M4dm0nky/cyd-buddy/case/README.md

# MadBuddy Gehäuse "Kopf mit Stirn"

Parametrisches OpenSCAD-Gehäuse (OpenSCAD 2021.01) für das ESP32-2432S028 (CYD 2,8", Micro-USB + USB-C) und ein Seeed XIAO ESP32S3 Sense mit Kameraplatine (Linse in der Stirn, schaut nach vorn).

Dateien: `madbuddy_case.scad` und `xiao_cam_common.scad` (Kamera: Tasche, Riegel, XIAO-Wiege, Prüfkörper; gemeinsam mit dem Roboter nutzbar). Teil wählen mit `-D 'part="front"'` (`front`, `back`, `cam_clip`, `frame_test`, `assembly`, `section`, `cam_section`, `collision`, `info`).
Alle Maße stehen oben in der Datei mit Kommentar: `QUELLE: Originalzeichnung`, `GEMESSEN` oder `VORLÄUFIG`.

## Teile

| Teil | Datei | Inhalt |
|---|---|---|
| front | `stl/madbuddy_front.stl` | Kopfschale mit Display-Fenster (nach vorn angefast), Stirn, Kameratasche (Linsenloch Ø 6,7 mit 45°-Fase, Rahmen mit Riegelnuten, FPC-Schlitz), XIAO-Wiege (4 Pfosten), 4 Schraubdome (M3, von hinten) |
| cam_clip | `stl/madbuddy_cam_clip.stl` | Kamera-Riegel: flache U-Platte, 1,2 mm dick, hält den Kamerakörper in der Tasche (1× drucken) |
| back | `stl/madbuddy_back.stl` | Rückwand mit Falz, USB-C-Öffnung, SD-Aussparung, BOOT/RESET-Fenster, Lüftungsschlitze, Platinen-Andrückfüße mit Zentrierstift, Kabelkanal, Fuß mit 15° Neigung |
| frame_test | `stl/madbuddy_frame_test.stl` | flacher Streifen (2 mm Front + Display-Auflage) zum Prüfen von Fenstermaß, Glas-Sitz und Lochbild in ca. 20 min |
| assembly / section | nur Ansicht (`render/*.png`) | alles mit farbigen Prüfkörpern |

## Druck (PETG)

- 0,2 mm Schichthöhe, 3 Wände, ohne Stützen. Die STL-Dateien liegen schon in Druckausrichtung.
- front: Gesicht nach unten auf dem Bett (Fenster und Linsenloch sind Durchbrüche, Fenster-Fase ist ein Überhang von 35°).
- back: Rückseite (Außenfläche) liegt flach unten, der Fuß hat nur 15° Überhang.
- frame_test: Gesicht nach unten.
- cam_clip: flach auf dem Bett (1,2 mm dick, 1 Lage Wandlinie genügt nicht, 3 Wände einstellen).
- Schrauben: 4× M3×8 (Senkung hinten, Kernloch 2,6 mm in den Domen; bei PETG selbstschneidend).
- Mindestwand 2,4 mm, Passungsspiel `fit = 0,3 mm` (Variable).
- **Wer `front` schon gedruckt hat, muss es neu drucken** (Linsenloch, Tasche und Wiege sind neu).

## Kamera und XIAO einbauen (Stufe 2)

1. `front` liegt mit dem Gesicht nach unten. Kamera von hinten in die Tasche legen: Linse (Tubus) durch das Loch Ø 6,7, Körper 8 × 8 an den Anschlag, das FPC zeigt nach +X (rechts im Blick von vorn) und läuft durch den Schlitz.
2. Riegel `cam_clip` von der FPC-Seite in die beiden Nuten schieben, bis der Quersteg am Tascheneck anliegt. Er klemmt mit 0,1 mm Übermaß, kein Kleber nötig (optional ein dünnes Klebepad auf der Kamerarückseite). Das FPC liegt im Riegel-Ausschnitt.
3. XIAO-Stapel (Sense-Platine zur Kamera, Stecker am Ende zur Kamera) zwischen die Pfosten einschieben, bis die Lippen der Klemmstege (je 0,7 mm Schnappmaß) über der Rückseite einrasten. Das FPC in den Klappstecker der Sense-Platine stecken: lockere Schleife, nicht knicken (Biegeradius mindestens 2 mm; die Luftlinie Körperkante bis Stecker ist laut `check.ps1` unter 16 mm). Die Längsseiten des Stapels bleiben für die angelöteten Drähte frei.
4. Rückwand aufsetzen: Ihre Anschlagpfosten enden 0,1 mm unter der Stapelrückseite und halten den Stapel nach hinten. Die Lage des Stapels relativ zur Linse ist `xiao_offset`.

## Prüfung

`& case\check.ps1` (aus PowerShell im Repo-Ordner) führt alles aus (STL ohne Warnungen, Standsicherheit, Standebene, Kollision gegen alle Prüfkörper inkl. Linsen-Freiraum und aktiver Fläche mit Sichtkegel, Selbsttest der Kollisionsprüfung, PNG-Renders). Exitcode ungleich 0 bei jedem Fehler.
Gegenprobe: `check.ps1 -Define window_shrink=2 -NoPng` muss fehlschlagen (Fenster 2 mm schmaler).
Kamera-Prüfungen (ohne `-Define`): Selbsttest (Kamerakörper +0,6 mm muss die Tasche treffen), `clip_test` (Riegel in Einbaulage schneidet den Rahmen durch das Übermaß), Rahmen und Wiege durchdringen das Rückteil nicht und bleiben 0,8 mm innerhalb der Kopfhaut, FPC-Luftlinie (Körperkante bis Stecker) höchstens 16 mm. Bild `render/madbuddy_kamera_schnitt.png` zeigt den Schnitt bei X = 0.

## Maße

- Aus Originalzeichnung (`QUELLE`): Platine 86 × 50, Eckradius 4, Löcher Ø3,2 mit 4,0 mm Randabstand, Displaymodul 69,2 × 50 × 2,3, LCD-Glas 64,75, Fenster = AA + 0,3 mm je Seite. Die Zeichnungs-AA (57,6 × 43,2, mittig im Glas) passte nicht.
- Gemessen (2026-10-26, nach Testdruck): bespielte Fläche 58,8 mm breit (Fenster rechnet mit 59), beginnt 10 mm nach der linken Platinenkante (Blick von vorn). Höhe 44,3 mm ist daraus hochgerechnet (VORLÄUFIG).
- Gemessen: USB-Buchsen-Lage entlang der Schmalseite (Micro ab 9,67 mm, USB-C 17,88 bis 27,32 mm, von der Kante mit dem SD-Slot).
- VORLÄUFIG (Datenblatt/Schätzung): Platinendicke, Displayhöhe über Platine (4,5), Micro-USB-Breite, alle Höhen (z) der Buchsen/Stecker, SD-Slot (Länge, Lage, Höhe), BOOT/RESET-Lage, Rückseitenbauteile (8 mm, Randstreifen), XIAO-Stapel (Höhe 15, Platinendicke 1,2, Lage und Höhe des Kamerasteckers), Tubuslänge der Kamera (2,7), Sichtwinkel, Wandöffnungen, Schwerpunkt-Massen. Kameramaße (OV3660: Körper 8,0, Tiefe 5,3, Tubus Ø 6,2, FPC 21,2 × 6,5) stammen aus der Seeed-Zeichnung; den Aufdruck am eigenen Modul prüfen (`cam_type`).

## Offene Punkte

- Micro-USB hat standardmäßig keine Wandöffnung (`open_micro_usb = false`), Innenfreiraum bleibt.
- SD-Slot liegt in der Konstruktion an der unteren Längskante; dort steht der Kopf auf dem Fuß, die Karte lässt sich dann nur bei angehobenem Gerät stecken. Die Firmware nutzt die SD-Karte nicht (geprüft 2026-10-26), daher bleibt das so.
- Standsicherheit ist eine Schätzung (Massenliste in der SCAD). Ohne die Zusatztiefe `rear_extra = 10` liegt das Lot bei 15° praktisch auf der Kippkante.
- XIAO-USB-C ist im Gehäuse nicht zugänglich (nur Programmierung vor dem Einbau).
- Fenster, Lochbild und Glas-Sitz zuerst mit `frame_test` prüfen. **Stand 2026-10-26: 1. Testdruck: Lochbild passt, Fenster lag falsch, korrigiert, 2. Testdruck steht aus.**
- Strom über den USB-C des CYD nur mit Kabel USB-A auf USB-C (keine CC-Widerstände). Das Netzteil braucht ca. 1 A, weil die Kamera mitversorgt wird.

## Variante 2 Roboter

Sitzender Roboter mit Akku: Kopf mit dem CYD, Oberkörper mit der Kamera in der Brust, Po und Beine mit dem Akkuhalter DFRobot DFR0969 (2 × 18650), Laden per USB-C im Boden. Alle Teile werden gesteckt und teilweise verschraubt. Datei: `madbuddy_roboter.scad` (Teil wählen mit `-D 'part="seat"'`). Spec: `docs/superpowers/specs/2026-10-26-roboter-gehaeuse-design.md` (Form) und `2026-10-27-roboter-druckteile-design.md` (Druckteile).

Stand: druckbar, die Maße des Akkumoduls sind **vorläufig** (Datenblatt, noch nicht nachgemessen).

### Teile

STL liegen in `stl/roboter_<teil>.stl`, schon in Druckausrichtung (ohne Stützen). Die Farben sind der Vorschlag aus dem Entwurf.

| Teil | Farbe | Menge | Hinweis |
|---|---|---|---|
| `head_front` | blau | 1 | Gesicht nach unten; mit eingesetzter Blende und Zierschrauben auch als `head_front_ams` |
| `bezel` | schwarz | 1 | Blende, Steg nach oben |
| `head_back` | blau | 1 | Rückseite auf dem Bett |
| `ear` | gelb | 2 | Außenseite auf dem Bett, Zapfen nach oben |
| `deco` | silber | 1 Platte | 10 flache Zierschrauben-Einlagen (4 Kopf, 4 Brust, 2 Ohr) |
| `torso_front` | orange | 1 | Brust auf dem Bett |
| `torso_back` | orange | 1 | Rückseite auf dem Bett |
| `neck` | schwarz | 1 | stehend auf dem unteren Flansch |
| `arm` | orange | 2 | links = gespiegelte Datei `roboter_arm_l.stl` |
| `hand` | schwarz | 2 | flache Unterseite auf dem Bett |
| `seat` | blau | 1 | auf dem Kopf gedruckt, Fach nach oben offen |
| `bottom` | blau | 1 | Standfläche auf dem Bett |
| `foot` | schwarz | 2 | Rückseite (Zapfenloch) auf dem Bett |

3MF zum Öffnen in Bambu Studio:
- `3mf/roboter_teile.3mf`: alle 18 Druckkörper nebeneinander, jeder bekommt im Slicer seine Farbe.
- `3mf/roboter_ams.3mf`: Gruppe „kopf“ (Kopfschale, Blende, 4 Zierschrauben als drei Bauteile eines Objekts, in Einbaulage) plus die übrigen Teile einzeln. Im Slicer weist man den drei Bauteilen je eine Farbe zu.
- Neu erzeugen: `check_roboter.ps1` (Schritt 1c) oder `tools/make_3mf.ps1`; Werkzeug `tools/stl2_3mf.py` (`--group NAME`, `--end`, `--arrange`).

### Druck (PETG)

- 0,2 mm Schichthöhe, 3 Wände, ohne Stützen, Überhänge höchstens 45°.
- `torso_front`: Stützen nur am Linsenloch (Fase 45° bei geneigter Achse, bis ca. 60° Überhang), z. B. mit Support-Painting/Support-Blocker in Bambu Studio. Überall sonst ohne Stützen.
- Steckzapfen sind als Presspassung gedacht (`fit_peg = 0,15 mm`). Zuerst ein Zapfen-Probestück oder den Fuß drucken und die Passung prüfen; bei Bedarf `fit_peg` ändern.
- Kernlöcher für M3 sind Ø 2,6 mm (selbstschneidend in PETG, mindestens 7,5 mm tief).
- Die Zierschrauben-Einlagen nur als Einlage einkleben oder pressen (Taschen sind 0,15 mm größer).

### Schrauben (M3)

Insgesamt 20 Stück. Jede Zahl ist aus `madbuddy_roboter.scad` belegt; der Beleg nennt Variablen- und Modulnamen (in der Datei suchen), keine Zeilen, weil die Datei wächst.

| Anzahl | Länge | Wo | Beleg |
|---|---|---|---|
| 4 | M3×8 | Kopf: `head_back` an `head_front` | 4 Dome `dome_pts` (`dome_x`, `dome_y`); Länge: `back_t` 2,6 abzüglich `cbore_t` 1,8 plus `pilot_len` 7,5 = 8,3 |
| 2 | M3×10 | Hals oben an `head_back` | Modul `neck_pilots`, `neck_fl_t` 2,8 plus `neck_pilot_len` 7,6; Kommentarblock „MONTAGEFOLGE“, Schritt 2 |
| 2 | M3×10 | Hals unten an `torso_front` | Modul `neck_pilots_t`, Kernloch `neck_pilot_t` 7,6; Kommentarblock „MONTAGEFOLGE“, Schritt 1 |
| 4 | M3×28 | Oberkörper: `torso_back` an `torso_front` | 4 Dome `t_dome_pts`; Länge: `t_d` / 2 = 22 abzüglich `cbore_t` 1,8 plus `t_dome_pilot` 9 = 29,2; Kommentarblock „MONTAGEFOLGE“, Schritt 3 |
| 4 | M3×10 Flachkopf | Oberkörper von unten auf `seat` | `t_seat_pts`, `seat_screw_l = 10`; Einschraubtiefe geprüft mit dem Prüfteil `screw_seat` (`check_roboter.ps1`, Abschnitt 3h) |
| 4 | M3×10 Flachkopf | `bottom` an `seat` | `dome_pts_s`; Länge: `bot_t` 2,4 − `cbore_t` 1,8 + `boss_h` 2,0 + `pilot_s_len` 7,6 = 10,2; Kommentarblock „MONTAGEFOLGE“, Schritt 5 |

Summe: 4 × M3×8, 12 × M3×10, 4 × M3×28. Das passt zur Massenliste „20 × M3“ (Eintrag „Schrauben (20 x M3)“ in der Massenliste). Die Zierschrauben sind gedruckte Einlagen, keine echten Schrauben.

### Montagereihenfolge

1. Hals von oben mit 2 × M3×10 auf `torso_front` schrauben (`torso_back` ist dabei verschraubt, der Kopf fehlt).
2. Rückwand des Oberkörpers abnehmen, Kopf auf den Hals setzen, 2 × M3×10 von unten durch die Halsschlitze eindrehen.
3. Kamera und XIAO einbauen, solange `torso_back` noch abgenommen ist (bei geschlossenem Oberkörper kommt man nicht an die Tasche):
   1. Kameramodul von hinten in die Tasche schieben (Linse durch das Loch), FPC durch den Schlitz nach +X führen.
   2. `cam_clip` (Riegel) von der +X-Seite in die Nuten schieben (Übermaß 0,1 mm, Presssitz).
   3. XIAO-Stapel von hinten zwischen die Pfosten schieben, die Lippen der Pfosten rasten über die Rückseite ein (FPC in den Stecker).
   4. `torso_back` aufschieben und mit 4 × M3×28 schließen: Klemmsteg und Stützwand in `torso_back` legen sich hinter den Stapel. Der Weg ist per Zwischenstellungen geprüft (`asm_cam`, `asm_clip`, `asm_stack`, `asm_close`).
4. Arme in den Oberkörper stecken, Hände auf die Arme stecken, Ohren in den Kopf stecken, Blende in die Nut drücken, Zierschrauben einsetzen.
5. Oberkörper mit Hals und Kopf auf `seat` stecken und von unten mit 4 × M3×10 verschrauben (Schraubendreher durch den offenen Boden).
6. Akku einlegen, 5 V und GND verdrahten (Schalter, Kabel nach oben), `bottom` mit 4 × M3×10 schließen. Füße vorn auf die Beine stecken.

Kamera im Roboter: Der Sichtkegel (102° diagonal, 85° horizontal) wird nur 26 mm lang geprüft, weil die Füße ab ca. 27 mm unten im Bild liegen (Entscheidung 2026-10-28).

Jede Schraube ist im Modell mit einem Schraubendreher-Prüfkörper Ø 6 × 60 auf Erreichbarkeit geprüft (`check_roboter.ps1`, Schritte 3g/3h).

### Prüfung

`& case\check_roboter.ps1` (aus PowerShell im Repo-Ordner): STL aller Teile ohne Warnung, Standsicherheit, Kollisionen, Montage-Erreichbarkeit mit Selbsttests, 3MF (lesbar, größer als 10 kB, richtige Anzahl Objekte und Bauteile), PNG-Renders. Exitcode ungleich 0 bei jedem Fehler.

### Offene Punkte

- Maße des Akkumoduls DFR0969 (Platine, Lage der Buchse, des Schalters, der LED) sind **VORLÄUFIG** nach Datenblatt. Vor dem ersten Druck von `seat` und `bottom` das echte Modul nachmessen.
- Presspassung der Zapfen (`fit_peg`) und die Länge der Schrauben sind noch nicht am gedruckten Teil getestet.
- Die Lage von Schalter und LED im Boden hängt am Modul (siehe oben).
- Kamera-Halter im Oberkörper: eigener Plan `docs/superpowers/plans/2026-10-27-kamera-halter.md`.
