M4dm0nky/cyd-buddy/reference/ha_buddy_ota/README.md

Vorlage aus dem HA-Buddy (ESP32-S3, HA-Medienordner). Nicht kompilieren; Portierung siehe docs/superpowers/specs/2026-10-25-cyd-buddy-design.md Abschnitt 8.
Einzige Änderung gegenüber dem Original: LAN-Adressen in ota-7in.md durch Platzhalter ersetzt (öffentliches Repo).
