M4dm0nky/cyd-buddy/docs/FORTSCHRITT.md

# Fortschritt MadBuddy

Neueste Einträge oben. Format und Regeln: `docs/superpowers/plans/2026-10-25-cyd-buddy.md`, Abschnitt „Fortschritts-Protokoll“.

## Kamera-Firmware Phase A – Task 1: Spike `cam/` (XIAO) – ERLEDIGT, am Gerät gemessen
- Zeit: 2026-10-29 (Sonnet), Branch `feature/kamera-firmware`
- Weg: **Weg 1** (pioarduino 55.03.312-1, Arduino als IDF-Komponente, ESP-DL v3 `human_face_detect`). Grund: baut sauber, neuere ESP-DL; Weg 2 (Arduino-Kern 2.0.17) bleibt Rückfall.
- Anpassungen gegenüber dem Plan: Pixeltyp heißt `DL_IMAGE_PIX_TYPE_RGB565BE` (nicht `..._RGB565`); zusätzlich `CONFIG_AUTOSTART_ARDUINO=y` in `cam/sdkconfig.defaults`, sonst fehlt `app_main` beim Linken. Erzeugtes (`managed_components/`, `dependencies.lock`, `sdkconfig.cam`, `CMakeLists.txt`) steht in `cam/.gitignore`.
- Build: SUCCESS, Flash 908 009 B von 3 342 336 B (27,2 %), RAM 36 516 B (11,1 %).
- Neu: `cam/` (Kamera, Erkennung, Mess-`main.cpp`), `src/logic/cam_xiao.h` (`CamFace`, `cam_box_to_face`), `tools/cam-serial.py` (pyserial 3.5 vorhanden).
- Am Gerät (COM7, Kabel-Flash, Opus mit Nutzer): PSRAM 8 MB, Kamera und Erkennung starten. **10–12 Bilder/s, 77–83 ms pro Bild** → Weg 1 bleibt. Gesicht aufrecht im Bild: 17 Treffer mit RGB565**BE**, 0 mit LE (Diagnose lief beide abwechselnd) → BE ist richtig.
- Gefunden und behoben:
  - Konsole und `Serial` lagen auf UART0 = GPIO 43/44 (genau die CYD-Leitung) → `CONFIG_ESP_CONSOLE_USB_SERIAL_JTAG=y`, `-DARDUINO_USB_MODE=1 -DARDUINO_USB_CDC_ON_BOOT=1`.
  - „Do not support Concat“ + Absturz beim Modell-Laden: esp-dl baut nur die Operatoren angemeldeter Modelle; angemeldet hatte nur `esp-sr` (kommt mit dem Arduino-Kern). → `custom_component_remove = espressif/esp-sr`, damit `DL_COMPILE_ALL 1`.
  - Build im Dropbox-Ordner scheitert (Cloud-Platzhalter, WinError 32; `com.dropbox.ignored` greift hier nicht). → `tools/cam-build.ps1` spiegelt `cam/` und `src/logic/` nach `%LOCALAPPDATA%\3zoll-cam` und baut dort (`-Upload -Port COM7` zum Flashen). Bin: `%LOCALAPPDATA%\3zoll-cam\cam\.pio\build\cam\firmware.bin`.
- Lage der Kamera: Beim Halten in der Hand stand das Bild auf dem Kopf; aufrecht wird erkannt. Die Drehung (`CAM_FLIP_180`, per `set_vflip`/`set_hmirror`) wird erst beim Einbau festgelegt.

## Kamera + Gehäuse – Teil 1: Gehäuse-Entwurf – ERLEDIGT, wartet auf Testdruck
- Zeit: 2026-10-26 (Opus plant und prüft, Sonnet baut das SCAD-Modell), Branch `feature/kamera-gehaeuse`
- Entscheidung: Kamera = **Seeed XIAO ESP32S3 Sense** (eigener Rechner mit PSRAM, erkennt Gesichter selbst, schickt dem CYD nur Koordinaten). Direkt am CYD geht keine Kamera: Es sind nur GPIO 22/27/35 frei, und PSRAM fehlt. Bestellt **ohne Header**. Spec: `docs/superpowers/specs/2026-10-26-kamera-gehaeuse-design.md`.
- Gemacht: `case/madbuddy_case.scad` (parametrisch, OpenSCAD 2021.01 per winget), Form „Kopf mit Stirn“ 114 × 82 × 30 mm, Linse mittig über dem Display, Fuß mit 15°, nur USB-C nach außen (`open_micro_usb = false`), STL-Dateien `front`/`back`/`frame_test`, Prüfskript `case/check.ps1`.
- Maße: Platine, Löcher und Display aus der Originaldoku (witnessmenow/ESP32-Cheap-Yellow-Display: `Dimensions.png`, Datenblatt JC2432A028N). USB-Lage vom Nutzer gemessen (ab SD-Kante: Micro ab 9,67 mm, USB-C 17,88–27,32 mm). Die übrigen Werte sind im SCAD als VORLÄUFIG markiert.
- Prüfung: `& case\check.ps1 -NoPng` → alles grün (3 STL ohne Warnung, Stand: Lot 6,9 mm vor der hinteren Kippkante, nichts unter dem Fuß, Kollision leer, Selbsttest erkennt Treffer). Gegenprobe `-Define window_shrink=2` → `[FAIL] Kollision` (288 Facetten), exit 1. Danach läuft kein OpenSCAD-Prozess mehr.
- Hinweis: `powershell -ExecutionPolicy Bypass` wird von der Rechteprüfung abgelehnt, deshalb das Skript direkt mit `& case\check.ps1` starten.
- Nächster Schritt: Nutzer druckt `case/stl/madbuddy_frame_test.stl` und meldet die Passung (Fenster über der Leuchtfläche, Lochbild). Danach Maße anpassen und das ganze Gehäuse drucken.
- Offen: Teil 2 Verkabelung (Pinreihenfolge P1/CN1 am Foto prüfen, bevor gelötet wird). Teil 3 Firmware (`cam/` für den XIAO, `src/logic/cam_link.*` + `Serial2` am CYD), wird geplant, sobald die Hardware da ist. Der USB-C des XIAO ist im eingebauten Zustand nicht erreichbar, deshalb vor dem Einbau flashen und danach per WLAN aktualisieren.

## Umbenennung CYD-Buddy -> MadBuddy – ERLEDIGT (2026-10-25)

Umbenennung CYD-Buddy -> MadBuddy (Portal, mDNS madbuddy.local, Repo M4dm0nky/madbuddy).

## Lokal 4 – Code-Review und Fixes – ERLEDIGT
- Zeit: 2026-10-25 (Review: 3 Sonnet-Prüfer, Funde von Opus am Code/Core-Quellen bestätigt; Fixes: Sonnet in Paketen A/B/C + Nachtrag)
- Behoben: 24,8-Tage-Fehler aller langlebigen Zeitpunkte (`logic/deadline.h`, `due_since`), Nickerchen weckbar, OTA-Umleitung lehnt `@`/fremde Ports ab, Claude-Reihenfolge (späte Ereignisse), Empfänger prüft Schlüssel/Länge vor dem Körper + Handler einmal + Multipart-Grenzen, **Rollback wirksam** (`verifyRollbackLater`, `health_tick` unabhängig vom WLAN), Stall-Lücke im Download, Start-Absicherung (Touch-Warten 10 s, Kalibrier-Plausibilität), 5. Tipp außerhalb der Augen, Simon-Zeitlimit 30 s, Rückblick ignoriert erste Sekunde, Sprite-Neuversuch, OTA-Karte nicht während Arbeit, Speichern vor OTA-Neustart (Haupt-Task), Einstellungen ohne Flackern, Animationen ohne Float-Drift, Aufräumen (testscreen, tote Felder, Kommentare, Doku).
- Prüfung: 180/180 nativ, 18/18 Node, Build Flash 1 475 391 B. Am Gerät (v20261025-2011): `Zustand 1` nach OTA, nach 20 s „neue Firmware als gut bestaetigt“; curl: 100 KB ohne Schlüssel 401, falscher Schlüssel 401, 5 KB 413, Content-Length 1 MB gelogen 413 (alle < 0,35 s, danach Verbindungsabbruch wie vorgesehen), Multipart ohne Schlüssel 401, gültig 204, Ping 200; Heap danach 120 KB, Minimum 60 212 B (vorher 49 776 B); fps 24–26.
- Offen (nicht im Paket): Bildrate (SPI 80 MHz testen, Ring-Spur, Brillen-Raster), Aufteilung von `app.cpp`, Projektkennung im Image generisch, keine Signatur.

## Lokal 3 – Gesicht, F1–F4, Umlaute, Claude-Modus am Gerät – ERLEDIGT
- Zeit: 2026-10-25 (lokal, Opus orchestriert; Sonnet/Haiku umgesetzt; Qwen Sätze-Entwurf)
- Gemacht: Gesicht mit Brauen/Pupillen/Nase/Mund und 22 Ausdrücken; F1–F4 aus der Cloud übernommen und einzeln ausgeliefert (v20261025-1529/-1539/-1549/-1611); echte Umlaute mit U8g2 Latin-1 (v-1637); Claude-Modus (Zustandslogik, HTTP-Empfänger mit Schlüssel, Darstellung, Hook-Skript; v-1648/-1703), globale Hooks in `~/.claude/settings.json` (Sicherung `settings.json.bak-20261025-1703`).
- Prüfung: `pio test -e native` → 153/153; `node --test` (ota-publish, gen-phrases, claude-hooks) → 18/18; `pio run -e cyd2usb` → Flash 1 473 891 B. Am Gerät: Endpunkte 200/401/413/400 gemessen; Hook-Ereignisse kommen an (`running` während Bash); Nutzer bestätigt drehenden Ring, „Mist!“ bei Fehler, Blick + gelbe LED bei Rückfrage; fps 24–26 (Ring kurz 24), Heap-Minimum 49 776 B (vorher 63 KB, Webserver).
- Gefunden & behoben: Open-Meteo chunked → `useHTTP10`; Sonnenbrille zu hoch/blind → mittig + Schachbrett-Raster; erstes Hook-Ereignis ging verloren, weil Node `cyd-buddy.local` beim ersten Mal langsamer als 800 ms auflöst → Konfiguration zuerst per IP (192.168.2.137), Name als Ersatz; Sätze-Check CRLF unter Windows.
- Offen: fps mit Ring knapp unter 25; Heap-Minimum 49,8 KB knapp für TLS (OTA-Abruf im Blick behalten, ggf. Sprite während Manifest-Abruf freigeben); feste IP im Router (Nutzer); Mitte-unten-Touch reagiert kaum (Panel).

## Interaktion Task 10 – Abschluss – ERLEDIGT
- Zeit: 2026-10-25 14:22 UTC
- Gemacht: README-Bedienung ergänzt (High-Five, Blick folgt, Menü 2×3, Füttern, Timer, Sprechblasen, Rituale, Rückblick, Hunger/Krankheit/Charakter); dabei die veralteten Abschnitte „Schlaf“ (jetzt Uhrzeit + Ruhe) und „Testbild“ (jetzt Touch-Einrichtung) an den lokalen Stand angepasst; Sätze-Generator unter Entwicklung. Abschlussprüfung.
- Dateien: README.md
- Prüfung: `pio test -e native` → 124 Tests, 0 Fehler (14 Gruppen; 78 alte + 46 neue: look 4, phrases 3, speech 14, care 17, pomodoro 5, je 1 neu in mood, face_model, weather_mood). `node --test tools/*.test.mjs` → 7 Tests, 0 Fehler. `node tools/gen-phrases.mjs --check` → aktuell. `pio run -e cyd2usb` → SUCCESS, RAM 17,5 % (57 340 B, +376 B gegenüber 56 964 B vor F1), Flash 74,5 % (1 464 019 B); `firmware.bin` 1 493 696 B < 1 966 080 B
- Gegenprobe: je Logik-Gruppe in Task 1, 2, 3, 4, 6, 7, 8 (siehe dort)
- Nächster Schritt: **Lokaler Claude** übernimmt `claude/dreamy-galileo-bvdw39` nach `buddy-umsetzung` (Fast-Forward), prüft am Gerät und veröffentlicht je Funktion ein Release (Spec: F1–F4 einzeln). Hinweis: Alle vier Funktionen liegen in einem Branch; für getrennte Releases die Commits von Task 1–2 (F1), 3–5 (F2), 6–7 (F3), 8–9 (F4) nacheinander bauen.
- Offen/Fragen (Sammlung): (1) Branch `claude/dreamy-galileo-bvdw39` statt `buddy-umsetzung` (Sitzungsvorgabe). (2) frech/verschmust über die Achse `cuddly` (Task 4). (3) SICK als erstes *Grundgefühl* (Task 6). (4) Rückblick-Schwellen, Nacht-Ritual 22:00–22:59 (Task 4). (5) Ring als Ellipse (Task 9). (6) FEED-Bildschirm mit Schließen-Kreuz (Task 7). (7) `store_load` übernimmt alle Versionen 1…3. Keine Sätze ergänzt, `saetze.json` unverändert; `src/ota/*`, `ota_policy.h`, `ota-publish.mjs`, `display.h`, `config.h`, `main.cpp` unverändert. Kein Release, kein Flash, kein PR.
- Am Gerät zu prüfen: **F1** Pupillen folgen dem Finger, High-Five in beiden oberen Ecken (Hand, LED weiß), Mitte oben = normales Tippen. **F2** Blasen lesbar (Breite, Umlaute als ae/oe/ue), höchstens alle 90 s, Morgengruß + „Heute …° und …“, 22-Uhr-Gähnen, Rückblick um 20 Uhr und Nachholen per Berührung bis 23 Uhr, Zähler nach Neustart erhalten (NVS v3). **F3** Menü 2×3 trifft, Fütter-Bildschirm, Flug + Kauen, lecker/Lieblingsessen/satt, Hunger-Gesicht, Krankheit + Hatschi (zum Testen Werte im NVS senken), Heilung, Charakter-Balken. **F4** Timer starten/stoppen, FOCUSED-Gesicht, Ring, Restzeit, LED 5× grün / 2× blau, Pomodoro-Zähler im Rückblick. Überall: fps ≥ 25, Heap-Minimum.

## Interaktion Task 9 – Pomodoro (UI) – ERLEDIGT
- Zeit: 2026-10-25 14:21 UTC
- Gemacht: Step 3: `app.cpp` – Menü → TIMER (15/25/45 starten mit Blase „pomodoro_start“, Stopp, Zurück). Während WORK: Gefühl FOCUSED (außer Schlaf), keine Eigenarten, keine Blasen außer Start, keine Rituale, Tippen ohne Überraschung (nur Blick folgt), kein Nacht-/Nickerchen-/Dunkel-Schlaf. Ring im Sprite (Arbeit pink, Pause grün), Restzeit im Statusstreifen. BREAK_START: EXCITED 3 s, „pomodoro_pause“, LED 5× grün, `pomodoros` +1. BREAK_END: „pomodoro_fertig“, LED 2× blau, danach IDLE. Pomodoro läuft auf allen Bildschirmen weiter.
- Dateien: src/app.cpp
- Prüfung: `pio run -e cyd2usb` → SUCCESS, RAM 17,5 % (57 340 B), Flash 74,5 % (1 464 019 B). `pio test -e native` → 124 Tests, 0 Fehler
- Gegenprobe: – (UI)
- Nächster Schritt: Interaktion Task 10
- Offen/Fragen: (1) Streicheln/Stupsen ändern während der Arbeit weiter Werte und Zähler, nur ohne Blase. (2) Läuft beim Pausenbeginn ein anderer Bildschirm, ist die Blase nach 4 s weg; die LED blinkt trotzdem.
- Am Gerät zu prüfen: Timer-Kacheln treffen, Ring flüssig (fps ≥ 25), Restzeit läuft, LED-Signale, FOCUSED-Gesicht.

## Interaktion Task 9 – Pomodoro (UI) – TEILWEISE
- Zeit: 2026-10-25 14:19 UTC
- Gemacht: Step 2: Fortschrittsring als dünne Ellipse am Sprite-Rand (rx ~153, ry ~96, dunkle Spur + Bogen im Uhrzeigersinn ab oben, `eyes_set_ring(progress, Farbe)`), Restzeit mm:ss im Statusstreifen (`StatusInfo.timer_s/timer_break`, Arbeit pink, Pause grün).
- Dateien: src/ui/eyes.h, src/ui/eyes.cpp, src/ui/status_bar.h, src/ui/status_bar.cpp
- Prüfung: `pio run -e cyd2usb` → SUCCESS
- Gegenprobe: –
- Nächster Schritt: Interaktion Task 9 Step 3 (Verdrahtung in app.cpp: TIMER-Bildschirm, FOCUSED, keine Eigenarten/Blasen außer Start, kein Schlaf während WORK, BREAK_START/END mit Blase und LED, Zähler)
- Offen/Fragen: Ring als Ellipse statt Kreis: ein Kreis um die Mitte schnitte die äußeren Augenränder (x 58 bei Radius 98).

## Interaktion Task 9 – Pomodoro (UI) – TEILWEISE
- Zeit: 2026-10-25 14:18 UTC
- Gemacht: Step 1: Bildschirm TIMER `src/ui/timer_view.*` (Kacheln 15/25/45 mit Sanduhr, Zurück; läuft ein Timer: Stopp-Kachel mit Quadrat + Zurück; 10 s Timeout).
- Dateien: src/ui/timer_view.h, src/ui/timer_view.cpp
- Prüfung: `pio run -e cyd2usb` → SUCCESS
- Gegenprobe: –
- Nächster Schritt: Interaktion Task 9 Step 2 (Fortschrittsring im Sprite, Restzeit im Statusstreifen), Step 3 (Verdrahtung: FOCUSED, LED-Signale, Zähler)
- Offen/Fragen: –

## Interaktion Task 8 – Pomodoro (Logik) – ERLEDIGT
- Zeit: 2026-10-25 14:16 UTC
- Gemacht: `src/logic/pomodoro.h`: Zustände IDLE/WORK/BREAK, `pomo_start` (nur 15/25/45 min), Pause fest 5 min, `pomo_tick` → NONE/BREAK_START/BREAK_END (nächste Phase beginnt am Ende der vorigen), nach BREAK_END IDLE, `pomo_stop`, `pomo_progress` 0..1, `pomo_remaining_s` aufgerundet.
- Dateien: src/logic/pomodoro.h, test/test_pomodoro/test_main.cpp
- Prüfung: `pio test -e native -f test_pomodoro` vorher → ERRORED (Header fehlt); danach 5 Tests, 0 Fehler
- Gegenprobe: Pause ab spätem Abfragen statt Phasenende → `test_late_tick…: Expected 240 Was 300`; Restzeit abgerundet → `Expected 1500 Was 1499`; jede Minutenzahl erlaubt → `test_start_only_15_25_45` FAIL; alles zurück → 5 PASS
- Nächster Schritt: Interaktion Task 9 Step 1
- Offen/Fragen: –

## Interaktion Task 7 – Füttern und Charakter (UI) – ERLEDIGT
- Zeit: 2026-10-25 14:15 UTC
- Gemacht: Step 5: Info-Zeile der Einstellungen mit zwei Charakter-Balken (Herz ↔ Blitz für `cuddly`, Ball ↔ Kissen für `playful`; Mitte = 0, Ausschlag zur jeweiligen Seite). Info-Text gekürzt auf Build-Datum + „Heap …k Licht …“.
- Dateien: src/ui/settings.cpp, src/app.cpp
- Prüfung: `pio run -e cyd2usb` → SUCCESS, RAM 17,5 % (57 292 B), Flash 73,9 % (1 452 891 B). `pio test -e native` → 119 Tests, 0 Fehler
- Gegenprobe: – (UI)
- Nächster Schritt: Interaktion Task 8
- Offen/Fragen: –
- Am Gerät zu prüfen: Menü 2×3 trifft (Touch-Kalibrierung), Fütter-Bildschirm, Flug + Kauen flüssig, Reaktionen (lecker / Lieblingsessen / satt), Hatschi bei Krankheit, Charakter-Balken.

## Interaktion Task 7 – Füttern und Charakter (UI) – TEILWEISE
- Zeit: 2026-10-25 14:14 UTC
- Gemacht: Step 4: `OV_SNEEZE = 2048` + Test; Tropfen an der Nase und Augen 600 ms zu, Blase „krank“. Füttern: Menü → FEED → Speise fliegt 600 ms von unten zum Mund (ins Sprite), Mund kaut 3× (mouth_open 0↔0,6 alle 200 ms), dann `food_feed` → Reaktion + Blase, `meals`-Zähler. Charakter: Streicheln/Stupsen/Spiel/High-Five/Langeweile ändern `cuddly`/`playful`, `mood_set_character` jedes Bild, Gedanken-Blasen nach `cuddly`. Krankheit, Charakter, Lieblingsessen (beim ersten Start ausgelost) werden gespeichert.
- Dateien: src/logic/weather_mood.h, test/test_weather_mood/test_main.cpp, src/ui/eyes.h, src/ui/eyes.cpp, src/app.cpp
- Prüfung: `pio test -e native -f test_weather_mood` vorher → ERRORED (`OV_SNEEZE` fehlt), danach 7 Tests, 0 Fehler. `pio run -e cyd2usb` → SUCCESS, RAM 17,5 % (57 292 B), Flash 73,9 % (1 452 207 B)
- Gegenprobe: `OV_SNEEZE = 4096` → `test_hand_bit: Expected 2048 Was 4096`; zurück → PASS
- Nächster Schritt: Interaktion Task 7 Step 5 (Charakter-Balken im Info-Bereich der Einstellungen)
- Offen/Fragen: –

## Interaktion Task 7 – Füttern und Charakter (UI) – TEILWEISE
- Zeit: 2026-10-25 14:12 UTC
- Gemacht: Step 3: Bildschirm FEED `src/ui/feed.*` (Sättigungsbalken grün ≥ 60 / gelb ≥ 25 / rot, Thermometer bei Krankheit, Schließen oben rechts, 4 Kacheln Apfel/Pizza/Kuchen/Kaffee, 10 s Timeout). Neue Symbole `icon_food`, `icon_thermometer`, `icon_ball`, `icon_pillow`, `icon_stop`.
- Dateien: src/ui/feed.h, src/ui/feed.cpp, src/ui/icons.h, src/ui/icons.cpp
- Prüfung: `pio run -e cyd2usb` → SUCCESS
- Gegenprobe: –
- Nächster Schritt: Interaktion Task 7 Step 4 (Flug-/Kau-Animation, OV_SNEEZE, Verdrahtung Charakter/Krankheit/Füttern in app.cpp), Step 5 (Charakter-Balken in den Einstellungen)
- Offen/Fragen: Schließen-Kreuz im FEED-Bildschirm ist eine Ergänzung (Spec nennt nur „Tipp → zurück zum Gesicht“ nach der Wahl).

## Interaktion Task 7 – Füttern und Charakter (UI) – TEILWEISE
- Zeit: 2026-10-25 14:10 UTC
- Gemacht: Step 2: Menü 2×3 (Kacheln 96×90, Abstand 8): Spielen grün, Füttern orange (Apfel), Timer rot-violett (Sanduhr), Uhr gelb, Einstellungen violett, Schließen rot; Spielen-Ebene: Fang mich, Simon, Zurück. `MenuChoice::FEED/TIMER` neu (in app.cpp noch ohne Wirkung).
- Dateien: src/ui/menu.h, src/ui/menu.cpp
- Prüfung: `pio run -e cyd2usb` → SUCCESS
- Gegenprobe: –
- Nächster Schritt: Interaktion Task 7 Step 3 (FEED-Bildschirm `src/ui/feed.*`)
- Offen/Fragen: –

## Interaktion Task 7 – Füttern und Charakter (UI) – TEILWEISE
- Zeit: 2026-10-25 14:09 UTC
- Gemacht: Step 1: `Persist` um `sick`, `cuddly`, `playful`, `favorite_food` erweitert (Sättigung in `needs.satiety`), NVS-Schlüssel `sat sick cud pla fav`, `kVersion` 3 mit Übernahme von 1/2.
- Dateien: src/hw/store.h, src/hw/store.cpp
- Prüfung: `pio run -e cyd2usb` → SUCCESS
- Gegenprobe: –
- Nächster Schritt: Interaktion Task 7 Step 2 (Menü 2×3 mit Füttern/Timer), Step 3 (FEED-Bildschirm), Step 4 (Flug-/Kau-Animation, OV_SNEEZE, Verdrahtung), Step 5 (Charakter-Balken in den Einstellungen)
- Offen/Fragen: –

## Interaktion Task 6 – Füttern, Krankheit, Charakter (Logik) – ERLEDIGT
- Zeit: 2026-10-25 14:08 UTC
- Gemacht: `mood.h`: `Needs.satiety` (Start 70, wach −0,12/min, schlafend −0,04/min, auch für die Aus-Zeit), Grundgefühl HUNGRY bei < 25 (nach SLEEPY, vor SAD), Krankheit nach 2 h ununterbrochen Sättigung < 15 und Zuneigung < 20 (SICK als erstes Grundgefühl, doppelter Energie-Abbau, `mood_sneeze_due` alle 1–3 min), Heilung bei Sättigung > 60 und danach 3× Streicheln → HAPPY 3 s. Neue Emotionen HUNGRY, FULL, SICK, FOCUSED mit Werten aus der Spec in `face_expression`. `food.h` (`food_effect`, `food_feed` → Say LECKER/LIEBLINGSESSEN/SATT, FULL bei > 95). `character.h` (`cuddly`/`playful` mit den Spec-Schritten, ±100, Wirkung über `mood_set_character`: Eigenarten-Abstand, CHEEKY-Wahrscheinlichkeit, LOVE-Dauer). `speech_for_base` kennt jetzt HUNGRY/SICK.
- Dateien: src/logic/mood.h, src/logic/food.h, src/logic/character.h, src/logic/face_model.h, src/logic/speech.h, test/test_care/test_main.cpp, test/test_face_model/test_main.cpp
- Prüfung: `pio test -e native -f test_care` vorher → ERRORED (`logic/food.h` fehlt); `test_face_model` vorher → `test_new_emotions_f3_f4: Expected 8 Was 0`. Danach `pio test -e native` → 119 Tests, 0 Fehler (alle bestehenden unverändert grün). `pio run -e cyd2usb` → SUCCESS
- Gegenprobe: Hunger-Grenze 25 → 20 → `test_hungry_rank` FAIL; Krankheit nach 1 h → 2 Tests FAIL; Heilung nach 2× Streicheln → `test_heal…` FAIL; satt ab > 94 → `test_feed_full_strictly_above_95` FAIL; Eigenarten-Abstand ohne Charakter → 2 Tests FAIL; FOCUSED open .75 → `test_new_emotions_f3_f4` FAIL; alles zurück → 119 PASS
- Nächster Schritt: Interaktion Task 7 Step 1
- Offen/Fragen: (1) „SICK Rang direkt nach SLEEPING“ als *Grundgefühl* umgesetzt (vor SLEEPY), kurzzeitige Gefühle (z. B. Reaktion aufs Essen) gehen weiter vor. (2) Eigenarten wählen CHEEKY jetzt mit `cheeky_prob` (Start 0,5) statt Münzwurf über ein Bit – bestehender Test „beide kommen vor“ grün. (3) Heil-Streicheln zählen jede STROKE-Geste (auch im 2-s-Cooldown), sobald die Sättigung > 60 ist. (4) Kaffee gibt laut Spec nur Sättigung/Energie; Lieblingsessen kann auch Kaffee sein.

## Interaktion Task 5 – Sprechblasen und Rückblick (UI) – ERLEDIGT
- Zeit: 2026-10-25 14:03 UTC
- Gemacht: Step 3: `app.cpp` – Blase 4 s (ins Sprite), Gedanken/Gefühlswechsel über `speech_due`, Ereignis-Sätze (STROKE → verliebt 25 % mit 90-s-Abstand, POKE → genervt, High-Five → highfive, Gewitter-Schreck → gewitter, neues Wetter mit geändertem Himmel → hitze/kalt/regen/sonne), Rituale (Morgen: GREETING + „morgen“, 4 s später Tageswetter „Heute 14° und Regen“; Nacht 22 Uhr: YAWN + „nacht“; Rückblick 20 Uhr bzw. Nachholen bei Berührung bis 23 Uhr → Bildschirm `REVIEW`, Tippen schließt). Tageszähler (Streicheln, Stupsen, Spiele, Siege) in `Persist.day`, NVS-Schlüssel `d_*`, `kVersion` 2 (Stand 1 wird übernommen, fehlende Schlüssel → 0).
- Dateien: src/app.cpp, src/hw/store.h, src/hw/store.cpp
- Prüfung: `pio run -e cyd2usb` → SUCCESS, RAM 17,5 % (57 220 B, +224 B gegenüber Task 0), Flash 73,6 % (1 447 827 B). `pio test -e native` → 101 Tests, 0 Fehler
- Gegenprobe: – (UI)
- Nächster Schritt: Interaktion Task 6
- Offen/Fragen: (1) `store_load` nimmt jetzt jede Version 1…kVersion an (vorher nur genau kVersion), damit Bedürfnisse/Helligkeit/Ort nach dem Update bleiben. (2) Ereignis-Blasen (POKE, High-Five, Gewitter, Wetter) ersetzen eine gerade sichtbare Blase. (3) „gestreichelt“ zählt STROKE-Gesten (alle 1,5 s beim Dauerstreicheln eine).
- Am Gerät zu prüfen: Blase lesbar und Brauen nur kurz überdeckt, Morgengruß + Wettersatz, 22-Uhr-Gähnen, Rückblick um 20 Uhr, Zähler nach Neustart erhalten.

## Interaktion Task 5 – Sprechblasen und Rückblick (UI) – TEILWEISE
- Zeit: 2026-10-25 14:01 UTC
- Gemacht: Step 2: Bildschirm REVIEW `src/ui/review.*` („Dein Tag mit mir“, 5 Zeilen Symbol + Zahl: gestreichelt, gestupst, Spiele gewonnen/gesamt, gegessen, Pomodoros; unten kleines Augenpaar mit `daystats_mood`; 12 s). Neue Symbole `icon_heart`, `icon_bolt`, `icon_apple`, `icon_hourglass`.
- Dateien: src/ui/review.h, src/ui/review.cpp, src/ui/icons.h, src/ui/icons.cpp
- Prüfung: `pio run -e cyd2usb` → SUCCESS (vor der Verschiebung des Augenpaars nach unten; die Verschiebung ist eine Zahl)
- Gegenprobe: – (UI)
- Nächster Schritt: Interaktion Task 5 Step 3 (Verdrahtung in app.cpp: Blasen, Ereignis-Sätze, Rituale, Rückblick-Bildschirm, Tageszähler in Persist/NVS mit kVersion 2)
- Offen/Fragen: –

## Interaktion Task 5 – Sprechblasen und Rückblick (UI) – TEILWEISE
- Zeit: 2026-10-25 13:58 UTC
- Gemacht: Step 1: `src/ui/bubble.*` (abgerundete Blase oben mittig y 2..32, hellgrau, Zipfel nach unten, Text schwarz FreeSansBold9pt7b über ascii.h, Breite nach Text). `eyes_draw(..., const char *bubble = nullptr)` zeichnet sie ins Sprite.
- Dateien: src/ui/bubble.h, src/ui/bubble.cpp, src/ui/eyes.h, src/ui/eyes.cpp
- Prüfung: `pio run -e cyd2usb` → SUCCESS
- Gegenprobe: – (UI)
- Nächster Schritt: Interaktion Task 5 Step 2 (Bildschirm REVIEW `src/ui/review.*`), dann Step 3 (Verdrahtung: Sätze, Rituale, Tageszähler in NVS)
- Offen/Fragen: –

## Interaktion Task 4 – Sprechregeln, Rituale, Tageszähler – ERLEDIGT
- Zeit: 2026-10-25 13:56 UTC
- Gemacht: `speech.h` (`speech_init/pick/may/shown/due`: 90 s Abstand, 40 % beim Wechsel des Grundgefühls zu BORED/SAD/HAPPY, Gedanken alle 5–10 min, bei |cuddly| > 40 verschmust/frech, kein Satz zweimal hintereinander je Kategorie), `rituals.h` (Morgen 5–12 Uhr einmal pro Tag beim ersten Aufwachen, Nacht 22 Uhr einmal, Rückblick 20:00 bzw. Nachholen bei Berührung bis 23 Uhr, `weather_sentence` „Heute 14° und Regen“, `day_key`), `daystats.h` (Zähler, `daystats_roll` setzt bei neuem Tag zurück, `daystats_mood` für den Rückblick).
- Dateien: src/logic/speech.h, src/logic/rituals.h, src/logic/daystats.h, test/test_speech/test_main.cpp
- Prüfung: `pio test -e native -f test_speech` vorher → ERRORED (`logic/speech.h` fehlt); danach 14 Tests, 0 Fehler. `pio test -e native` → 101 Tests, 0 Fehler
- Gegenprobe: Wiederholungs-Sperre aus → `test_pick_never_repeats` FAILED; 90 s → 60 s → `test_cooldown_90s` FAILED; Rückblick bis 23 → bis einschl. 23 → `test_review_20_or_catch_up_until_23` FAILED; `pokes > strokes` → `>=` zunächst **nicht** erkannt → Test ergänzt (gleich viel Streicheln wie Stupsen → CONTENT), dann FAILED; alles zurück → PASS
- Nächster Schritt: Interaktion Task 5 Step 1
- Offen/Fragen: (1) „frech bzw. verschmust“: Spec sagt nur „|Charakter| > 40“. Umgesetzt mit der Achse `cuddly`: > 40 → verschmust, < −40 → frech (passt zu „CHEEKY-Wahrscheinlichkeit 0,5 − cuddly/200“). (2) HUNGRY/SICK als Grundgefühl gibt es erst mit Task 6; `speech_for_base` bekommt sie dort. (3) Nacht-Ritual: „um 22:00“ als erstes wache Bild zwischen 22:00 und 22:59 (sonst ginge es verloren, wenn er genau um 22:00 in einem Menü ist). (4) Schwellen im Rückblick-Gefühl (≥ 10 Streicheln → HAPPY, ≥ 5 Stupsen und mehr als Streicheln → ANNOYED) sind meine Wahl, die Spec nennt keine Zahlen. (5) `speech_init` bekommt zusätzlich die Startzeit.

## Interaktion Task 3 – Sätze als Header – ERLEDIGT
- Zeit: 2026-10-25 13:53 UTC
- Gemacht: `tools/gen-phrases.mjs` erzeugt aus `saetze.json` den Header `src/logic/phrases.h` (`enum class Say` in JSON-Reihenfolge ohne `_quelle`, Tabellen `const char *const` UTF-8, `say_list(Say)` → {items, n}); `--check` meldet einen veralteten Header. Erzeugte Datei mit committet. Sätze unverändert.
- Dateien: tools/gen-phrases.mjs, tools/gen-phrases.test.mjs, src/logic/phrases.h, test/test_phrases/test_main.cpp
- Prüfung: `node --test tools/gen-phrases.test.mjs` vor dem Skript → ERR_MODULE_NOT_FOUND; vor dem Erzeugen 3/4 (Test „eingecheckte phrases.h ist aktuell“ FAIL); danach `node --test tools/*.test.mjs` → 7 Tests, 0 Fehler. `pio test -e native -f test_phrases` → 3 Tests, 0 Fehler (24 Kategorien, je ≥ 6, nach ASCII ≤ 28 Zeichen, kein unbekanntes Zeichen). `pio run -e cyd2usb` → SUCCESS
- Gegenprobe: Grenze 28 → 20 → `test_ascii_max_28: Hallo du! Endlich wach. [FAILED]`; zurück → PASS
- Nächster Schritt: Interaktion Task 4
- Offen/Fragen: –

## Interaktion Task 2 – Blick folgt und High-Five (UI) – ERLEDIGT
- Zeit: 2026-10-25 13:51 UTC
- Gemacht: Step 2: Hand (Handfläche, 4 Finger, Daumen zur Mitte) in Augenfarbe in der getippten oberen Ecke, ploppt in 150 ms auf (`eyes_set_hand(right, since)`). Step 3: `app.cpp` – solange der Finger auf dem Augen-Bildschirm liegt (Touch-Beginn und Streicheln) `look_at`, aktives Blickziel ersetzt den Gazer; TAP in Ecke → `MoodEvent::HIGHFIVE` statt TAP, `OV_HAND` 1,5 s, LED 250 ms weiß.
- Dateien: src/ui/eyes.h, src/ui/eyes.cpp, src/app.cpp
- Prüfung: `pio run -e cyd2usb` → SUCCESS, RAM 17,4 % (56 996 B, +32 B), Flash 73,1 % (1 437 795 B). `pio test -e native` → 84 Tests, 0 Fehler
- Gegenprobe: – (UI)
- Nächster Schritt: Interaktion Task 3
- Offen/Fragen: Blickziel wird in jedem Bild mit Finger neu gesetzt (nicht nur bei Beginn) – deckt „während des Streichelns“ ab, Pupillen folgen also auch beim Halten.
- Am Gerät zu prüfen: Pupillen folgen dem Finger, High-Five in beiden oberen Ecken (Hand, LED weiß, EXCITED), Mitte oben bleibt normales Tippen.

## Interaktion Task 2 – Blick folgt und High-Five (UI) – TEILWEISE
- Zeit: 2026-10-25 13:49 UTC
- Gemacht: Step 1: `OV_HAND = 1024` in weather_mood.h + Test `test_hand_bit` (Bit-Wert, `overlays_for` setzt es nie).
- Dateien: src/logic/weather_mood.h, test/test_weather_mood/test_main.cpp
- Prüfung: `pio test -e native -f test_weather_mood` vorher → ERRORED (`OV_HAND` nicht deklariert); danach 7 Tests, 0 Fehler
- Gegenprobe: `OV_HAND = 2048` → `test_hand_bit` FAILED; zurück → 7 PASS
- Nächster Schritt: Interaktion Task 2 Step 2 (Hand in eyes.cpp zeichnen), dann Step 3 (app.cpp: Blick folgt, High-Five, LED weiß), Build
- Offen/Fragen: –

## Interaktion Task 1 – Blick folgt und High-Five (Logik) – ERLEDIGT
- Zeit: 2026-10-25 13:48 UTC
- Gemacht: `src/logic/look.h` (`LookState`, `look_at` mit Abbildung (x−160)/160·30 und (y−100)/100·15, geklemmt, 3000 ms; `look_active`, `look_target`, `highfive_hit` für x<64 oder x>256 bei y<56). `MoodEvent::HIGHFIVE` in mood.h: Unterhaltung +5, Zuneigung +2, EXCITED 2 s.
- Dateien: src/logic/look.h, test/test_look/test_main.cpp, src/logic/mood.h, test/test_mood/test_main.cpp (neuer Test `test_highfive`, bestehende unverändert)
- Prüfung: `pio test -e native -f test_look` vor Implementierung → ERRORED (`logic/look.h` fehlt); danach 4 Tests, 0 Fehler. `pio test -e native -f test_mood` → 36 Tests, 0 Fehler
- Gegenprobe: Ecken-Grenze y<56 → y<80 → `test_highfive_corners: Expected FALSE Was TRUE`; HIGHFIVE fun +5 → +4 → `test_highfive: Expected 55 Was 54`; beides zurück → PASS
- Nächster Schritt: Interaktion Task 2 Step 1
- Offen/Fragen: –

## Interaktion Task 0 – Werkzeuge und Branch (Cloud) – ERLEDIGT
- Zeit: 2026-10-25 13:47 UTC
- Gemacht: Basis `origin/buddy-umsetzung` (00ad726). Diese Cloud-Sitzung darf nur auf **`claude/dreamy-galileo-bvdw39`** pushen; der Branch wurde per Fast-Forward auf `buddy-umsetzung` gebracht und trägt ab hier die Interaktions-Commits. Werkzeuge wie unter „Task 0 – Werkzeuge (Cloud)“ (gleicher Container, noch eingerichtet).
- Dateien: –
- Prüfung: `pio test -e native` → 78 Tests, 0 Fehler; `pio run -e cyd2usb` → SUCCESS, RAM 17,4 % (56 964 B), Flash 73,1 % (1 436 759 B); `node --test tools/*.test.mjs` → 3/3
- Gegenprobe: –
- Nächster Schritt: Interaktion Task 1
- Offen/Fragen: Lokal `claude/dreamy-galileo-bvdw39` nach `buddy-umsetzung` übernehmen (Fast-Forward möglich, solange `buddy-umsetzung` nicht weiterläuft).

## Lokal 2 – WLAN, Wetter, Touch, OTA am Gerät – ERLEDIGT
- Zeit: 2026-10-25 (lokal, Opus)
- Gemacht: WLAN-Portal eingerichtet (am Handy ging die Seite nicht auf, vom PC über dessen WLAN-Adapter ging sie: Gerät ok, Handy bleibt vermutlich auf mobilen Daten). Wetter repariert (`useHTTP10`, Open-Meteo antwortete chunked). Manuelles Update: Einstellungen → Firmware zeigt die Karte sofort. Tipps nutzen die letzte gültige Position statt (0,0). **Touch-Kalibrierung** mit 4 Eckpunkten beim ersten Start, im NVS (`touchcal`); Finger beim Einschalten = neu kalibrieren. Gemessen: Bildschirm-x aus Roh-x (umgekehrt), y aus Roh-y; Werte `3679,310 3672,3689 516,371 474,3703`. Die frühere Eck-Messung ohne gezeichnete Ziele war falsch, die Konstanten in config.h sind nur noch Startwerte.
- Prüfung am Gerät: Menü → Uhr trifft (Seriell `geste 1 bei x=249 y=56 screen=1` → screen 2), Uhr zeigt Zeit, Datum, Wetter mit Temperatur (Nutzer). **OTA Ende zu Ende gemessen:** Release v20261025-1259 → „Update bereit“ → Ja → `ota: ok, Neustart` → `Partition app1, Zustand 2` (gültig, **kein Rollback**, wie beim HA-Buddy). Heap-Minimum beim HTTPS-Abruf 63 312 B.
- Releases: v20261025-1240, -1259 (veraltet), **-1350 = aktueller Stand** (ELF 971f8741…, auch per Kabel aufgespielt).
- Lehre: Nach jedem Kabel-Flash sofort ein Release mit genau diesem Stand, sonst „aktualisiert“ das Gerät auf ein älteres Release. Kabel-Flash, wenn das Gerät auf app1 läuft: `boot_app0.bin` an 0xe000 mitschreiben, nur die App an 0x10000 (nicht das Factory-Image, das löscht NVS/WLAN).
- Nicht geprüft am Gerät: Streicheln/Stupsen, Nachtschlaf (22–7 Uhr), Spiele, Overlays (Sonnenbrille usw.), unterer Bildrand reagiert kaum auf Touch.
- Nächster Schritt: Diagnose-Ausgaben (`touch`, `geste`, `touch verworfen`) wieder entfernen oder hinter ein Build-Flag, Rest am Gerät prüfen.

## Lokal 1 – Übernahme, erster Flash, Lichtsensor – ERLEDIGT
- Zeit: 2026-10-25 (lokal, Opus)
- Gemacht: Cloud-Branch `claude/dreamy-galileo-bvdw39` als `buddy-umsetzung` übernommen und lokal komplett nachgeprüft. Open-Meteo-URLs per curl geprüft (Geocoding HTTPS ok, Wetter über **http** ok, 200). Per Kabel geflasht. Lichtsensor gemessen und als unbrauchbar erkannt → Schlafen nach Uhrzeit + Ruhe (`mood_touch`, `mood_night_check`, 4 neue Tests). `ota-publish --release` setzt den Tag jetzt mit `--target <Commit>` und verweigert nicht gepushte Commits.
- Dateien: src/logic/mood.h, test/test_mood/test_main.cpp, src/app.cpp, src/config.h, tools/ota-publish.mjs, docs/superpowers/specs/…design.md
- Prüfung: `pio test -e native` → 51 Tests, 0 Fehler; `node --test tools/ota-publish.test.mjs` → 3/3; `pio run -e cyd2usb` → SUCCESS, Flash 1 431 499 B. Am Gerät (Seriell): Panel ST7789, `invert=0` richtig (Nutzer: Farben stimmen, türkise Augen), 29 fps, heap 123 732 / min 122 104 bei offenem Portal, OTA `app0 Zustand -1`. Touch: Rohwert in der Mitte (1880, 2450), Lang drücken öffnet das Menü (Nutzer).
- Gegenprobe: Ruhezeit 10 → 20 min → 3 Tests FAIL; zurück → PASS.
- Messung LDR (GPIO 34, Rohwert, Mittel über 16): Raumlicht/dämmrig 0, einmal 13 s lang ~200, Display nach unten 0. Bekannt: Spannungsteiler für ESP8266 (1 V) ausgelegt, Display leuchtet den Sensor an (Arduino-Forum „Cheap Yellow Display LDR Sensor“). Schwelle jetzt 325 ± 75, `LDR_DARK_IS_HIGH 1`.
- Hardware: **Auto-Reset geht an diesem Board nicht** (DTR erreicht GPIO0 nicht, gemessen: `boot:0x13` auch bei DTR aktiv während EN). Kabel-Flash nur so: esptool mit `--connect-attempts 0` starten, dann BOOT ~15 s halten.
- Nebenbei: `.pio` ist per `com.dropbox.ignored` von Dropbox ausgenommen (Dropbox sperrte Build-Dateien → ERRORED-Tests).
- Nächster Schritt: WLAN-Portal am Handy einrichten, dann OTA Ende zu Ende mit erstem Release (spielt diesen Stand ohne Kabel auf).
- Offen/Fragen: Touch-Kalibrierung der Ecken nur indirekt (Menü-Kacheln treffen) zu prüfen.

## Task 14 – Doku und Abschluss – ERLEDIGT
- Zeit: 2026-10-25 10:48 UTC
- Gemacht: `docs/ota.md` (GitHub-Release, keine Geheimnisse in der .bin, Ablauf, Prüfungen, Alltag, Grenzen: Rollback ungeprüft, erster Flash per Kabel) und `README.md` (Gesten, Menü, Portal „CYD-Buddy“, Ort, Entwicklung, Verweis auf docs/ota.md). Abschlussprüfung.
- Dateien: docs/ota.md, README.md
- Prüfung: `pio test -e native` → 47 Tests, 0 Fehler (8 Gruppen: mood 13, gesture 7, eye_model 6, weather_mood 4, games 7, ota_policy 5, ascii 2, smoke 3). `node --test tools/*.test.mjs` → 3 Tests, 0 Fehler. `pio run -e cyd2usb` → SUCCESS, RAM 17,4 % (56 860 B von 327 680 B, statisch), Flash 72,8 % (1 431 027 B); `firmware.bin` 1 459 792 B < 1 966 080 B
- Gegenprobe: je Testgruppe in Task 1–6, 10, 13 gemacht (siehe dort)
- Nächster Schritt: **Lokaler Claude übernimmt** den Branch `claude/dreamy-galileo-bvdw39` (siehe Task 0: die Cloud-Sitzung durfte nicht auf `buddy-umsetzung` pushen). Am Gerät messen und prüfen (Liste unten), Messwerte in `src/config.h`, dann erstes Release.
- Offen/Fragen (Sammlung): (1) Branch-Name, s. o. (2) `OTA_IMG_CHECK_BYTES`/`CHECK_BYTES` 176 → 208 (Fehler der Vorlage, Task 6). (3) `SimonState::INPUT` → `AWAIT_INPUT` (Arduino-Makro, Task 11). (4) Open-Meteo-URLs in der Cloud nicht prüfbar (Task 9). (5) `node --test tools/` geht mit Node 22 nicht → `node --test tools/*.test.mjs` (Task 13). (6) Lichtsensor meldet nie „dunkel“, solange `LDR_DARK_THRESHOLD` ≤ 0; `LDR_DARK_IS_HIGH` fehlt in config.h (Task 7). (7) WiFiManager-Upload-Seite per Neustart gesperrt (Task 9). (8) Kein Release, kein Flash, kein PR (wie verlangt).
- Am Gerät zu prüfen (aus Spec „Prüfung“): Testbild/Farben (Panel ST7789 vs. ILI9341, `CYD_INVERT`), Touch-Kalibrierung; Augen flüssig (fps ≥ 25 im Seriell-Log); Gesten (Tippen, Streicheln, Stupsen, Lang drücken); Lichtsensor (Richtung, Schwelle, Hysterese → config.h); Portal „CYD-Buddy“ mit Ort; Wetter im Statusstreifen und als Overlays; Uhr (Zeit, Datum, Wetter, Augen von unten); Spiele Fang mich und Simon; Einstellungen (Helligkeit, Portal, Firmware, Info); OTA Ende zu Ende mit zweitem Release (Karte, Später, Ja, Fortschritt, Neustart, Zustand im Seriell-Log `ota: Partition … Zustand …`); Heap-Minimum nach Manifest-Abruf.

## Task 13 – Veröffentlichungs-Skript (tools/ota-publish.mjs) – ERLEDIGT
- Zeit: 2026-10-25 10:46 UTC
- Gemacht: Skript aus der Vorlage portiert: `.pio/build/cyd2usb/firmware.bin`, Chip 0 („falscher Chip (erwartet ESP32)“), Slot-Grenze 1 966 080, `manifest.json`/`firmware.bin`, Git-Prüfpfade `src tools platformio.ini`, `--serve`/`--ha`/`uploadHa`/`secretToken` entfernt, `--release` ruft `gh release create v<YYYYMMDD-HHMM> … --latest --repo M4dm0nky/cyd-buddy` auf. CLI nur bei direktem Aufruf (`import.meta.url === pathToFileURL(...)`). `PROJECT = 'arduino-lib-builder'` (aus `--check`).
- Dateien: tools/ota-publish.mjs, tools/ota-publish.test.mjs
- Prüfung: vor dem Skript `node --test tools/*.test.mjs` → FAIL (ERR_MODULE_NOT_FOUND); danach → 3 Tests, 0 Fehler. `node tools/ota-publish.mjs --check` → `Projektname im Image: "arduino-lib-builder"`, ELF f31cbf477819e8eb…, Größe 1 459 792 B (74,2 % des Slots). Schreibmodus mit `--allow-dirty` → `ota-out/firmware.bin` + `manifest.json` korrekt (danach gelöscht). **`--release` nicht ausgeführt.**
- Gegenprobe: `CHIP_ESP32` 0 → 9 → alle 3 Tests FAIL; zurück → 3 PASS
- Nächster Schritt: Task 14 Step 1
- Offen/Fragen: (1) `node --test tools/` (wie im Plan) geht mit Node 22 nicht: Node sucht ein Modul namens `tools` (MODULE_NOT_FOUND). Richtig ist `node --test tools/*.test.mjs` (auch in der Doku so). (2) `CHECK_BYTES` = 208 statt 176 (siehe Task 6). (3) Datum/Zeit in `esp_app_desc_t` kommen aus den vorgebauten Core-Bibliotheken („Sep 16 2026 21:15:45“), nicht vom eigenen Build; `built` im Manifest ist deshalb die Änderungszeit der .bin. (4) Zusätzlich exportiert: `imageProject(buf)`.

## Task 12 – OTA-Abruf portieren (ota_pull, ota_card) – ERLEDIGT
- Zeit: 2026-10-25 10:44 UTC
- Gemacht: `ota_pull.*` aus der Vorlage mit allen 9 Änderungen des Plans: Includes/diag entfernt (→ Serial), `kBase` GitHub-Release + `manifest.json`, neue `open_follow()` (Umleitungen selbst, ≤ 3 Sprünge, jede URL durch `ota_redirect_ok`, sonst „Umleitung abgelehnt“; TLS mit `useBuiltinCACertBundle()`), JsonDocument Standard-Allocator mit Filter, `malloc` statt PSRAM, Gesundheitsnachweis ohne HA, `project_name()` bleibt, `size > 1966080` → „zu gross fuer den Slot“, `loop()` über `net_task_hook`. `ota_card.*`: Karte „Update bereit“ (Ja/Später, Tipps < 1 s ignoriert), Fortschritt mit schmalen „konzentrierten“ Augen, Fehlerkarte. `app.cpp`: OTA-Bildschirm nur aus EYES bei wachem Display, `eyes_free()` bei DOWNLOADING, `eyes_begin()` danach, `ui_alive()` je Augenbild, Firmware-Zeile + „jetzt suchen“ in den Einstellungen, Update-Symbol im Statusstreifen.
- Dateien: src/ota/ota_pull.h, src/ota/ota_pull.cpp, src/ui/ota_card.h, src/ui/ota_card.cpp, src/app.cpp, docs/FORTSCHRITT.md (Zeitangaben korrigiert)
- Prüfung: `pio run -e cyd2usb` → SUCCESS, RAM 17,4 % (56 860 B), Flash 72,8 % (1 431 027 B); `ls -l .pio/build/cyd2usb/firmware.bin` → 1 459 792 B < 1 966 080 B. `pio test -e native` → 47 Tests, 0 Fehler
- Gegenprobe: –
- Nächster Schritt: Task 13 Step 1
- Offen/Fragen: (1) Zeitangaben der früheren Einträge waren geschätzt und falsch; jetzt auf die Commit-Zeiten korrigiert. (2) Plan nennt die Datei `src/net/net.cpp` (Hook) und `src/ui/settings.cpp` (Firmware-Zeile) als zu ändern: Der Hook war schon in Task 9 da, die Firmware-Zeile kommt über `settings_firmware_source()` aus `app.cpp` – beide Dateien blieben unverändert. (3) Speicher während des Manifest-Abrufs: TLS (~40–50 KB) läuft bei angelegtem Sprite (64 KB); am Gerät `min` im Heap-Log prüfen.
- Am Gerät zu prüfen: OTA Ende zu Ende mit zweitem Release (Karte, Später = 1 h Ruhe, Ja → Laden → Neustart, Fehlerkarte).

## Task 11 – Spiel-Bildschirme (Fang mich, Simon) – ERLEDIGT
- Zeit: 2026-10-25 10:41 UTC
- Gemacht: „Fang mich“ (kleines cyan Auge, alte Stelle schwarz übermalt, Restzeit-Balken + Treffer-Punkte oben) und „Simon“ (4 Felder rot/grün/blau/gelb, 500 ms hell / 200 ms Pause, Tipp leuchtet 150 ms). Spielfeld 320×200 unter 40-px-Kopf (`GAME_TOP`). Ende: 2 s großes Augenpaar (EXCITED bzw. BORED), dann EYES und `mood_event(GAME_WON/GAME_LOST)`. Seed aus `esp_random()`.
- Dateien: src/ui/game_common.*, src/ui/game_catch.*, src/ui/game_simon.*, src/app.cpp, src/logic/simon.h
- Prüfung: `pio run -e cyd2usb` → SUCCESS, RAM 17,2 % (56 428 B), Flash 72,2 % (1 420 259 B). `pio test -e native` → 47 Tests, 0 Fehler (8 Gruppen)
- Gegenprobe: –
- Nächster Schritt: Task 12 Step 1
- Offen/Fragen: **Abweichung:** `SimonState::INPUT` heißt jetzt `SimonState::AWAIT_INPUT`, weil Arduino `INPUT` als Makro definiert (Build-Fehler „expected identifier before numeric constant“). Der Test aus dem Plan benutzt `INPUT` nicht und läuft unverändert.
- Am Gerät zu prüfen: Spiele spielbar (Treffer-Toleranz, Tempo), Ergebnis-Augen.

## Task 10 – Menü, Uhr, Einstellungen – ERLEDIGT
- Zeit: 2026-10-25 10:38 UTC
- Gemacht: Menü 2×2 Kacheln (Spielen grün, Uhr gelb, Einstellungen violett, Schließen rot; 2. Ebene Fang-mich/Simon + Zurück), Uhr 15 s (Font7, Datum „So 25.10.“, Wetter, Augen schauen von unten herein; ohne Zeit „--:--“ + rotes WLAN), Einstellungen (Helligkeit 0→1→2→0, WLAN/Ort → Portal, Firmware-Zeile über Quelle ab Task 12, Info: Build-Datum, Heap, LDR). `app.cpp` mit `enum class Screen`; Stimmung/Licht laufen auf allen Bildschirmen weiter. Neu `logic/ascii.h` (UTF-8 → ASCII, die eingebauten Schriften haben keine Umlaute) mit Test.
- Dateien: src/ui/menu.*, src/ui/clock_view.*, src/ui/settings.*, src/ui/ui_common.*, src/logic/ascii.h, test/test_ascii/test_main.cpp, src/app.cpp
- Prüfung: `pio run -e cyd2usb` → SUCCESS, RAM 17,2 % (56 340 B), Flash 72,1 % (1 417 923 B). `pio test -e native -f test_ascii` → 2 Tests, 0 Fehler
- Gegenprobe: `ü → "u"` statt `"ue"` → `test_umlauts` und `test_truncates` FAILED; zurück → 2 PASS
- Nächster Schritt: Task 11 Step 1
- Offen/Fragen: Abweichungen: `menu_touch(x, y, now_ms)` und `settings_touch(x, y, now_ms)` bekommen die Zeit (für den 10-s-Timeout). Zusätzlich `settings_tick`, `settings_timed_out` (30 s, nicht im Plan) und `settings_firmware_source`. Langes Drücken öffnet das Menü nicht, solange der Buddy schläft (dunkles Display, sichere Variante).
- Am Gerät zu prüfen: Kachel-Treffer (Touch-Kalibrierung), Lesbarkeit der Uhr, Helligkeitsstufen.

## Task 9 – Netz (net.*) – ERLEDIGT
- Zeit: 2026-10-25 10:35 UTC
- Gemacht: WiFiManager nicht blockierend (AP „CYD-Buddy“, Feld „Ort“ id `place`, 47 Zeichen), Portal beim ersten Start bzw. nach 30 s ohne WLAN; NTP mit `configTzTime`; Geocoding per HTTPS (`NetworkClientSecure::useBuiltinCACertBundle()` – im Core-Header `NetworkClientSecure.h` nachgesehen; Bundle ist laut sdkconfig `CONFIG_MBEDTLS_CERTIFICATE_BUNDLE_DEFAULT_FULL`); Wetter alle 30 min per HTTP, Fehler → 5 min; JSON mit Filter. Abrufe im `net_task` (Kern 0, Prio 1, Stack 8192); nur der Haupt-Task schreibt `Persist`/NVS. `app.cpp`: Stunde an mood, Statusstreifen aus net, Wetter-Overlays (nur frisch < 3 h), Aus-Zeit einmalig nachgerechnet, Epoche beim Speichern.
- Dateien: src/net/net.h, src/net/net.cpp, src/app.cpp
- Prüfung: Step 1 `curl` → **nicht geprüft, weil** das Cloud-Netz `geocoding-api.open-meteo.com` sperrt (403 vom Proxy) und `api.open-meteo.com` nicht auflöst. `pio run -e cyd2usb` → SUCCESS, RAM 17,2 % (56 292 B), Flash 71,6 % (1 407 107 B von 1 966 080 B)
- Gegenprobe: –
- Nächster Schritt: Task 10 Step 1
- Offen/Fragen: (1) URLs ungeprüft – lokal mit den beiden `curl`-Befehlen aus Plan Task 9 Step 1 gegenprüfen (Wetter bleibt wie in der Spec auf `http://`). (2) Sicherheit: WiFiManager registriert die Upload-Seite `/update` immer, auch wenn sie im Menü fehlt; das Portal-AP ist offen. Deshalb Menü nur „wifi, exit“, Info-Update aus und `setPreOtaUpdateCallback` → `ESP.restart()`, damit niemand über das Portal Firmware aufspielen kann. (3) Von Hand geöffnetes Portal schließt nach 5 min wieder, wenn WLAN verbunden ist (nicht im Plan, damit das AP nicht ewig offen bleibt). (4) Der Ort wird nach dem Geocoding durch den Namen aus der Antwort ersetzt (z. B. „Berlin“).
- Am Gerät zu prüfen: Portal „CYD-Buddy“ erscheint, Ort-Feld, Verbindung, Uhrzeit, Wetter im Statusstreifen.

## Task 8 – Augen zeichnen und Hauptschleife – ERLEDIGT
- Zeit: 2026-10-25 10:31 UTC
- Gemacht: Augen-Renderer mit 8-Bit-Sprite 320×200 (Fallback direkt), Overlays (Herz, Sonnenbrille, Schweiß, Träne, zZz, Zittern, Regen-Tönung), Symbole aus Primitiven, Statusstreifen (zeichnet nur bei Änderung), `app.cpp` mit Bildtakt 33 ms, Gesten → Stimmung, Licht → Schlaf, Blinzeln/Blick/Tween, LED 15 %, Hintergrundlicht, Speichern alle 10 min, Seriell-Log alle 60 s. Testbild nach `ui/testscreen.cpp` ausgelagert (beim Start gedrückt halten).
- Dateien: src/ui/eyes.h, src/ui/eyes.cpp, src/ui/icons.h, src/ui/icons.cpp, src/ui/status_bar.h, src/ui/status_bar.cpp, src/ui/testscreen.h, src/ui/testscreen.cpp, src/app.h, src/app.cpp, src/main.cpp
- Prüfung: `pio run -e cyd2usb` → SUCCESS, RAM 10,6 % (34 736 B statisch; Sprite 64 000 B kommt zur Laufzeit dazu), Flash 27,3 % (537 303 B). `pio test -e native` → 45 Tests, 0 Fehler (7 Gruppen)
- Gegenprobe: – (Renderer nicht unit-getestet)
- Nächster Schritt: Task 9 Step 1
- Offen/Fragen: (1) Symbol-Funktionen nehmen `LovyanGFX &` statt `LGFX &` (Basisklasse; `LGFX` passt weiter, dazu gehen Sprites). Zusätzliche Symbole: `icon_target`, `icon_simon`, `icon_brightness`, `icon_back`. Zusätzlich `status_invalidate()` und `eyes_draw_pair()` (für Spiele/OTA). (2) Lid-Schnitte beziehen sich auf die *geöffnete* Höhe `h*open`, nicht auf `h` – sonst wäre SLEEPY (open 0,35, top_cut 0,5) ganz zu. (3) Sonnenbrillen-Rahmen grau statt schwarz, weil Schwarz auf schwarzem Grund unsichtbar wäre. (4) Mond-Symbol setzt schwarzen Hintergrund voraus.
- Am Gerät zu prüfen: Augen flüssig (fps im Seriell-Log, Ziel ≥ 25), Gesten (Tippen/Streicheln/Stupsen/Lang drücken), LDR-Richtung/-Schwelle, Testbild beim Start gedrückt halten.

## Task 7 – Hardware-Schicht (LED, Licht, Speicher) – ERLEDIGT
- Zeit: 2026-10-25 10:27 UTC
- Gemacht: `led.*` (ledcAttach/ledcWrite, im Core-Header `esp32-hal-ledc.h` geprüft: `bool ledcAttach(uint8_t pin, uint32_t freq, uint8_t resolution)`, `bool ledcWrite(uint8_t pin, uint32_t duty)`), `light.*` (Ringpuffer 16, alle 60 ms, Hysterese), `store.*` (Preferences, Namensraum `buddy`, Versions-Schlüssel `ver`).
- Dateien: src/hw/led.h, src/hw/led.cpp, src/hw/light.h, src/hw/light.cpp, src/hw/store.h, src/hw/store.cpp
- Prüfung: `pio run -e cyd2usb` → SUCCESS, RAM 10,4 % (33 984 B), Flash 25,2 % (494 623 B) – Module noch nicht benutzt
- Gegenprobe: – (keine Unit-Tests für Hardware vorgesehen)
- Nächster Schritt: Task 8 Step 1
- Offen/Fragen: `LDR_DARK_IS_HIGH` fehlt in config.h → in light.cpp Standard 1 mit Kommentar „am Gerät messen“. Sichere Variante: Solange `LDR_DARK_THRESHOLD` ≤ 0 (Platzhalter), meldet `light_update` nie „dunkel“, sonst würde der Buddy mit Schwelle 0 dauernd schlafen.

## Task 6 – OTA-Regeln portieren (ota_policy.h) – ERLEDIGT
- Zeit: 2026-10-25 10:26 UTC
- Gemacht: Vorlage kopiert, `OTA_CHIP_ESP32 = 0`, Kommentar auf `test/test_ota_policy`, neu `ota_redirect_ok(url)` (nur `https://`, Host `github.com` oder Endung `.githubusercontent.com`, Groß/Klein egal, Host nur aus Buchstaben/Ziffern/`-`/`.`).
- Dateien: src/logic/ota_policy.h, test/test_ota_policy/test_main.cpp
- Prüfung: `pio test -e native -f test_ota_policy` vor Implementierung → ERRORED (Header fehlt); mit unveränderter Vorlage → SIGSEGV; nach Korrektur → 5 Tests, 0 Fehler
- Gegenprobe: Chip-Konstante 0 → 9 → `test_image_ok_esp32: Expected 0 Was 3` und `test_image_rejects` FAILED; zurück → 5 PASS
- Nächster Schritt: Task 7 Step 1
- Offen/Fragen: **Abweichung von der Vorlage:** `OTA_IMG_CHECK_BYTES` war 176, `ota_image_check` liest die ELF-SHA aber aus Byte 176…207 (`32 + 144 + i`). Mit genau 176 Byte Puffer (wie im Test) liest es über das Ende hinaus → Absturz. Jetzt `32 + 176 = 208`. Dasselbe steckt in der Vorlage `ota-publish.mjs` (`CHECK_BYTES = 176`, liest bis 208) und betrifft vermutlich auch den HA-Buddy (dort harmlos, weil der Puffer größer ist). In Task 13 im Skript ebenfalls auf 208 gesetzt.

## Task 5 – Spiel-Logik (simon.h, catch_game.h) – ERLEDIGT
- Zeit: 2026-10-25 10:24 UTC
- Gemacht: Test aus dem Plan wörtlich; `src/logic/simon.h` und `src/logic/catch_game.h` nach den Interfaces im Plan (Zufall über `rng_range` aus eye_model.h).
- Dateien: src/logic/simon.h, src/logic/catch_game.h, test/test_games/test_main.cpp
- Prüfung: `pio test -e native -f test_games` vor Implementierung → ERRORED (Header fehlt); danach → 7 Tests, 0 Fehler
- Gegenprobe: Gewinnprüfung in `simon_press` auf `len == 5` → `test_simon_win: Expected 0 Was 2 [FAILED]`; zurück → 7 PASS
- Nächster Schritt: Task 6 Step 1
- Offen/Fragen: –

## Task 4 – Wetter-Laune und Overlays (weather_mood.h) – ERLEDIGT
- Zeit: 2026-10-25 10:24 UTC
- Gemacht: Test aus dem Plan wörtlich; `src/logic/weather_mood.h` mit WMO-Zuordnung, Flags hot/cold, `weather_fresh` (< 3 h), `overlays_for`.
- Dateien: src/logic/weather_mood.h, test/test_weather_mood/test_main.cpp
- Prüfung: `pio test -e native -f test_weather_mood` vor Implementierung → ERRORED (Header fehlt); danach → 4 Tests, 0 Fehler
- Gegenprobe: `> 28` → `>= 28` → `test_flags: Expected FALSE Was TRUE [FAILED]`; zurück → 4 PASS
- Nächster Schritt: Task 5 Step 1
- Offen/Fragen: –

## Task 3 – Augenmodell (eye_model.h) – ERLEDIGT
- Zeit: 2026-10-25 10:23 UTC
- Gemacht: Test aus dem Plan wörtlich; `src/logic/eye_model.h` mit Tabelle (switch), xorshift32, `eye_tween`/`rgb_tween` (k = 1 − e^(−dt/150)), Blinker und Gazer nach Plan.
- Dateien: src/logic/eye_model.h, test/test_eye_model/test_main.cpp
- Prüfung: `pio test -e native -f test_eye_model` vor Implementierung → ERRORED (Header fehlt); danach → 6 Tests, 0 Fehler
- Gegenprobe: Blinzelabstand 2000–6000 → 7000–9000 → `test_blinker_closes_within_window` und `test_blinker_reopens` FAILED; zurück → 6 PASS
- Nächster Schritt: Task 4 Step 1
- Offen/Fragen: –

## Task 2 – Gesten (gesture.h) – ERLEDIGT
- Zeit: 2026-10-25 10:23 UTC
- Gemacht: Test aus dem Plan wörtlich, `src/logic/gesture.h` nach den Regeln im Plan (Tipp-Ringpuffer der letzten 5, Streichel-Fenster 1,5 s, Bewegungsschwelle 15 px).
- Dateien: src/logic/gesture.h, test/test_gesture/test_main.cpp
- Prüfung: `pio test -e native -f test_gesture` vor Implementierung → ERRORED (Header fehlt); danach → 7 Tests, 0 Fehler
- Gegenprobe: `GESTURE_STROKE_PX` 60 → 200 → `test_stroke: Expected 2 Was 0 [FAILED]`; zurück → 7 PASS
- Nächster Schritt: Task 3 Step 1
- Offen/Fragen: –

## Task 1 – Stimmung (mood.h) – ERLEDIGT
- Zeit: 2026-10-25 10:22 UTC
- Gemacht: Test aus dem Plan wörtlich übernommen, `src/logic/mood.h` exakt nach Plan.
- Dateien: src/logic/mood.h, test/test_mood/test_main.cpp
- Prüfung: `pio test -e native -f test_mood` vor Implementierung → ERRORED (`logic/mood.h: No such file`); danach → 13 Tests, 0 Fehler
- Gegenprobe: `+= 8` → `+= 7` in STROKE → `test_stroke_cooldown: Expected 58 Was 57 [FAILED]`; zurückgeändert → 13 PASS
- Nächster Schritt: Task 2 Step 1
- Offen/Fragen: –

## Task 0 – Werkzeuge (Cloud) – ERLEDIGT mit Umweg
- Zeit: 2026-10-25 10:22 UTC
- Gemacht: PlatformIO 6.2.0 per pip. Die PlatformIO-Registry (`api.registry.platformio.org`, `collector.platformio.org`) ist im Cloud-Netz gesperrt (403), GitHub geht. Umweg nur außerhalb des Repos: Proxy-CA an `~/.platformio/penv/.../certifi/cacert.pem` angehängt (pioarduino überschreibt `REQUESTS_CA_BUNDLE`), `tool-scons` 4.11.1 aus PyPI nach `~/.platformio/packages/tool-scons` gelegt, `platform-native` aus GitHub nach `~/.platformio/platforms/native`, Bibliotheken per `git clone` mit `.piopm` nach `.pio/libdeps/` (LovyanGFX 1.2.34, WiFiManager 2.0.17, ArduinoJson 7.4.3, Unity 2.6.1; bei Unity Kommentarzeilen aus `library.json` entfernt). `platformio.ini` unverändert.
- Dateien: keine im Repo
- Prüfung: `pio test -e native -f test_smoke` → 3 Tests, 0 Fehler. `pio run -e cyd2usb` → SUCCESS, RAM 10,4 % (33 984 B), Flash 25,2 % (494 623 B von 1 966 080 B)
- Gegenprobe: –
- Nächster Schritt: Task 1 Step 1
- Offen/Fragen: Lokal mit normalem Internet ist kein Umweg nötig. Branch: Die Cloud-Sitzung darf nur auf `claude/dreamy-galileo-bvdw39` pushen, nicht auf `buddy-umsetzung` (Vorgabe der Sitzung). Der lokale Claude übernimmt also `claude/dreamy-galileo-bvdw39` (ggf. lokal in `buddy-umsetzung` umbenennen).

## Task 0 – Gerüst und Testbild – ERLEDIGT (lokal)
- Zeit: 2026-10-25
- Gemacht: PlatformIO-Gerüst (cyd2usb + native), Pins/Display-Klasse, Testbild, Smoke-Test, OTA-Vorlagen aus dem HA-Buddy unter reference/.
- Dateien: platformio.ini, src/config.h, src/hw/display.h, src/main.cpp, src/logic/clamp.h, test/test_smoke/, reference/ha_buddy_ota/
- Prüfung: siehe Commit „chore: Gerüst“ (Build und Smoke-Test lokal)
- Gegenprobe: Smoke-Test mit falschem Erwartungswert schlägt fehl
- Nächster Schritt: Task 1 Step 1
- Offen/Fragen: Panel-Variante, Touch-Kalibrierung, LDR-Richtung/-Schwelle misst der lokale Claude am Gerät.
