M4dm0nky/cyd-buddy/docs/superpowers/plans/2026-10-25-gesicht.md

# Gesicht Implementation Plan

> **For agentic workers:** REQUIRED SUB-SKILL: superpowers:test-driven-development für Task 1–2. Ein Commit pro Task (Trailer `Co-Authored-By: Claude <Modell> <noreply@anthropic.com>`), **nicht pushen** (macht der Orchestrator).

**Goal:** Gesicht mit Brauen, Pupillen, Nase, Mund und 22 Ausdrücken laut Spec `docs/superpowers/specs/2026-10-25-gesicht-design.md`.
**Architecture:** Reine Logik in `src/logic/face_model.h` und `src/logic/mood.h` (Unity-Tests am PC), Zeichnen in `src/ui/eyes.cpp`, Verdrahtung in `src/app.cpp`.
**Tech Stack:** PlatformIO (pioarduino), LovyanGFX 1.2.34, Unity.

## Global Constraints
- **Werkzeuge nur über das PowerShell-Tool**, nie Git Bash (pioarduino bricht dort ab). pio: `& "C:\Users\madma\AppData\Roaming\Python\Python314\Scripts\pio.exe"`. Für `pio test -e native` vorher `$env:PATH = "C:\Users\madma\AppData\Local\Microsoft\WinGet\Packages\BrechtSanders.WinLibs.POSIX.UCRT_Microsoft.Winget.Source_8wekyb3d8bbwe\mingw64\bin;" + $env:PATH`.
- **Ausgaben von pio nie mit `Select-Object -First` kürzen** (bricht den Build ab). Stattdessen `$o = & $pio …; $o | Select-String …`.
- Dateien nicht per PowerShell `Set-Content -Encoding utf8` schreiben (BOM); Edit/Write-Werkzeuge nutzen.
- `src/logic/` header-only, nur Standardheader, Zeit als Parameter.
- Soll-Werte der Ausdrücke = Liste `E` in `docs/superpowers/mockups/2026-10-25-gesicht-ausdruecke.html`; Zeichenvorschrift = Funktion `face()` dort.
- Bestehende 51 Tests müssen grün bleiben; bestehende Tests nur ändern, wo die Spec ein Verhalten ändert (TAP-Doppeltipp, GAME_WON-Folge, POKE bei SAD) und das im Bericht nennen.

### Task 1: Gesichtsmodell + neue Emotionen
**Files:** Create `src/logic/face_model.h`, `test/test_face_model/test_main.cpp`; Modify `src/logic/mood.h` (Enum), `src/logic/eye_model.h` (`eye_expression` aus `face_expression` ableiten).
- [ ] Test schreiben: (a) für jede Emotion `< COUNT` liefert `face_expression` w>0, h>0, open∈[0,1], pupil_r≥0; (b) Stichproben aus dem Mockup: HAPPY `lid_bottom_cut 0.45, mouth_curve 1, mouth_open 0.5, mouth_w 70, brow_y -16`; ANNOYED Farbe (255,50,40), `brow_tilt -1.2`, `mouth ZIG`; SURPRISED `mouth O`; CHEEKY `mouth TONGUE, wink true`; KISS `mouth KISS`; (c) `face_tween` mit dt 0 unverändert, nach 75×20 ms innerhalb 0,15 vom Ziel; (d) `mouth`/`wink` wechseln nicht nach einem 20-ms-Schritt, aber nach 75 Schritten; (e) `eye_expression(e).shape.w == face_expression(e).s.eye.w` für alle e.
- [ ] FAIL sehen, implementieren, PASS, Gegenprobe (einen Tabellenwert ändern → FAIL, zurück), alle Tests grün, Commit `feat: Gesichtsmodell mit 22 Ausdrücken`.

### Task 2: Auslöser und Eigenarten
**Files:** Modify `src/logic/mood.h`, `test/test_mood/test_main.cpp`, `src/logic/weather_mood.h` (+ `test/test_weather_mood`).
- [ ] Tests je Zeile der Auslöser-Tabelle der Spec (GIGGLE, KISS, CONFUSED, SCARED, PROUD-Folge nach EXCITED, SKEPTICAL), Vorrang GIGGLE > KISS > LOVE, Eigenarten mit festem Seed: YAWN erscheint bei SLEEPY innerhalb 5 min und dauert 3 s, WHISTLE bei BORED innerhalb 3 min, MISCHIEVOUS oder CHEEKY bei HAPPY innerhalb 6 min, keine Eigenart beim Schlafen und während eines anderen kurzzeitigen Gefühls; Overlays OV_QUESTION (CONFUSED), OV_NOTE (WHISTLE), OV_HEART (KISS), Sonnenbrille bei PROUD.
- [ ] FAIL, implementieren (`mood_base_emotion`, `mood_seed`, `mood_quirks`, Folge-Gefühl), PASS, Gegenprobe, alle grün, Commit `feat: Auslöser und Eigenarten für neue Ausdrücke`.

### Task 3: Gesicht zeichnen und verdrahten
**Files:** Modify `src/ui/eyes.h`, `src/ui/eyes.cpp`, `src/app.cpp`.
- [ ] `eyes_draw(LGFX&, const FaceShape&, Rgb, uint32_t overlays, uint32_t now)` nach Mockup-`face()`; neue Overlays ? und ♪ zeichnen; `eyes_draw_pair` unverändert.
- [ ] `app.cpp`: `FaceShape s_face` statt `EyeShape s_shape`, `face_tween`, Blinzeln auf `eye.open`, Gazer → Pupillen (±14/±10) + Gesicht (±8/±4), STARTLED statt SURPRISED-Form bei Gewitter, `mood_quirks` jedes Bild, `mood_seed` beim Start (`esp_random()`).
- [ ] `pio run -e cyd2usb` SUCCESS, Größe notieren; `pio test -e native` alle grün. Commit `feat: Gesicht mit Brauen, Pupillen, Nase und Mund zeichnen`.
