M4dm0nky/cyd-buddy/docs/superpowers/plans/2026-10-25-cyd-buddy.md

# CYD-Buddy Implementation Plan

> **For agentic workers:** REQUIRED SUB-SKILL: Use superpowers:executing-plans (Online-Agent) or superpowers:subagent-driven-development (lokal) to implement this plan task-by-task. Steps use checkbox (`- [ ]`) syntax for tracking. **Nach jedem Task: Eintrag in `docs/FORTSCHRITT.md`, commit, push** (siehe „Fortschritts-Protokoll“).

**Goal:** Ein Schreibtisch-Wesen mit großen, ausdrucksstarken Augen auf dem ESP32-2432S028 (CYD2USB), mit Stimmungen, Touch-Gesten, Schlaf per Lichtsensor, Uhrzeit/Wetter-Laune, zwei Mini-Spielen und Online-Update über GitHub-Releases.

**Architecture:** Reine, am PC getestete Logik in `src/logic/*.h` (header-only, keine Arduino-Includes, Zeit als Parameter). Darum herum dünne Hardware-/UI-/Netz-Schichten (`src/hw`, `src/ui`, `src/net`, `src/ota`), die nur gebaut, nicht unit-getestet werden. `src/main.cpp` verbindet alles in einer Bildschleife; Netzabrufe laufen in einem eigenen FreeRTOS-Task.

**Tech Stack:** PlatformIO (pioarduino, Arduino-Core 3.x), LovyanGFX, WiFiManager (tzapu), ArduinoJson 7, Unity (native Tests), Node ≥ 20 für `tools/ota-publish.mjs`.

**Spec:** `docs/superpowers/specs/2026-10-25-cyd-buddy-design.md` – bei Widerspruch gilt die Spec.

## Global Constraints

- Display 320×240 quer (`setRotation(1)`); Augenbereich = 8-Bit-Sprite (RGB332) 320×200 = 64 000 B, darunter 40-px-Statusstreifen direkt gezeichnet.
- Kein PSRAM: keine Allokation > 64 KB, kein `heap_caps_malloc(..., MALLOC_CAP_SPIRAM)`.
- Partition `min_spiffs`, App-Slot 1 966 080 B; das Image muss kleiner sein.
- `src/logic/` = header-only, nur C/C++-Standardheader; jede Funktion bekommt `now_ms`/`dt_ms` als Parameter.
- Pins nur aus `src/config.h` verwenden (nicht neu definieren).
- UI-Texte Deutsch; Menü und Status mit **Symbolen** (gezeichnet aus Primitiven), keine Textkürzel; farbenfroh auf schwarzem Grund.
- OTA-Basis-URL: `https://github.com/M4dm0nky/cyd-buddy/releases/latest/download`, Dateien `manifest.json`, `firmware.bin`; erlaubte Hosts `github.com` und Endung `.githubusercontent.com`, nur `https://`.
- Kein `setInsecure()`, keine Zugangsdaten im Code.
- Tests: `pio test -e native -f <testordner>`; Gerät: `pio run -e cyd2usb`.
- Kein Release veröffentlichen, nicht flashen (macht der lokale Claude).

## Fortschritts-Protokoll (Pflicht)

Nach **jedem** Task (und bei Abbruch mitten im Task zusätzlich nach jedem Step, der Dateien geändert hat) in `docs/FORTSCHRITT.md` **oben** anhängen:

```markdown
## Task <N> – <Name> – <ERLEDIGT | TEILWEISE | BLOCKIERT>
- Zeit: <YYYY-MM-DD HH:MM UTC>
- Gemacht: <1–3 Sätze>
- Dateien: <Liste>
- Prüfung: <exakter Befehl> → <Ergebnis, z. B. "7 Tests, 0 Fehler" / "Build ok, Flash 1 234 567 B (62,8 %)" / "nicht gebaut, weil …">
- Gegenprobe: <welcher absichtliche Fehler, hat der Test ihn gefunden?>
- Nächster Schritt: <Task N+1 Step 1 bzw. wo genau weitermachen>
- Offen/Fragen: <oder "–">
```

Dann `git add <geänderte Dateien> docs/FORTSCHRITT.md && git commit -m "<typ>: Task <N> <kurz>" && git push`. Erst danach der nächste Task.

## File Structure

| Datei | Aufgabe |
|---|---|
| `src/config.h` | Pins, Kalibrierung, Schwellen (vorhanden, Task 0) |
| `src/hw/display.h` | LovyanGFX-Klasse `LGFX` (vorhanden, Task 0) |
| `src/logic/mood.h` | Bedürfnisse, Ereignisse, Gefühl |
| `src/logic/gesture.h` | Touch-Abtastungen → Gesten |
| `src/logic/eye_model.h` | Augenform je Gefühl, Übergänge, Blinzeln, Blick, Zufall |
| `src/logic/weather_mood.h` | WMO-Code/Temperatur → Himmel + Flags; Overlays je Lage |
| `src/logic/simon.h`, `src/logic/catch_game.h` | Spiel-Logik |
| `src/logic/ota_policy.h` | Image-Prüfung, Vergleich, Umleitung, Schlummern (Portierung) |
| `src/hw/led.*`, `src/hw/light.*`, `src/hw/store.*` | RGB-LED, Lichtsensor, NVS |
| `src/ui/eyes.*` | Augen + Overlays zeichnen |
| `src/ui/status_bar.*` | Statusstreifen |
| `src/ui/icons.*` | Symbole aus Primitiven |
| `src/ui/menu.*`, `src/ui/clock_view.*`, `src/ui/settings.*` | Menü, Uhr, Einstellungen |
| `src/ui/game_catch.*`, `src/ui/game_simon.*` | Spiel-Bildschirme |
| `src/ui/ota_card.*` | Update-Karte / Fortschritt |
| `src/net/net.*` | WLAN-Portal, NTP, Geocoding, Wetter, Netz-Task |
| `src/ota/ota_pull.*` | OTA-Abruf (Portierung) |
| `src/app.*` | Zustandsmaschine der Bildschirme, verbindet alles |
| `src/main.cpp` | `setup()`/`loop()` ruft nur `app_setup()`/`app_loop()` |
| `tools/ota-publish.mjs`, `tools/ota-publish.test.mjs` | Veröffentlichen + Test |
| `docs/ota.md` | OTA-Doku |
| `test/test_<name>/test_main.cpp` | Unity-Tests je Logik-Header |

---

### Task 0: Gerüst und Testbild (lokal erledigt)

Bereits im Repo: `platformio.ini`, `src/config.h`, `src/hw/display.h`, `src/main.cpp` (Testbild), `src/logic/clamp.h`, `test/test_smoke/`, `reference/ha_buddy_ota/`. Hardware-Messungen (Panel-Variante, Touch-Kalibrierung, LDR-Richtung/-Schwelle) macht der lokale Claude am Gerät und trägt sie in `src/config.h` ein. **Nicht ändern**, außer ein Task verlangt es.

`src/logic/clamp.h` liefert: `inline float clampf(float v, float lo, float hi)`.

---

### Task 1: Stimmung (`src/logic/mood.h`)

**Files:**
- Create: `src/logic/mood.h`
- Test: `test/test_mood/test_main.cpp`

**Interfaces:**
- Consumes: `clampf` aus `src/logic/clamp.h`
- Produces:
```cpp
enum class Emotion : uint8_t { CONTENT, HAPPY, BORED, SAD, SLEEPY, SLEEPING, SURPRISED, LOVE, ANNOYED, EXCITED, GREETING, COUNT };
enum class MoodEvent : uint8_t { TAP, STROKE, POKE, GAME_WON, GAME_LOST };
struct Needs { float affection, fun, energy; };
struct MoodState { Needs n; Emotion transient; uint32_t transient_until; uint32_t last_stroke_ms; bool stroked_once; bool napping; bool dark; uint32_t dark_since; };
void mood_init(MoodState &s, Needs start);
void mood_set_dark(MoodState &s, bool dark, int hour, uint32_t now_ms);   // hour -1 = unbekannt
bool mood_is_sleeping(const MoodState &s, uint32_t now_ms);
void mood_tick(MoodState &s, uint32_t dt_ms, uint32_t now_ms);
void mood_event(MoodState &s, MoodEvent e, uint32_t now_ms);
Emotion mood_emotion(const MoodState &s, int hour, uint32_t now_ms);
void mood_apply_elapsed(MoodState &s, uint32_t seconds);                  // Aus-Zeit zählt wie Schlaf
```

- [ ] **Step 1: Write the failing test** – `test/test_mood/test_main.cpp`:

```cpp
#include <unity.h>
#include "logic/mood.h"

static MoodState s;
static void fresh(float a, float f, float e) { mood_init(s, Needs{a, f, e}); }
void setUp() {}
void tearDown() {}

void test_decay_awake_one_hour() {
  fresh(50, 50, 50);
  mood_tick(s, 3600000UL, 3600000UL);
  TEST_ASSERT_FLOAT_WITHIN(0.05f, 38.0f, s.n.affection);
  TEST_ASSERT_FLOAT_WITHIN(0.05f, 30.2f, s.n.fun);
  TEST_ASSERT_FLOAT_WITHIN(0.05f, 39.8f, s.n.energy);
}
void test_sleep_regenerates_and_clamps() {
  fresh(50, 50, 50);
  mood_set_dark(s, true, 23, 0);
  TEST_ASSERT_FALSE(mood_is_sleeping(s, 5000));
  TEST_ASSERT_TRUE(mood_is_sleeping(s, 10001));
  mood_tick(s, 3600000UL, 3610000UL);
  TEST_ASSERT_FLOAT_WITHIN(0.01f, 100.0f, s.n.energy);
  TEST_ASSERT_FLOAT_WITHIN(0.01f, 50.0f, s.n.affection);   // im Schlaf kein Abbau
  TEST_ASSERT_FLOAT_WITHIN(0.01f, 50.0f, s.n.fun);
}
void test_stroke_cooldown() {
  fresh(50, 50, 50);
  mood_event(s, MoodEvent::STROKE, 10000);
  mood_event(s, MoodEvent::STROKE, 11000);   // < 2 s: zählt nicht
  TEST_ASSERT_FLOAT_WITHIN(0.01f, 58.0f, s.n.affection);
  mood_event(s, MoodEvent::STROKE, 12500);
  TEST_ASSERT_FLOAT_WITHIN(0.01f, 66.0f, s.n.affection);
  TEST_ASSERT_EQUAL((int)Emotion::LOVE, (int)mood_emotion(s, 12, 13000));
}
void test_affection_clamped_at_100() {
  fresh(99, 50, 50);
  mood_event(s, MoodEvent::STROKE, 5000);
  TEST_ASSERT_FLOAT_WITHIN(0.01f, 100.0f, s.n.affection);
}
void test_poke_annoyed_20s() {
  fresh(50, 50, 50);
  mood_event(s, MoodEvent::POKE, 1000);
  TEST_ASSERT_FLOAT_WITHIN(0.01f, 47.0f, s.n.affection);
  TEST_ASSERT_EQUAL((int)Emotion::ANNOYED, (int)mood_emotion(s, 12, 20999));
  TEST_ASSERT_EQUAL((int)Emotion::CONTENT, (int)mood_emotion(s, 12, 21001));
}
void test_transient_beats_sad() {
  fresh(10, 50, 50);
  mood_event(s, MoodEvent::TAP, 1000);
  TEST_ASSERT_EQUAL((int)Emotion::SURPRISED, (int)mood_emotion(s, 12, 2000));
  TEST_ASSERT_EQUAL((int)Emotion::SAD, (int)mood_emotion(s, 12, 2600));
}
void test_priorities() {
  fresh(50, 50, 50);
  TEST_ASSERT_EQUAL((int)Emotion::SLEEPY, (int)mood_emotion(s, 23, 0));
  TEST_ASSERT_EQUAL((int)Emotion::CONTENT, (int)mood_emotion(s, -1, 0));
  fresh(10, 10, 50);
  TEST_ASSERT_EQUAL((int)Emotion::SAD, (int)mood_emotion(s, 12, 0));
  fresh(50, 10, 50);
  TEST_ASSERT_EQUAL((int)Emotion::BORED, (int)mood_emotion(s, 12, 0));
  fresh(80, 70, 50);
  TEST_ASSERT_EQUAL((int)Emotion::HAPPY, (int)mood_emotion(s, 12, 0));
  fresh(50, 50, 20);
  TEST_ASSERT_EQUAL((int)Emotion::SLEEPY, (int)mood_emotion(s, 12, 0));
}
void test_nap_and_wake_by_touch() {
  fresh(50, 50, 5);
  mood_tick(s, 1000, 1000);
  TEST_ASSERT_TRUE(mood_is_sleeping(s, 1000));
  TEST_ASSERT_EQUAL((int)Emotion::SLEEPING, (int)mood_emotion(s, 12, 1000));
  mood_event(s, MoodEvent::TAP, 2000);
  TEST_ASSERT_FALSE(mood_is_sleeping(s, 2000));
}
void test_nap_ends_above_60() {
  fresh(50, 50, 5);
  mood_tick(s, 1000, 1000);
  mood_tick(s, 56UL * 60000UL, 57UL * 60000UL);   // +56 Energie -> ~61
  TEST_ASSERT_FALSE(mood_is_sleeping(s, 57UL * 60000UL));
}
void test_greeting_when_light_returns_daytime() {
  fresh(50, 50, 50);
  mood_set_dark(s, true, 9, 0);
  mood_set_dark(s, false, 9, 20000);
  TEST_ASSERT_EQUAL((int)Emotion::GREETING, (int)mood_emotion(s, 9, 21000));
  TEST_ASSERT_EQUAL((int)Emotion::CONTENT, (int)mood_emotion(s, 9, 23001));
}
void test_no_greeting_at_night() {
  fresh(50, 50, 50);
  mood_set_dark(s, true, 2, 0);
  mood_set_dark(s, false, 2, 20000);
  TEST_ASSERT_EQUAL((int)Emotion::SLEEPY, (int)mood_emotion(s, 2, 21000));
}
void test_game_won() {
  fresh(50, 50, 50);
  mood_event(s, MoodEvent::GAME_WON, 0);
  TEST_ASSERT_FLOAT_WITHIN(0.01f, 75.0f, s.n.fun);
  TEST_ASSERT_FLOAT_WITHIN(0.01f, 55.0f, s.n.affection);
  TEST_ASSERT_EQUAL((int)Emotion::EXCITED, (int)mood_emotion(s, 12, 5999));
}
void test_elapsed_counts_as_sleep() {
  fresh(50, 40, 20);
  mood_apply_elapsed(s, 30UL * 60UL);   // ausgeschaltet = geschlafen: nur Energie steigt
  TEST_ASSERT_FLOAT_WITHIN(0.05f, 50.0f, s.n.affection);
  TEST_ASSERT_FLOAT_WITHIN(0.05f, 40.0f, s.n.fun);
  TEST_ASSERT_FLOAT_WITHIN(0.05f, 50.0f, s.n.energy);
}

int main(int, char **) {
  UNITY_BEGIN();
  RUN_TEST(test_decay_awake_one_hour);
  RUN_TEST(test_sleep_regenerates_and_clamps);
  RUN_TEST(test_stroke_cooldown);
  RUN_TEST(test_affection_clamped_at_100);
  RUN_TEST(test_poke_annoyed_20s);
  RUN_TEST(test_transient_beats_sad);
  RUN_TEST(test_priorities);
  RUN_TEST(test_nap_and_wake_by_touch);
  RUN_TEST(test_nap_ends_above_60);
  RUN_TEST(test_greeting_when_light_returns_daytime);
  RUN_TEST(test_no_greeting_at_night);
  RUN_TEST(test_game_won);
  RUN_TEST(test_elapsed_counts_as_sleep);
  return UNITY_END();
}
```

- [ ] **Step 2: Run test to verify it fails**

Run: `pio test -e native -f test_mood`
Expected: FAIL (Kompilierfehler: `logic/mood.h` fehlt)

- [ ] **Step 3: Write implementation** – `src/logic/mood.h`, Regeln exakt nach Spec §1:

```cpp
#pragma once
#include <stdint.h>
#include "clamp.h"

// Bedürfnisse und Gefühl des Buddys. Reine Logik, Zeit kommt als Parameter (Host-Test test/test_mood).
enum class Emotion : uint8_t { CONTENT, HAPPY, BORED, SAD, SLEEPY, SLEEPING, SURPRISED, LOVE, ANNOYED, EXCITED, GREETING, COUNT };
enum class MoodEvent : uint8_t { TAP, STROKE, POKE, GAME_WON, GAME_LOST };
struct Needs { float affection, fun, energy; };
struct MoodState {
  Needs n;
  Emotion transient;          // CONTENT = keins
  uint32_t transient_until;
  uint32_t last_stroke_ms;
  bool stroked_once;
  bool napping;               // Nickerchen wegen Energie < 10
  bool dark;
  uint32_t dark_since;
};

constexpr float MOOD_AFFECTION_PER_MIN = -0.2f;
constexpr float MOOD_FUN_PER_MIN = -0.33f;
constexpr float MOOD_ENERGY_AWAKE_PER_MIN = -0.17f;
constexpr float MOOD_ENERGY_SLEEP_PER_MIN = 1.0f;
constexpr uint32_t MOOD_DARK_SLEEP_MS = 10000;
constexpr uint32_t MOOD_STROKE_COOLDOWN_MS = 2000;

inline void mood_clamp(Needs &n) {
  n.affection = clampf(n.affection, 0, 100);
  n.fun = clampf(n.fun, 0, 100);
  n.energy = clampf(n.energy, 0, 100);
}
inline void mood_init(MoodState &s, Needs start) {
  s = MoodState{};
  s.n = start;
  s.transient = Emotion::CONTENT;
  mood_clamp(s.n);
}
inline bool mood_daytime(int hour) { return hour < 0 || (hour >= 7 && hour < 22); }
inline bool mood_is_sleeping(const MoodState &s, uint32_t now_ms) {
  return s.napping || (s.dark && now_ms - s.dark_since > MOOD_DARK_SLEEP_MS);
}
inline void mood_set_transient(MoodState &s, Emotion e, uint32_t now_ms, uint32_t dur_ms) {
  s.transient = e;
  s.transient_until = now_ms + dur_ms;
}
inline void mood_set_dark(MoodState &s, bool dark, int hour, uint32_t now_ms) {
  if (dark == s.dark) return;
  const bool was_sleeping = mood_is_sleeping(s, now_ms);
  s.dark = dark;
  if (dark) s.dark_since = now_ms;
  else if (was_sleeping && mood_daytime(hour)) mood_set_transient(s, Emotion::GREETING, now_ms, 3000);
}
inline void mood_tick(MoodState &s, uint32_t dt_ms, uint32_t now_ms) {
  const float min = dt_ms / 60000.0f;
  if (mood_is_sleeping(s, now_ms)) {
    s.n.energy += MOOD_ENERGY_SLEEP_PER_MIN * min;   // im Schlaf nur Erholung, kein Abbau
  } else {
    s.n.affection += MOOD_AFFECTION_PER_MIN * min;
    s.n.fun += MOOD_FUN_PER_MIN * min;
    s.n.energy += MOOD_ENERGY_AWAKE_PER_MIN * min;
  }
  mood_clamp(s.n);
  if (s.n.energy < 10) s.napping = true;
  else if (s.napping && s.n.energy > 60) s.napping = false;
}
inline void mood_event(MoodState &s, MoodEvent e, uint32_t now_ms) {
  s.napping = false;   // jede Berührung weckt aus dem Nickerchen
  switch (e) {
    case MoodEvent::TAP: s.n.fun += 1; mood_set_transient(s, Emotion::SURPRISED, now_ms, 1500); break;
    case MoodEvent::STROKE:
      if (s.stroked_once && now_ms - s.last_stroke_ms < MOOD_STROKE_COOLDOWN_MS) break;
      s.stroked_once = true;
      s.last_stroke_ms = now_ms;
      s.n.affection += 8;
      mood_set_transient(s, Emotion::LOVE, now_ms, 4000);
      break;
    case MoodEvent::POKE: s.n.affection -= 3; mood_set_transient(s, Emotion::ANNOYED, now_ms, 20000); break;
    case MoodEvent::GAME_WON: s.n.fun += 25; s.n.affection += 5; mood_set_transient(s, Emotion::EXCITED, now_ms, 6000); break;
    case MoodEvent::GAME_LOST: s.n.fun += 10; break;
  }
  mood_clamp(s.n);
}
inline Emotion mood_emotion(const MoodState &s, int hour, uint32_t now_ms) {
  if (mood_is_sleeping(s, now_ms)) return Emotion::SLEEPING;
  if (s.transient != Emotion::CONTENT && (int32_t)(s.transient_until - now_ms) > 0) return s.transient;
  if (s.n.energy < 30 || (hour >= 0 && (hour >= 22 || hour < 6))) return Emotion::SLEEPY;
  if (s.n.affection < 20) return Emotion::SAD;
  if (s.n.fun < 25) return Emotion::BORED;
  if (s.n.affection > 70 && s.n.fun > 60) return Emotion::HAPPY;
  return Emotion::CONTENT;
}
// Zeit, in der das Gerät aus war, zählt wie Schlaf: nur Energie steigt.
inline void mood_apply_elapsed(MoodState &s, uint32_t seconds) {
  s.n.energy += MOOD_ENERGY_SLEEP_PER_MIN * (seconds / 60.0f);
  mood_clamp(s.n);
}
```
Hinweis: `SLEEPY` gilt 22–6 Uhr (Spec), das Begrüßen nur 7–22 Uhr. Zwischen 6 und 7 Uhr also weder schläfrig noch Begrüßung – gewollt (verschlafener Morgen kommt über Energie).

- [ ] **Step 4: Run test** – `pio test -e native -f test_mood` → Expected: 13 Tests PASS
- [ ] **Step 5: Gegenprobe** – in `mood_event` `+= 8` kurz auf `+= 7` ändern, Test muss FAIL zeigen (`test_stroke_cooldown`), zurückändern, wieder PASS.
- [ ] **Step 6: FORTSCHRITT + Commit + Push** – `git add src/logic/mood.h test/test_mood docs/FORTSCHRITT.md && git commit -m "feat: Task 1 Stimmung (mood.h) mit Tests" && git push`

---

### Task 2: Gesten (`src/logic/gesture.h`)

**Files:**
- Create: `src/logic/gesture.h`
- Test: `test/test_gesture/test_main.cpp`

**Interfaces:**
- Produces:
```cpp
enum class Gesture : uint8_t { NONE, TAP, STROKE, POKE, LONG_PRESS };
struct GestureState { bool down; int16_t x0, y0, lx, ly; uint32_t t_down; float max_dist; float path; uint32_t win_start; bool long_sent; bool moved; uint32_t taps[5]; uint8_t ntaps; };
void gesture_init(GestureState &g);
Gesture gesture_feed(GestureState &g, bool pressed, int16_t x, int16_t y, uint32_t now_ms);   // ca. alle 20 ms aufrufen
```
Regeln: TAP beim Loslassen, wenn Druck < 300 ms und Abstand zum Startpunkt nie ≥ 15 px. Der 5. Tipp innerhalb von 3 s liefert **POKE statt TAP**, danach Zähler leer. LONG_PRESS einmal während des Haltens, sobald > 1200 ms und nie ≥ 15 px bewegt; danach liefert das Loslassen NONE. STROKE während des Haltens, wenn die Wegsumme seit `win_start` ≥ 60 px erreicht und `now - win_start ≤ 1500`; dann `path = 0`, `win_start = now`. Läuft das Fenster ab, ohne 60 px zu erreichen: `path = 0`, `win_start = now`. Nach Bewegung ≥ 15 px liefert das Loslassen NONE. Beim Loslassen (`pressed == false`) werden x/y ignoriert.

- [ ] **Step 1: Write the failing test** – `test/test_gesture/test_main.cpp`:

```cpp
#include <unity.h>
#include "logic/gesture.h"

static GestureState g;
void setUp() { gesture_init(g); }
void tearDown() {}

// hält an (x,y) von t0 bis t1 in 20-ms-Schritten, gibt das erste Ereignis != NONE zurück
static Gesture hold(int16_t x, int16_t y, uint32_t t0, uint32_t t1) {
  Gesture first = Gesture::NONE;
  for (uint32_t t = t0; t <= t1; t += 20) { Gesture e = gesture_feed(g, true, x, y, t); if (first == Gesture::NONE) first = e; }
  return first;
}
static Gesture release(uint32_t t) { return gesture_feed(g, false, 0, 0, t); }
static Gesture tap_at(uint32_t t) { hold(100, 100, t, t + 100); return release(t + 120); }

void test_tap() { TEST_ASSERT_EQUAL((int)Gesture::TAP, (int)tap_at(0)); }
void test_too_long_is_not_tap() {
  hold(100, 100, 0, 600);
  TEST_ASSERT_EQUAL((int)Gesture::NONE, (int)release(620));
}
void test_long_press_once_then_release_none() {
  TEST_ASSERT_EQUAL((int)Gesture::LONG_PRESS, (int)hold(100, 100, 0, 1400));
  TEST_ASSERT_EQUAL((int)Gesture::NONE, (int)hold(100, 100, 1420, 2000));
  TEST_ASSERT_EQUAL((int)Gesture::NONE, (int)release(2020));
}
void test_stroke() {
  Gesture first = Gesture::NONE;
  for (int i = 0; i <= 20; i++) {   // 20 Schritte à 5 px = 100 px in 400 ms
    Gesture e = gesture_feed(g, true, 50 + i * 5, 100, i * 20);
    if (first == Gesture::NONE) first = e;
  }
  TEST_ASSERT_EQUAL((int)Gesture::STROKE, (int)first);
  TEST_ASSERT_EQUAL((int)Gesture::NONE, (int)release(500));
}
void test_slow_drag_no_stroke() {
  Gesture any = Gesture::NONE;
  for (int i = 0; i <= 100; i++) {   // 1 px pro 40 ms: in 1,5 s nur ~37 px
    Gesture e = gesture_feed(g, true, 50 + i, 100, i * 40);
    if (e != Gesture::NONE) any = e;
  }
  TEST_ASSERT_EQUAL((int)Gesture::NONE, (int)any);
}
void test_poke_on_fifth_tap() {
  for (int i = 0; i < 4; i++) TEST_ASSERT_EQUAL((int)Gesture::TAP, (int)tap_at(i * 400));
  TEST_ASSERT_EQUAL((int)Gesture::POKE, (int)tap_at(1600));
  TEST_ASSERT_EQUAL((int)Gesture::TAP, (int)tap_at(2000));   // Zähler wieder leer
}
void test_slow_taps_no_poke() {
  for (int i = 0; i < 6; i++) TEST_ASSERT_EQUAL((int)Gesture::TAP, (int)tap_at(i * 800));
}

int main(int, char **) {
  UNITY_BEGIN();
  RUN_TEST(test_tap);
  RUN_TEST(test_too_long_is_not_tap);
  RUN_TEST(test_long_press_once_then_release_none);
  RUN_TEST(test_stroke);
  RUN_TEST(test_slow_drag_no_stroke);
  RUN_TEST(test_poke_on_fifth_tap);
  RUN_TEST(test_slow_taps_no_poke);
  return UNITY_END();
}
```

- [ ] **Step 2:** `pio test -e native -f test_gesture` → FAIL (Header fehlt)
- [ ] **Step 3: Implementierung** `src/logic/gesture.h` nach den Regeln oben. Abstand per `sqrtf(dx*dx+dy*dy)` (`<math.h>`), Weg = Summe der Abstände aufeinanderfolgender Abtastungen. Tipp-Zeitstempel als Ringpuffer der letzten 5; POKE, wenn 5 Stück und `now - ältester ≤ 3000`.
- [ ] **Step 4:** `pio test -e native -f test_gesture` → 7 PASS
- [ ] **Step 5: Gegenprobe** – Schwelle 60 px auf 200 px ändern → `test_stroke` muss FAIL; zurück.
- [ ] **Step 6:** FORTSCHRITT, `git commit -m "feat: Task 2 Gesten (gesture.h) mit Tests"`, push.

---

### Task 3: Augenmodell (`src/logic/eye_model.h`)

**Files:**
- Create: `src/logic/eye_model.h`
- Test: `test/test_eye_model/test_main.cpp`

**Interfaces:**
- Consumes: `Emotion` aus `logic/mood.h`
- Produces:
```cpp
struct EyeShape { float w, h, radius, open, lid_top_tilt, lid_top_cut, lid_bottom_cut, gaze_x, gaze_y; };
struct Rgb { uint8_t r, g, b; };
struct Expression { EyeShape shape; Rgb color; };
inline uint32_t rng_next(uint32_t &s);                         // xorshift32, s != 0
inline uint32_t rng_range(uint32_t &s, uint32_t lo, uint32_t hi); // [lo, hi]
Expression eye_expression(Emotion e);
EyeShape eye_tween(const EyeShape &cur, const EyeShape &target, uint32_t dt_ms);   // k = 1 - expf(-dt/150)
Rgb rgb_tween(Rgb cur, Rgb target, uint32_t dt_ms);
struct Blinker { uint32_t seed, next_ms, start_ms; bool closing; };
void blinker_init(Blinker &b, uint32_t seed, uint32_t now_ms);
float blinker_open(Blinker &b, uint32_t now_ms);   // 1 offen … 0 zu; Blinzeln: 80 ms zu, 120 ms auf, Abstand 2000–6000 ms
struct Gazer { uint32_t seed, next_ms; float gx, gy; };
void gazer_init(Gazer &z, uint32_t seed, uint32_t now_ms);
void gazer_update(Gazer &z, uint32_t now_ms);      // alle 1000–4000 ms neues Ziel, gx ∈ [-30,30], gy ∈ [-15,15]
```
Tabelle (w, h, radius, open, tilt, top_cut, bottom_cut; gaze 0) und Farbe:

| Emotion | Form | Farbe |
|---|---|---|
| CONTENT | 70, 90, 18, 1, 0, 0, 0 | 0, 220, 255 |
| HAPPY | 74, 80, 22, 1, 0, 0, 0.45 | 0, 230, 255 |
| BORED | 70, 90, 18, 0.55, 0, 0.35, 0 | 128, 110, 180 |
| SAD | 64, 86, 18, 0.8, 0.5, 0.2, 0 | 60, 120, 255 |
| SLEEPY | 70, 90, 18, 0.35, 0, 0.5, 0 | 0, 140, 170 |
| SLEEPING | 70, 90, 18, 0.04, 0, 0, 0 | 0, 90, 110 |
| SURPRISED | 84, 104, 30, 1, 0, 0, 0 | 120, 240, 255 |
| LOVE | 70, 86, 22, 1, 0, 0, 0.3 | 255, 80, 170 |
| ANNOYED | 72, 70, 12, 0.9, -0.6, 0.25, 0 | 255, 50, 40 |
| EXCITED | 80, 96, 24, 1, 0, 0, 0.25 | 255, 220, 0 |
| GREETING | 74, 80, 22, 1, 0, 0, 0.45 | 0, 255, 180 |

`lid_top_tilt` > 0 = äußere Ecke hängt (traurig), < 0 = innere Ecke tiefer (böse). Der Renderer spiegelt für das linke Auge.

- [ ] **Step 1: Write the failing test** – `test/test_eye_model/test_main.cpp`:

```cpp
#include <unity.h>
#include "logic/eye_model.h"
void setUp() {}
void tearDown() {}

void test_table_complete() {
  for (int i = 0; i < (int)Emotion::COUNT; i++) {
    Expression x = eye_expression((Emotion)i);
    TEST_ASSERT_TRUE(x.shape.w > 0 && x.shape.h > 0);
    TEST_ASSERT_TRUE(x.shape.open >= 0 && x.shape.open <= 1);
  }
  TEST_ASSERT_EQUAL_UINT8(255, eye_expression(Emotion::ANNOYED).color.r);
  TEST_ASSERT_TRUE(eye_expression(Emotion::ANNOYED).shape.lid_top_tilt < 0);
  TEST_ASSERT_TRUE(eye_expression(Emotion::SAD).shape.lid_top_tilt > 0);
}
void test_tween_converges_and_dt0_noop() {
  EyeShape a = eye_expression(Emotion::CONTENT).shape, b = eye_expression(Emotion::SURPRISED).shape;
  EyeShape c = eye_tween(a, b, 0);
  TEST_ASSERT_FLOAT_WITHIN(0.001f, a.w, c.w);
  for (int i = 0; i < 75; i++) c = eye_tween(c, b, 20);   // 1,5 s
  TEST_ASSERT_FLOAT_WITHIN(0.15f, b.w, c.w);
  TEST_ASSERT_FLOAT_WITHIN(0.15f, b.h, c.h);
}
void test_rng_deterministic() {
  uint32_t s1 = 42, s2 = 42;
  for (int i = 0; i < 10; i++) TEST_ASSERT_EQUAL_UINT32(rng_next(s1), rng_next(s2));
  uint32_t s = 7;
  for (int i = 0; i < 1000; i++) { uint32_t v = rng_range(s, 3, 9); TEST_ASSERT_TRUE(v >= 3 && v <= 9); }
}
void test_blinker_closes_within_window() {
  Blinker b; blinker_init(b, 1234, 0);
  TEST_ASSERT_FLOAT_WITHIN(0.001f, 1.0f, blinker_open(b, 0));
  float minv = 1; uint32_t t_closed = 0;
  for (uint32_t t = 0; t <= 6300; t += 10) { float o = blinker_open(b, t); if (o < minv) { minv = o; t_closed = t; } }
  TEST_ASSERT_TRUE(minv < 0.1f);
  TEST_ASSERT_TRUE(t_closed >= 2000 && t_closed <= 6200);
}
void test_blinker_reopens() {
  Blinker b; blinker_init(b, 99, 0);
  uint32_t t = 0; while (blinker_open(b, t) > 0.5f && t < 7000) t += 5;
  TEST_ASSERT_TRUE(t < 7000);
  TEST_ASSERT_FLOAT_WITHIN(0.001f, 1.0f, blinker_open(b, t + 250));
}
void test_gazer_ranges() {
  Gazer z; gazer_init(z, 5, 0);
  for (uint32_t t = 0; t < 600000; t += 100) {
    gazer_update(z, t);
    TEST_ASSERT_TRUE(z.gx >= -30 && z.gx <= 30);
    TEST_ASSERT_TRUE(z.gy >= -15 && z.gy <= 15);
  }
}

int main(int, char **) {
  UNITY_BEGIN();
  RUN_TEST(test_table_complete);
  RUN_TEST(test_tween_converges_and_dt0_noop);
  RUN_TEST(test_rng_deterministic);
  RUN_TEST(test_blinker_closes_within_window);
  RUN_TEST(test_blinker_reopens);
  RUN_TEST(test_gazer_ranges);
  return UNITY_END();
}
```

- [ ] **Step 2:** `pio test -e native -f test_eye_model` → FAIL
- [ ] **Step 3: Implementierung** – Tabelle als `switch`; `rng_next`: `s ^= s << 13; s ^= s >> 17; s ^= s << 5; return s;` (Seed 0 vorher auf 1 setzen). `blinker_open`: vor `next_ms` → 1; in `[next_ms, next_ms+80)` linear 1→0; in `[next_ms+80, next_ms+200)` linear 0→1; danach `next_ms = now + rng_range(seed, 2000, 6000)` und 1. Erstes `next_ms = now + rng_range(2000, 6000)`.
- [ ] **Step 4:** → 6 PASS
- [ ] **Step 5: Gegenprobe** – Blinzelabstand auf 7000–9000 ändern → `test_blinker_closes_within_window` FAIL; zurück.
- [ ] **Step 6:** FORTSCHRITT, `git commit -m "feat: Task 3 Augenmodell mit Tests"`, push.

---

### Task 4: Wetter-Laune und Overlays (`src/logic/weather_mood.h`)

**Files:**
- Create: `src/logic/weather_mood.h`
- Test: `test/test_weather_mood/test_main.cpp`

**Interfaces:**
- Consumes: `Emotion` (mood.h)
- Produces:
```cpp
enum class Sky : uint8_t { SUNNY, CLOUDY, FOG, RAIN, SNOW, STORM };
struct WeatherMood { Sky sky; bool hot; bool cold; };
WeatherMood weather_mood(int wmo_code, float temp_c);
constexpr uint32_t WEATHER_MAX_AGE_MS = 3UL * 3600UL * 1000UL;
bool weather_fresh(uint32_t now_ms, uint32_t fetched_ms);   // fetched_ms 0 = nie
enum Overlay : uint32_t { OV_HEART = 1, OV_SUNGLASSES = 2, OV_SWEAT = 4, OV_TEAR = 8, OV_ZZZ = 16, OV_SHIVER = 32, OV_RAIN_TINT = 64, OV_STORM = 128 };
uint32_t overlays_for(Emotion e, const WeatherMood *w, bool is_day);   // w = nullptr: kein (frisches) Wetter
```
WMO: 0,1 → SUNNY; 2,3 → CLOUDY; 45,48 → FOG; 51–67, 80–82 → RAIN; 71–77, 85, 86 → SNOW; 95–99 → STORM; sonst CLOUDY. `hot` = temp > 28; `cold` = temp < 0 oder SNOW.
Overlays: LOVE → HEART; SAD → TEAR; SLEEPING → ZZZ (und sonst nichts). Mit Wetter: SUNNY && is_day && (HAPPY || CONTENT || GREETING) → SUNGLASSES; hot → SWEAT; cold → SHIVER; RAIN → RAIN_TINT; STORM → STORM.

- [ ] **Step 1: Write the failing test** – `test/test_weather_mood/test_main.cpp`:

```cpp
#include <unity.h>
#include "logic/weather_mood.h"
void setUp() {}
void tearDown() {}

void test_wmo_mapping() {
  TEST_ASSERT_EQUAL((int)Sky::SUNNY, (int)weather_mood(0, 15).sky);
  TEST_ASSERT_EQUAL((int)Sky::SUNNY, (int)weather_mood(1, 15).sky);
  TEST_ASSERT_EQUAL((int)Sky::CLOUDY, (int)weather_mood(3, 15).sky);
  TEST_ASSERT_EQUAL((int)Sky::FOG, (int)weather_mood(45, 15).sky);
  TEST_ASSERT_EQUAL((int)Sky::RAIN, (int)weather_mood(61, 15).sky);
  TEST_ASSERT_EQUAL((int)Sky::RAIN, (int)weather_mood(81, 15).sky);
  TEST_ASSERT_EQUAL((int)Sky::SNOW, (int)weather_mood(73, -2).sky);
  TEST_ASSERT_EQUAL((int)Sky::SNOW, (int)weather_mood(86, 1).sky);
  TEST_ASSERT_EQUAL((int)Sky::STORM, (int)weather_mood(95, 20).sky);
  TEST_ASSERT_EQUAL((int)Sky::CLOUDY, (int)weather_mood(42, 20).sky);
}
void test_flags() {
  TEST_ASSERT_TRUE(weather_mood(0, 28.5f).hot);
  TEST_ASSERT_FALSE(weather_mood(0, 28.0f).hot);
  TEST_ASSERT_TRUE(weather_mood(3, -0.5f).cold);
  TEST_ASSERT_TRUE(weather_mood(71, 1.0f).cold);
  TEST_ASSERT_FALSE(weather_mood(3, 5.0f).cold);
}
void test_fresh() {
  TEST_ASSERT_FALSE(weather_fresh(1000, 0));
  TEST_ASSERT_TRUE(weather_fresh(1000 + WEATHER_MAX_AGE_MS - 1, 1000));
  TEST_ASSERT_FALSE(weather_fresh(1000 + WEATHER_MAX_AGE_MS + 1, 1000));
}
void test_overlays() {
  WeatherMood sun = weather_mood(0, 30);
  uint32_t o = overlays_for(Emotion::HAPPY, &sun, true);
  TEST_ASSERT_TRUE(o & OV_SUNGLASSES);
  TEST_ASSERT_TRUE(o & OV_SWEAT);
  TEST_ASSERT_FALSE(overlays_for(Emotion::HAPPY, &sun, false) & OV_SUNGLASSES);
  TEST_ASSERT_FALSE(overlays_for(Emotion::SAD, &sun, true) & OV_SUNGLASSES);
  TEST_ASSERT_TRUE(overlays_for(Emotion::SAD, nullptr, true) & OV_TEAR);
  TEST_ASSERT_TRUE(overlays_for(Emotion::LOVE, nullptr, true) & OV_HEART);
  TEST_ASSERT_EQUAL_UINT32(OV_ZZZ, overlays_for(Emotion::SLEEPING, &sun, true));
  WeatherMood rain = weather_mood(63, 10);
  TEST_ASSERT_TRUE(overlays_for(Emotion::CONTENT, &rain, true) & OV_RAIN_TINT);
  WeatherMood storm = weather_mood(96, 10);
  TEST_ASSERT_TRUE(overlays_for(Emotion::CONTENT, &storm, true) & OV_STORM);
}

int main(int, char **) {
  UNITY_BEGIN();
  RUN_TEST(test_wmo_mapping);
  RUN_TEST(test_flags);
  RUN_TEST(test_fresh);
  RUN_TEST(test_overlays);
  return UNITY_END();
}
```

- [ ] **Step 2:** FAIL · **Step 3:** implementieren · **Step 4:** 4 PASS
- [ ] **Step 5: Gegenprobe** – `> 28` zu `>= 28` → `test_flags` FAIL; zurück.
- [ ] **Step 6:** FORTSCHRITT, `git commit -m "feat: Task 4 Wetter-Laune und Overlays mit Tests"`, push.

---

### Task 5: Spiel-Logik (`src/logic/simon.h`, `src/logic/catch_game.h`)

**Files:**
- Create: `src/logic/simon.h`, `src/logic/catch_game.h`
- Test: `test/test_games/test_main.cpp`

**Interfaces:**
- Consumes: `rng_next`, `rng_range` aus `logic/eye_model.h`
- Produces:
```cpp
// simon.h
enum class SimonState : uint8_t { SHOW, INPUT, WON, LOST };
constexpr uint8_t SIMON_WIN_LEN = 6;
struct Simon { uint8_t seq[SIMON_WIN_LEN]; uint8_t len, pos; uint32_t seed; SimonState state; };
void simon_start(Simon &s, uint32_t seed);   // füllt seq[0..5] mit 0..3, len 1, SHOW
void simon_shown(Simon &s);                  // SHOW -> INPUT, pos 0
void simon_press(Simon &s, uint8_t field);   // nur in INPUT; richtig+letzter: len==6 ? WON : len++, SHOW; falsch: LOST
// catch_game.h
constexpr uint32_t CATCH_ROUND_MS = 20000; constexpr uint16_t CATCH_WIN_HITS = 8; constexpr uint8_t CATCH_R = 22;
constexpr int16_t CATCH_W = 320, CATCH_H = 200;
struct CatchGame { int16_t x, y; uint16_t hits; uint32_t start_ms, next_jump_ms, seed; bool over; };
uint32_t catch_jump_interval(uint16_t hits);   // max(450, 1200 - 80*hits)
void catch_start(CatchGame &g, uint32_t seed, uint32_t now_ms);
void catch_tick(CatchGame &g, uint32_t now_ms);   // springt bei next_jump_ms, over nach 20 s
bool catch_tap(CatchGame &g, int16_t x, int16_t y, uint32_t now_ms);   // Treffer: Abstand <= CATCH_R+8; dann hits++, sofort springen
bool catch_won(const CatchGame &g);              // over && hits >= 8
```
Position immer in `[CATCH_R, CATCH_W-CATCH_R] × [CATCH_R, CATCH_H-CATCH_R]`.

- [ ] **Step 1: Write the failing test** – `test/test_games/test_main.cpp`:

```cpp
#include <unity.h>
#include "logic/simon.h"
#include "logic/catch_game.h"
void setUp() {}
void tearDown() {}

static void play_round_correct(Simon &s) {
  simon_shown(s);
  for (uint8_t i = 0; i < s.len; i++) simon_press(s, s.seq[i]);
}
void test_simon_win() {
  Simon s; simon_start(s, 77);
  for (int i = 0; i < SIMON_WIN_LEN; i++) { TEST_ASSERT_EQUAL((int)SimonState::SHOW, (int)s.state); play_round_correct(s); }
  TEST_ASSERT_EQUAL((int)SimonState::WON, (int)s.state);
}
void test_simon_wrong_loses() {
  Simon s; simon_start(s, 77);
  simon_shown(s);
  simon_press(s, (uint8_t)((s.seq[0] + 1) % 4));
  TEST_ASSERT_EQUAL((int)SimonState::LOST, (int)s.state);
}
void test_simon_seq_range_and_seed() {
  Simon a, b; simon_start(a, 5); simon_start(b, 5);
  for (int i = 0; i < SIMON_WIN_LEN; i++) { TEST_ASSERT_TRUE(a.seq[i] < 4); TEST_ASSERT_EQUAL_UINT8(a.seq[i], b.seq[i]); }
}
void test_simon_press_ignored_in_show() {
  Simon s; simon_start(s, 1);
  simon_press(s, s.seq[0]);
  TEST_ASSERT_EQUAL((int)SimonState::SHOW, (int)s.state);
}
void test_catch_interval() {
  TEST_ASSERT_EQUAL_UINT32(1200, catch_jump_interval(0));
  TEST_ASSERT_EQUAL_UINT32(800, catch_jump_interval(5));
  TEST_ASSERT_EQUAL_UINT32(450, catch_jump_interval(20));
}
void test_catch_hit_miss_and_bounds() {
  CatchGame g; catch_start(g, 3, 0);
  for (uint32_t t = 0; t < 19000; t += 50) {
    catch_tick(g, t);
    TEST_ASSERT_TRUE(g.x >= CATCH_R && g.x <= CATCH_W - CATCH_R);
    TEST_ASSERT_TRUE(g.y >= CATCH_R && g.y <= CATCH_H - CATCH_R);
  }
  int16_t x = g.x, y = g.y;
  TEST_ASSERT_TRUE(catch_tap(g, x + 5, y, 19000));
  TEST_ASSERT_EQUAL_UINT16(1, g.hits);
  TEST_ASSERT_FALSE(catch_tap(g, (int16_t)(g.x + 100 > CATCH_W ? g.x - 100 : g.x + 100), g.y, 19010));
}
void test_catch_round_end_and_win() {
  CatchGame g; catch_start(g, 3, 0);
  for (int i = 0; i < 8; i++) catch_tap(g, g.x, g.y, 1000 + i);
  catch_tick(g, 19999);
  TEST_ASSERT_FALSE(g.over);
  catch_tick(g, 20000);
  TEST_ASSERT_TRUE(g.over);
  TEST_ASSERT_TRUE(catch_won(g));
  TEST_ASSERT_FALSE(catch_tap(g, g.x, g.y, 20001));   // nach Ende zählt nichts
}

int main(int, char **) {
  UNITY_BEGIN();
  RUN_TEST(test_simon_win);
  RUN_TEST(test_simon_wrong_loses);
  RUN_TEST(test_simon_seq_range_and_seed);
  RUN_TEST(test_simon_press_ignored_in_show);
  RUN_TEST(test_catch_interval);
  RUN_TEST(test_catch_hit_miss_and_bounds);
  RUN_TEST(test_catch_round_end_and_win);
  return UNITY_END();
}
```

- [ ] **Step 2:** FAIL · **Step 3:** implementieren · **Step 4:** 7 PASS
- [ ] **Step 5: Gegenprobe** – `SIMON_WIN_LEN`-Prüfung in `simon_press` auf `len == 5` → `test_simon_win` FAIL; zurück.
- [ ] **Step 6:** FORTSCHRITT, `git commit -m "feat: Task 5 Spiel-Logik mit Tests"`, push.

---

### Task 6: OTA-Regeln portieren (`src/logic/ota_policy.h`)

**Files:**
- Create: `src/logic/ota_policy.h` (Vorlage: `reference/ha_buddy_ota/ota_policy.h`)
- Test: `test/test_ota_policy/test_main.cpp`

**Interfaces:**
- Produces (gegenüber der Vorlage): `OTA_CHIP_ESP32S3 = 9` → **`OTA_CHIP_ESP32 = 0`** (in `ota_image_check` verwenden); Kommentar Zeile 7 anpassen (Host-Test `test/test_ota_policy`); **neu:**
```cpp
// Nur https:// und Host github.com oder Endung .githubusercontent.com (Umleitungen der Release-Downloads).
static inline bool ota_redirect_ok(const char *url);
```
Host = Teil zwischen `https://` und dem nächsten `/`, `?`, `#` oder `:` bzw. Ende; Vergleich ohne Groß/Klein-Unterschied; leerer Host → false. Alles andere (`ota_hex_ok`, `ota_image_check`, `ota_image_error`, `ota_needs_update`, `OTA_NAG_MS`, `ota_notice_due`, `ota_progress_pct`, `ota_status_line`) unverändert übernehmen.

- [ ] **Step 1: Write the failing test** – `test/test_ota_policy/test_main.cpp`:

```cpp
#include <unity.h>
#include "logic/ota_policy.h"
void setUp() {}
void tearDown() {}

static uint8_t img[OTA_IMG_CHECK_BYTES];
static void make_img(uint16_t chip, const char *proj) {
  memset(img, 0, sizeof img);
  img[0] = 0xE9;
  img[12] = chip & 0xFF; img[13] = chip >> 8;
  img[32] = 0x32; img[33] = 0x54; img[34] = 0xCD; img[35] = 0xAB;
  strncpy((char *)img + 32 + 48, proj, 32);
  for (int i = 0; i < 32; i++) img[32 + 144 + i] = (uint8_t)i;
}
void test_image_ok_esp32() {
  make_img(0, "cyd");
  char elf[65];
  TEST_ASSERT_EQUAL(OTA_IMG_OK, ota_image_check(img, sizeof img, "cyd", elf));
  TEST_ASSERT_EQUAL_STRING("000102030405060708090a0b0c0d0e0f101112131415161718191a1b1c1d1e1f", elf);
}
void test_image_rejects() {
  char elf[65];
  make_img(9, "cyd"); TEST_ASSERT_EQUAL(OTA_IMG_CHIP, ota_image_check(img, sizeof img, "cyd", elf));
  make_img(0, "x");   TEST_ASSERT_EQUAL(OTA_IMG_PROJECT, ota_image_check(img, sizeof img, "cyd", elf));
  make_img(0, "cyd"); img[0] = 0;  TEST_ASSERT_EQUAL(OTA_IMG_MAGIC, ota_image_check(img, sizeof img, "cyd", elf));
  make_img(0, "cyd"); img[32] = 0; TEST_ASSERT_EQUAL(OTA_IMG_DESC, ota_image_check(img, sizeof img, "cyd", elf));
  TEST_ASSERT_EQUAL(OTA_IMG_SHORT, ota_image_check(img, 100, "cyd", elf));
}
void test_needs_update() {
  const char *a = "000102030405060708090a0b0c0d0e0f101112131415161718191a1b1c1d1e1f";
  const char *b = "ff0102030405060708090a0b0c0d0e0f101112131415161718191a1b1c1d1e1f";
  TEST_ASSERT_FALSE(ota_needs_update(a, a));
  TEST_ASSERT_TRUE(ota_needs_update(a, b));
  TEST_ASSERT_FALSE(ota_needs_update(a, "kaputt"));
}
void test_redirect_ok() {
  TEST_ASSERT_TRUE(ota_redirect_ok("https://github.com/M4dm0nky/cyd-buddy/releases/latest/download/manifest.json"));
  TEST_ASSERT_TRUE(ota_redirect_ok("https://release-assets.githubusercontent.com/github-production-release-asset/1?x=1"));
  TEST_ASSERT_TRUE(ota_redirect_ok("https://objects.githubusercontent.com/abc"));
  TEST_ASSERT_TRUE(ota_redirect_ok("https://GitHub.com/x"));
  TEST_ASSERT_FALSE(ota_redirect_ok("http://github.com/x"));
  TEST_ASSERT_FALSE(ota_redirect_ok("https://evilgithub.com/x"));
  TEST_ASSERT_FALSE(ota_redirect_ok("https://github.com.evil.io/x"));
  TEST_ASSERT_FALSE(ota_redirect_ok("https://a.githubusercontent.com.evil.io/x"));
  TEST_ASSERT_FALSE(ota_redirect_ok("https://githubusercontent.com/x"));
  TEST_ASSERT_FALSE(ota_redirect_ok("https:///x"));
  TEST_ASSERT_FALSE(ota_redirect_ok(nullptr));
}
void test_notice_and_progress() {
  TEST_ASSERT_FALSE(ota_notice_due(1000, 0, false));
  TEST_ASSERT_TRUE(ota_notice_due(1000, 0, true));
  TEST_ASSERT_FALSE(ota_notice_due(1000, 2000, true));
  TEST_ASSERT_EQUAL(50, ota_progress_pct(50, 100));
  TEST_ASSERT_EQUAL(0, ota_progress_pct(1, 0));
}

int main(int, char **) {
  UNITY_BEGIN();
  RUN_TEST(test_image_ok_esp32);
  RUN_TEST(test_image_rejects);
  RUN_TEST(test_needs_update);
  RUN_TEST(test_redirect_ok);
  RUN_TEST(test_notice_and_progress);
  return UNITY_END();
}
```

- [ ] **Step 2:** FAIL · **Step 3:** Vorlage kopieren, anpassen, `ota_redirect_ok` ergänzen · **Step 4:** 5 PASS
- [ ] **Step 5: Gegenprobe** – Chip-Konstante zurück auf 9 → `test_image_ok_esp32` FAIL; zurück.
- [ ] **Step 6:** FORTSCHRITT, `git commit -m "feat: Task 6 OTA-Regeln für ESP32 portiert, mit Tests"`, push.

---

### Task 7: Hardware-Schicht (LED, Licht, Speicher)

**Files:**
- Create: `src/hw/led.h`, `src/hw/led.cpp`, `src/hw/light.h`, `src/hw/light.cpp`, `src/hw/store.h`, `src/hw/store.cpp`

**Interfaces:**
- Consumes: `config.h` (Pins, `LDR_DARK_THRESHOLD`, `LDR_HYSTERESIS`), `Rgb` (eye_model.h), `Needs` (mood.h)
- Produces:
```cpp
// led.h – aktiv low, PWM 5 kHz 8 Bit über ledcAttach/ledcWrite (Core 3.x)
void led_begin();
void led_set(Rgb c, uint8_t max_pct);   // skaliert auf max_pct %, invertiert für aktiv low; Rgb{0,0,0} = aus
// light.h – Mittelwert über ~1 s (eine Messung je Aufruf, Ringpuffer 16), Schwelle mit Hysterese
void light_begin();
bool light_update(uint32_t now_ms);     // true = dunkel; höchstens alle 60 ms messen
int  light_raw();                       // letzter Mittelwert (für Info/Seriell)
// store.h – NVS über Preferences, Namensraum "buddy"
struct Persist { Needs needs; uint32_t epoch; uint8_t brightness; char place[48]; float lat, lon; bool has_place; };
void store_defaults(Persist &p);        // needs {60,60,80}, epoch 0, brightness 2 (0..2), place "", has_place false
bool store_load(Persist &p);            // false = nichts gespeichert (dann defaults)
void store_save(const Persist &p);
```
Richtung des LDR: `config.h` enthält `LDR_DARK_IS_HIGH` (1 = höherer Rohwert bedeutet dunkel). Falls Task 0 sie noch nicht eingetragen hat, `#ifndef LDR_DARK_IS_HIGH #define LDR_DARK_IS_HIGH 1` in `light.cpp` mit Kommentar „am Gerät messen“.

- [ ] **Step 1:** Dateien schreiben (je < 80 Zeilen).
- [ ] **Step 2:** `pio run -e cyd2usb` → Build ok (main.cpp benutzt die Module noch nicht; Linker darf sie verwerfen).
- [ ] **Step 3:** FORTSCHRITT, `git commit -m "feat: Task 7 LED, Lichtsensor, NVS-Speicher"`, push.

---

### Task 8: Augen zeichnen und Hauptschleife (`src/ui/eyes.*`, `src/ui/status_bar.*`, `src/ui/icons.*`, `src/app.*`)

**Files:**
- Create: `src/ui/eyes.h`, `src/ui/eyes.cpp`, `src/ui/icons.h`, `src/ui/icons.cpp`, `src/ui/status_bar.h`, `src/ui/status_bar.cpp`, `src/app.h`, `src/app.cpp`
- Modify: `src/main.cpp` (Testbild in `src/ui/testscreen.cpp` als `void testscreen_run(LGFX&)` auslagern, erreichbar wenn beim Start der Bildschirm gedrückt ist; sonst `app_setup()`/`app_loop()`)

**Interfaces:**
- Consumes: alles aus Task 1–4, 7; `LGFX` aus `hw/display.h`
- Produces:
```cpp
// eyes.h
bool eyes_begin(LGFX &lcd);              // Sprite 320x200, 8 Bit (setColorDepth(8)); false = kein Speicher -> direkt zeichnen
void eyes_free();                        // für OTA
bool eyes_ready();
void eyes_draw(LGFX &lcd, const EyeShape &shape, Rgb color, uint32_t overlays, uint32_t now_ms);
// icons.h – Symbole aus Primitiven, (cx, cy) Mitte, s = Kantenlänge
void icon_play(LGFX &d, int cx, int cy, int s, uint32_t col);
void icon_clock(LGFX &d, int cx, int cy, int s, uint32_t col);
void icon_gear(LGFX &d, int cx, int cy, int s, uint32_t col);
void icon_close(LGFX &d, int cx, int cy, int s, uint32_t col);
void icon_wifi(LGFX &d, int cx, int cy, int s, uint32_t col);
void icon_sky(LGFX &d, int cx, int cy, int s, Sky sky, bool is_day);
void icon_sun(LGFX &d, int cx, int cy, int s, uint32_t col);
void icon_update(LGFX &d, int cx, int cy, int s, uint32_t col);   // Pfeil nach unten in Kreis
void icon_info(LGFX &d, int cx, int cy, int s, uint32_t col);
// status_bar.h
struct StatusInfo { bool time_ok; int hour, minute; bool wifi_ok; bool portal; bool weather_ok; Sky sky; bool is_day; float temp_c; bool update_ready; };
void status_draw(LGFX &lcd, const StatusInfo &s);   // y 200..239, nur neu zeichnen, wenn sich etwas geändert hat
// app.h
void app_setup();
void app_loop();
```
Zeichnen der Augen (je Auge, Mittelpunkte x = 160 ∓ 70, y = 100, plus `gaze_x/gaze_y`):
1. Sprite schwarz füllen.
2. Abgerundetes Rechteck `w × (h*open)`, Radius `min(radius, h*open/2)`, Farbe `color` (RAIN_TINT: Farbe 30 % Richtung (60,120,255) mischen).
3. Oberes Lid: schwarzes Dreieck/Viereck, das `lid_top_cut*h` von oben abdeckt, mit Neigung `lid_top_tilt*h*0.5` (rechtes Auge: äußere Ecke = rechts; linkes Auge gespiegelt).
4. Unteres Lid („Lächeln“): schwarzer Kreis/Ellipse von unten, der `lid_bottom_cut*h` abdeckt.
5. Overlays: HEART = zwei kleine pinke Herzen über den Augen, pulsierend (`sinf(now/200)`); SUNGLASSES = schwarzes Brillengestell mit dunkelgrauen Gläsern über beiden Augen; SWEAT = hellblauer Tropfen rechts oben, fällt alle 2 s; TEAR = Tropfen unter dem linken Auge; ZZZ = drei „Z“ steigend rechts oben; SHIVER = ganze Zeichnung ±2 px in x je Bild; STORM = alle 4 min für 1 s Augen weit (`SURPRISED`-Form) – das macht `app.cpp`, nicht der Renderer.
6. `pushSprite(0, 0)`.

`app.cpp` (Ablauf je `app_loop()`, Ziel 25–30 Bilder/s, `delay` nur über Bildtakt):
- Touch lesen (`lcd.getTouch(&x,&y)`), `gesture_feed`; TAP/STROKE/POKE → `mood_event`; LONG_PRESS → Menü (Task 10, bis dahin ignorieren).
- `light_update` → `mood_set_dark(…, net_hour() oder -1, now)` (bis Task 9: Stunde -1).
- `mood_tick` mit dt; Emotion → `eye_expression`; Blinker (Öffnung multiplizieren), Gazer (gaze addieren; beim Schlafen gaze 0), Tween; Farbe tweenen.
- Overlays über `overlays_for`; LED = Farbe, 15 %, beim Schlafen aus; Hintergrundlicht beim Schlafen 10 %, sonst Stufe `brightness` (0: 30 %, 1: 60 %, 2: 100 %).
- Alle 10 min `store_save` (Bedürfnisse, Epoche wenn Zeit bekannt).
- Seriell alle 60 s: `heap=<ESP.getFreeHeap()> min=<ESP.getMinFreeHeap()> fps=<n> emo=<int>`.
- Beim Start: `store_load`, `mood_init` mit gespeicherten Bedürfnissen; wenn Epoche gespeichert und Zeit bekannt (ab Task 9) einmalig `mood_apply_elapsed`.

- [ ] **Step 1:** Dateien schreiben.
- [ ] **Step 2:** `pio run -e cyd2usb` → Build ok; RAM-Auslastung aus der Ausgabe in FORTSCHRITT notieren.
- [ ] **Step 3:** `pio test -e native` → alle bisherigen Tests weiter PASS.
- [ ] **Step 4:** FORTSCHRITT (mit Vermerk „am Gerät zu prüfen: Augen flüssig, Gesten, LDR“), `git commit -m "feat: Task 8 Augen-Renderer, Statusstreifen, Hauptschleife"`, push.

---

### Task 9: Netz (`src/net/net.*`)

**Files:**
- Create: `src/net/net.h`, `src/net/net.cpp`
- Modify: `src/app.cpp` (net einbinden, Statusstreifen füttern, Stunde an mood)

**Interfaces:**
- Consumes: `Persist`, `store_save` (Task 7), `weather_mood` (Task 4)
- Produces:
```cpp
struct NetWeather { bool valid; int code; float temp_c; bool is_day; uint32_t fetched_ms; };
void net_begin(Persist *p);          // WiFiManager nicht blockierend, AP "CYD-Buddy", Zusatzfeld "Ort" (id "place", 47 Zeichen, vorbelegt mit p->place); startet net_task
void net_loop();                     // aus app_loop: wm.process(); speichert geänderten Ort (has_place=false -> Geocoding im Task)
bool net_wifi_ok();
bool net_portal_active();
void net_open_portal();              // Einstellungen: Portal (erneut) öffnen
bool net_time_ok();                  // time(nullptr) > 1700000000
int  net_hour();                     // -1 wenn Zeit unbekannt
bool net_local_time(struct tm *out);
uint32_t net_epoch();                // 0 wenn unbekannt
NetWeather net_weather();            // threadsichere Kopie (portMUX)
void net_task_hook(void (*fn)());    // Task 13 hängt ota_pull::loop() ein; wird im net_task nach dem Wetter aufgerufen
```
Ablauf `net_task` (Kern 0, Priorität 1, Stack 8192): Schleife alle 1 s: wenn WLAN da → einmal `configTzTime("CET-1CEST,M3.5.0,M10.5.0/3", "pool.ntp.org", "time.google.com")`; wenn `!has_place && place[0]` → Geocoding über HTTPS (`WiFiClientSecure` mit `setCACertBundle` des Cores – Name der Funktion/des Symbols im Core 3.x nachsehen, z. B. `client.setCACertBundle(...)` bzw. `NetworkClientSecure`; **kein** `setInsecure`), Ort URL-kodieren, `results[0].latitude/longitude/name` → `Persist`, `has_place=true`, `store_save`; wenn `has_place` und (nie oder > 30 min) → Wetter per HTTP (URL aus der Spec), JSON `current.temperature_2m`, `current.weather_code`, `current.is_day`; Fehler: nach 5 min erneut. Danach Hook aufrufen.
JSON mit `JsonDocument` + Filter (`DeserializationOption::Filter`), damit wenig RAM gebraucht wird.

- [ ] **Step 1:** Mit `curl` prüfen, dass die URLs wirklich so antworten (Beispielort „Berlin“), Antwortausschnitt in FORTSCHRITT:
  `curl -s "https://geocoding-api.open-meteo.com/v1/search?name=Berlin&count=1&language=de"` und
  `curl -s "http://api.open-meteo.com/v1/forecast?latitude=52.52&longitude=13.41&current=temperature_2m,weather_code,is_day&timezone=Europe%2FBerlin"`
  (Geht `http://` nicht, im Code HTTPS verwenden und das in FORTSCHRITT vermerken.)
- [ ] **Step 2:** `net.*` schreiben, in `app.cpp` einbinden.
- [ ] **Step 3:** `pio run -e cyd2usb` → Build ok, Größe notieren.
- [ ] **Step 4:** FORTSCHRITT, `git commit -m "feat: Task 9 WLAN-Portal, NTP, Ort und Wetter"`, push.

---

### Task 10: Menü, Uhr, Einstellungen (`src/ui/menu.*`, `src/ui/clock_view.*`, `src/ui/settings.*`)

**Files:**
- Create: `src/ui/menu.h/.cpp`, `src/ui/clock_view.h/.cpp`, `src/ui/settings.h/.cpp`
- Modify: `src/app.cpp` (Bildschirm-Zustand `enum class Screen { EYES, MENU, CLOCK, SETTINGS, GAME_CATCH, GAME_SIMON, OTA }`)

**Interfaces:**
- Consumes: `icons.h`, `net.h`, `Persist`, `store_save`
- Produces:
```cpp
enum class MenuChoice : uint8_t { NONE, PLAY_CATCH, PLAY_SIMON, CLOCK, SETTINGS, CLOSE };
void menu_open(LGFX &lcd, uint32_t now_ms);
MenuChoice menu_touch(int16_t x, int16_t y);            // nur bei TAP aufrufen
bool menu_timed_out(uint32_t now_ms);                   // 10 s ohne Eingabe
void clock_open(LGFX &lcd, uint32_t now_ms);
bool clock_update(LGFX &lcd, uint32_t now_ms);          // false = 15 s vorbei
enum class SettingsAction : uint8_t { NONE, CLOSE, BRIGHTNESS, PORTAL, OTA_CHECK };
void settings_open(LGFX &lcd, const Persist &p, uint32_t now_ms);
SettingsAction settings_touch(int16_t x, int16_t y);
void settings_redraw(LGFX &lcd, const Persist &p);      // nach Änderung
```
Menü: 2×2 große Kacheln (je ~140×90 px, farbig: Spielen grün, Uhr gelb, Einstellungen violett, Schließen rot) mit Symbol in der Mitte; „Spielen“ öffnet eine zweite Ebene mit zwei Kacheln (Fang-mich-Symbol = Kreis mit Fadenkreuz, Simon-Symbol = vier farbige Viertel). Uhr: Zeit in großer Schrift (LovyanGFX `Font7` oder `FreeSansBold24pt7b`), Datum deutsch („So 25.10.“), Wetter-Symbol + Temperatur; ohne Zeit „--:--“ und WLAN-Symbol rot. Einstellungen: Zeilen mit Symbol links: Helligkeit (3 Balken, Tippen schaltet 0→1→2→0), WLAN/Ort (Portal öffnen), Firmware (Text aus `ota_status_line`, ab Task 13; bis dahin „–“), Info (Version = Build-Datum, freier Heap, LDR-Wert); Schließen-Symbol oben rechts. Beim Öffnen von Menü/Uhr/Einstellungen wird das Sprite **nicht** benutzt (direkt zeichnen), beim Zurück zu EYES `status_draw` erzwingen.

- [ ] **Step 1:** Dateien schreiben, in `app.cpp` verdrahten.
- [ ] **Step 2:** `pio run -e cyd2usb` → Build ok.
- [ ] **Step 3:** FORTSCHRITT, `git commit -m "feat: Task 10 Menü, Uhr, Einstellungen"`, push.

---

### Task 11: Spiel-Bildschirme (`src/ui/game_catch.*`, `src/ui/game_simon.*`)

**Files:**
- Create: `src/ui/game_catch.h/.cpp`, `src/ui/game_simon.h/.cpp`
- Modify: `src/app.cpp`

**Interfaces:**
- Consumes: `catch_game.h`, `simon.h`, `eyes.h` (für ein kleines Auge zeichnen: eigene Hilfsfunktion im Spiel, nicht das große Sprite)
- Produces:
```cpp
enum class GameResult : uint8_t { RUNNING, WON, LOST };
void game_catch_open(LGFX &lcd, uint32_t now_ms);
GameResult game_catch_update(LGFX &lcd, bool tap, int16_t x, int16_t y, uint32_t now_ms);
void game_simon_open(LGFX &lcd, uint32_t now_ms);
GameResult game_simon_update(LGFX &lcd, bool tap, int16_t x, int16_t y, uint32_t now_ms);
```
Fang mich: kleines cyan Auge (Radius `CATCH_R`) auf Schwarz, alte Position schwarz übermalen; oben Restzeit als Balken, Treffer als Punkte. Simon: vier Felder (rot, grün, blau, gelb, Viertel des 320×200-Bereichs); Anzeige: jedes Feld 500 ms hell, 200 ms Pause; Tippen lässt das Feld 150 ms aufleuchten. Ende: 2 s Ergebnis (gewonnen = großes gelbes Augenpaar `EXCITED`, verloren = Augen `BORED`), dann zurück zu EYES und `mood_event(GAME_WON/GAME_LOST)`. Seed aus `esp_random()`.

- [ ] **Step 1:** Dateien schreiben, verdrahten.
- [ ] **Step 2:** `pio run -e cyd2usb` → ok; `pio test -e native` → alles PASS.
- [ ] **Step 3:** FORTSCHRITT, `git commit -m "feat: Task 11 Spiele Fang mich und Simon"`, push.

---

### Task 12: OTA-Abruf portieren (`src/ota/ota_pull.*`, `src/ui/ota_card.*`)

**Files:**
- Create: `src/ota/ota_pull.h`, `src/ota/ota_pull.cpp` (Vorlage `reference/ha_buddy_ota/ota_pull.*`), `src/ui/ota_card.h`, `src/ui/ota_card.cpp`
- Modify: `src/app.cpp`, `src/net/net.cpp` (Hook), `src/ui/settings.cpp` (Firmware-Zeile)

**Interfaces:**
- Consumes: `ota_policy.h` (Task 6), `net_wifi_ok()`, `net_task_hook()`, `eyes_free()/eyes_begin()`
- Produces: Header wie Vorlage (`ota_pull::begin/loop/info/consent/check_now/check_busy/snooze/dismiss_failure/ui_alive/slot/image_state/elf12/build`), plus
```cpp
// ota_card.h
bool ota_card_wanted(uint32_t now_ms, bool awake);   // Zustand AVAILABLE && ota_notice_due(...) oder DOWNLOADING/VERIFYING/RESTARTING/FAILED
void ota_card_draw(LGFX &lcd, uint32_t now_ms);      // Karte bzw. Fortschritt; zeichnet nur bei Änderung
void ota_card_touch(int16_t x, int16_t y, uint32_t now_ms);   // Ja -> consent(), Später/daneben -> snooze(), bei FAILED -> dismiss_failure(); Tipps < 1 s nach Erscheinen ignorieren
```
Änderungen gegenüber der Vorlage (alle!):
1. Includes: `ha/ha_ws.h`, `config/secrets.h`, `util/psram_alloc.h`, `diag/diag.h` entfernen. `diag_event(...)` → `Serial.printf("ota: %s\n", ...)`.
2. `SECRET_OTA_*`, `make_url`, `add_auth` ersetzen durch `constexpr const char *kBase = "https://github.com/M4dm0nky/cyd-buddy/releases/latest/download";`, Dateien `manifest.json` / Name aus dem Manifest (`firmware.bin`).
3. Neue Funktion `bool open_follow(HTTPClient &http, WiFiClientSecure &tls, const char *url, int *code)`: `http.setFollowRedirects(HTTPC_DISABLE_FOLLOW_REDIRECTS)`, `const char *keys[] = {"Location"}; http.collectHeaders(keys, 1)`, bis zu 3 Sprünge; jede URL (auch die erste) muss `ota_redirect_ok()` bestehen, sonst Fehler „Umleitung abgelehnt“. TLS-Client mit dem Zertifikatspaket des Cores (wie Task 9).
4. `JsonDocument doc(psram_allocator())` → `JsonDocument doc;` mit Filter für `project, elf, sha256, size, file, built`.
5. `heap_caps_malloc(kChunk, MALLOC_CAP_SPIRAM)` → `malloc(kChunk)`.
6. Gesundheitsnachweis: `g_ui_alive && now > kHealthAfterMs` (ohne `ha::connected()`).
7. `project_name()` bleibt (Name der laufenden Firmware).
8. `kMinSize` 200 KB bleibt; zusätzlich `size > 1966080` → „zu groß für den Slot“.
9. `ota_pull::loop()` läuft über `net_task_hook` im `net_task`.
`app.cpp`: Bei `ota_card_wanted` → Screen OTA. Bei Zustand DOWNLOADING: vorher `eyes_free()`, Fortschrittsbalken + zwei schmale „konzentrierte“ Augen (direkt gezeichnet). Nach FAILED und Bestätigung: `eyes_begin()` erneut. `ota_pull::ui_alive()` in jedem Bild von EYES aufrufen. Settings-Zeile „Firmware“: Text aus `ota_status_line(...)`, Tippen → `ota_pull::check_now()`.

- [ ] **Step 1:** Dateien schreiben, verdrahten.
- [ ] **Step 2:** `pio run -e cyd2usb` → ok, Image-Größe < 1 966 080 B (aus `.pio/build/cyd2usb/firmware.bin`, `ls -l`).
- [ ] **Step 3:** `pio test -e native` → alles PASS.
- [ ] **Step 4:** FORTSCHRITT, `git commit -m "feat: Task 12 OTA über GitHub-Release mit Zustimmung am Display"`, push.

---

### Task 13: Veröffentlichungs-Skript (`tools/ota-publish.mjs`)

**Files:**
- Create: `tools/ota-publish.mjs` (Vorlage `reference/ha_buddy_ota/ota-publish.mjs`), `tools/ota-publish.test.mjs`

**Interfaces:**
- Produces: `export function inspectImage(buf, project)` (wie Vorlage, Chip **0**, Fehlertext „falscher Chip (erwartet ESP32)“); CLI:
  - `node tools/ota-publish.mjs --check` – neueste `.pio/build/cyd2usb/firmware.bin` prüfen, Projektname/ELF/Größe ausgeben, nichts schreiben
  - `node tools/ota-publish.mjs` – nach `ota-out/` schreiben (`firmware.bin`, zuletzt `manifest.json`, atomar per `.tmp` + rename)
  - `node tools/ota-publish.mjs --release` – zusätzlich `gh release create v<YYYYMMDD-HHMM> ota-out/firmware.bin ota-out/manifest.json --latest --repo M4dm0nky/cyd-buddy --title "Firmware <built>" --notes "Commit <commit>"`
  
  Änderungen gegenüber Vorlage: `SKETCH`/`newestBin` → `.pio/build/cyd2usb/firmware.bin`; `newestSource` über `src/`; `PROJECT` als Konstante mit Kommentar „aus erstem Build per --check ermittelt“ – bis dahin `process.env.CYD_PROJECT || 'arduino-lib-builder'` und bei `--check` den gefundenen Namen ausgeben; Slot-Grenze 1 966 080; Namen `manifest.json`/`firmware.bin`; `--serve`, `--ha`, `uploadHa`, `secretToken` **entfernen**; Git-Prüfpfade `src tools platformio.ini`.

- [ ] **Step 1: Write the failing test** – `tools/ota-publish.test.mjs` (läuft mit `node --test tools/`):

```js
import test from 'node:test';
import assert from 'node:assert/strict';
import { inspectImage } from './ota-publish.mjs';

function img(chip, proj) {
  const b = Buffer.alloc(300);
  b[0] = 0xe9; b.writeUInt16LE(chip, 12); b.writeUInt32LE(0xabcd5432, 32);
  b.write(proj, 32 + 48, 'latin1');
  for (let i = 0; i < 32; i++) b[32 + 144 + i] = i;
  return b;
}
test('ESP32-Image wird erkannt', () => {
  const r = inspectImage(img(0, 'cyd'), 'cyd');
  assert.equal(r.error, undefined);
  assert.equal(r.elf, '000102030405060708090a0b0c0d0e0f101112131415161718191a1b1c1d1e1f');
});
test('S3-Image wird abgelehnt', () => assert.match(inspectImage(img(9, 'cyd'), 'cyd').error, /falscher Chip/));
test('falsches Projekt', () => assert.match(inspectImage(img(0, 'x'), 'cyd').error, /falsches Projekt/));
```
Damit der Import nicht die CLI startet: Hauptteil nur ausführen, wenn `import.meta.url === pathToFileURL(process.argv[1]).href`.

- [ ] **Step 2:** `node --test tools/` → FAIL (Datei fehlt)
- [ ] **Step 3:** Skript portieren.
- [ ] **Step 4:** `node --test tools/` → 3 PASS; `pio run -e cyd2usb && node tools/ota-publish.mjs --check` → Ausgabe mit Projektname in FORTSCHRITT. Den Namen als Konstante `PROJECT` eintragen.
- [ ] **Step 5: Gegenprobe** – Chip im Skript auf 9 → Test 1 FAIL; zurück.
- [ ] **Step 6:** FORTSCHRITT, `git commit -m "feat: Task 13 ota-publish für GitHub-Releases"`, push. **Nicht** `--release` ausführen.

---

### Task 14: Doku und Abschluss

**Files:**
- Create: `docs/ota.md` (nach Vorlage `reference/ha_buddy_ota/ota-7in.md`, angepasst: GitHub-Release, keine Geheimnisse in der .bin, Ablauf, Prüfungen, Alltag `pio run -e cyd2usb && node tools/ota-publish.mjs --release`, Grenzen: Rollback ungeprüft, erster Flash per Kabel)
- Modify: `README.md` (Bedienung: Gesten, Menü, Portal „CYD-Buddy“, Ort; Entwicklung; Verweis auf docs/ota.md)

- [ ] **Step 1:** Doku schreiben.
- [ ] **Step 2:** Abschlussprüfung: `pio test -e native` (alle PASS, Anzahl notieren), `node --test tools/` (PASS), `pio run -e cyd2usb` (ok, Flash-/RAM-Größe notieren).
- [ ] **Step 3:** FORTSCHRITT „Task 14 – ERLEDIGT“ mit Liste „am Gerät zu prüfen“ (aus der Spec, Abschnitt Prüfung), `git commit -m "docs: Task 14 OTA-Doku und README"`, push.
