M4dm0nky/cyd-buddy/case/render/madbuddy_front.png

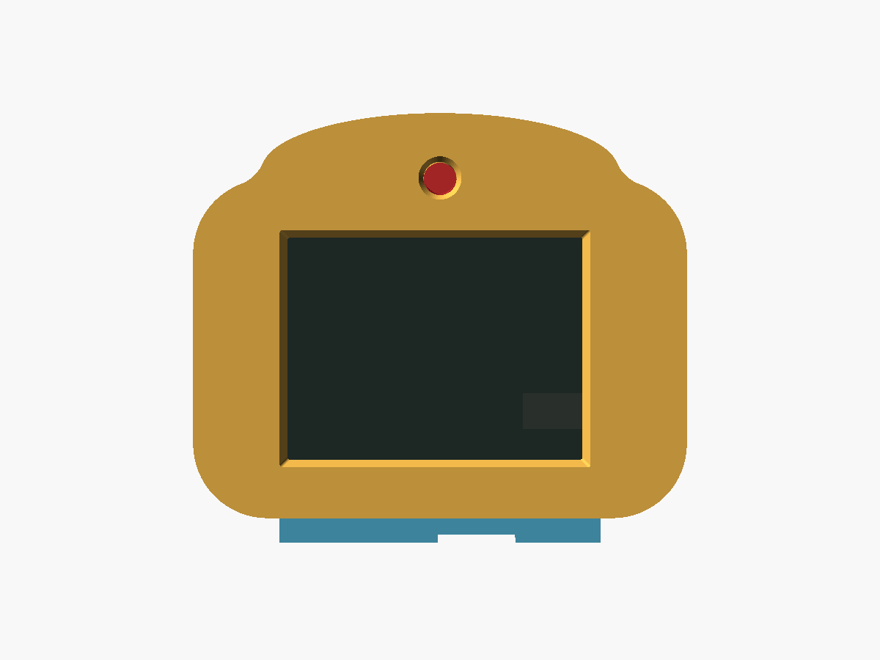
case/render/madbuddy_front.png
