M4dm0nky/cyd-buddy/case/render/madbuddy_hinten.png

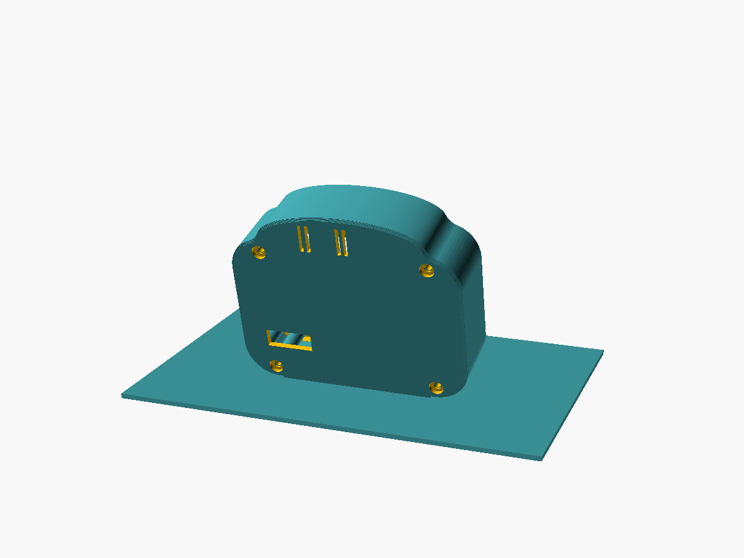
case/render/madbuddy_hinten.png
