M4dm0nky/cyd-buddy/case/render/madbuddy_kamera_schnitt.png

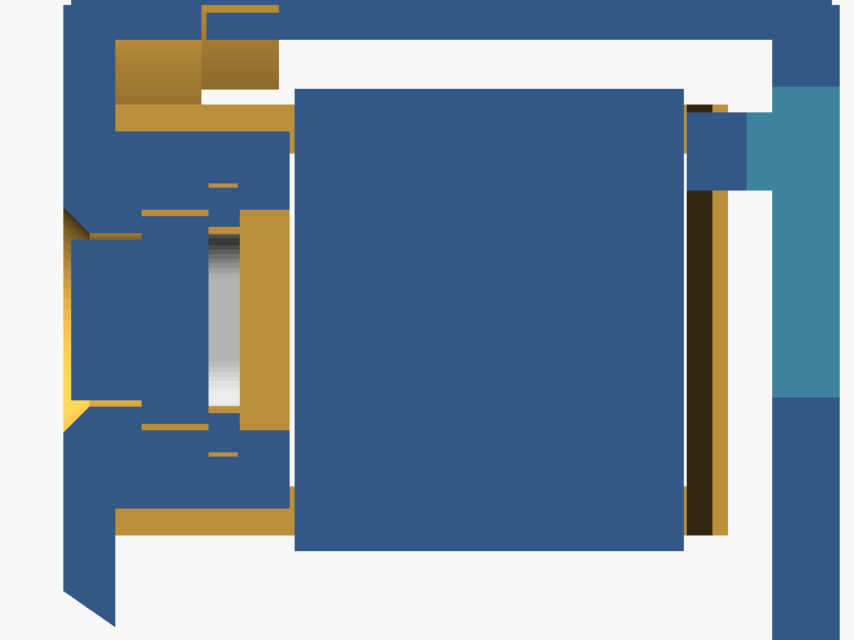
case/render/madbuddy_kamera_schnitt.png
