M4dm0nky/cyd-buddy/case/render/madbuddy_schnitt.png

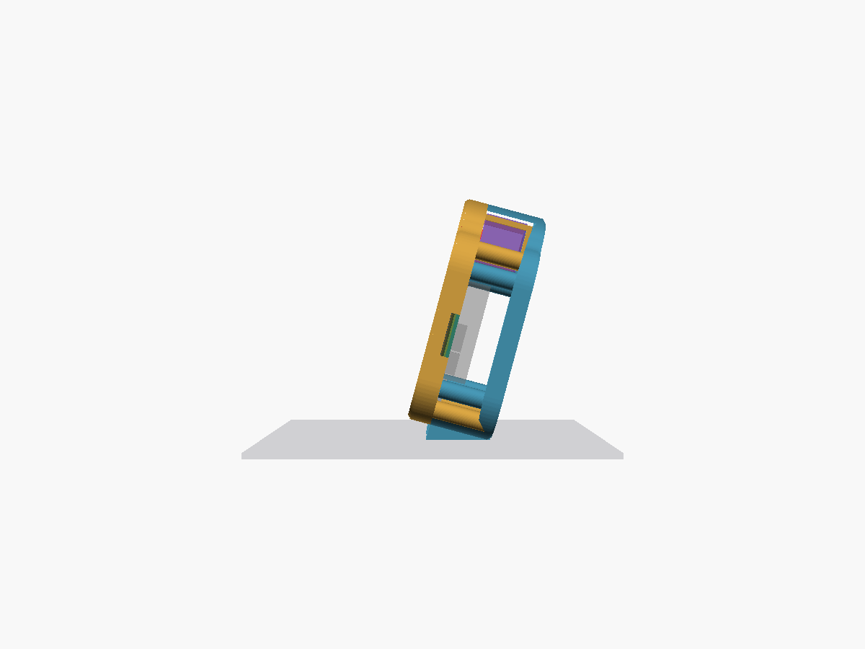
case/render/madbuddy_schnitt.png
