M4dm0nky/cyd-buddy/case/render/roboter_exploded.png

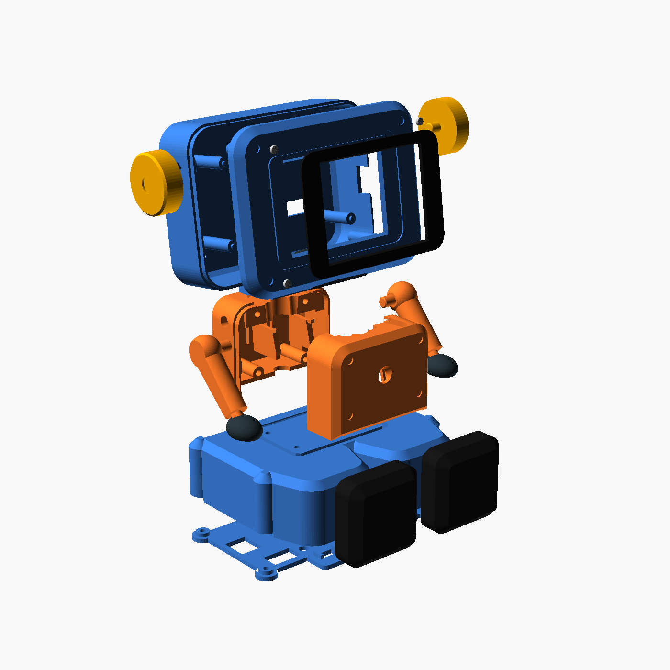
case/render/roboter_exploded.png
