M4dm0nky/cyd-buddy/case/render/roboter_kamera_schnitt.png

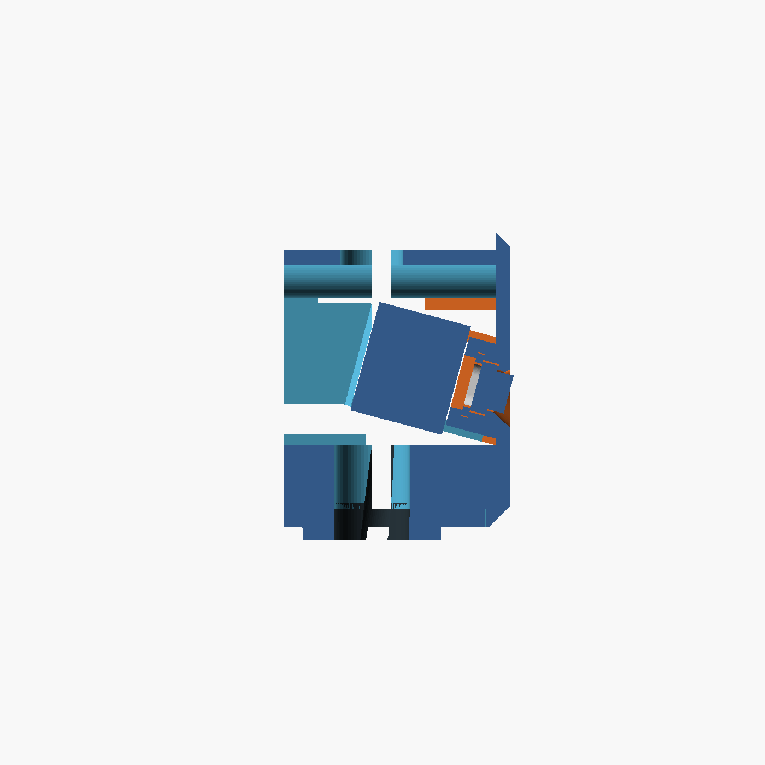
case/render/roboter_kamera_schnitt.png
