M4dm0nky/cyd-buddy/case/render/roboter_links.png

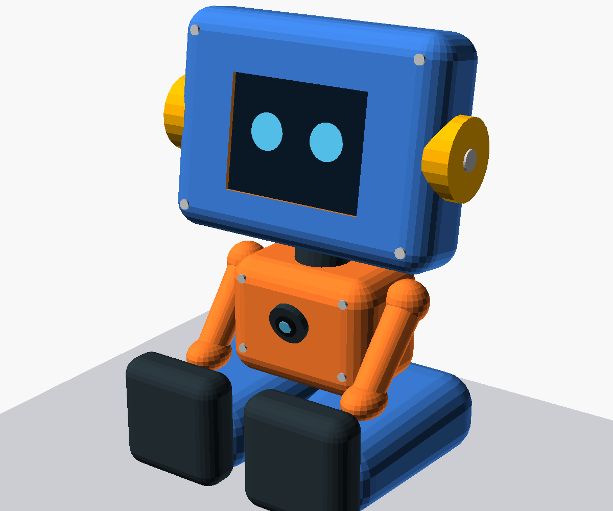
case/render/roboter_links.png
