M4dm0nky/cyd-buddy/case/render/roboter_section.png

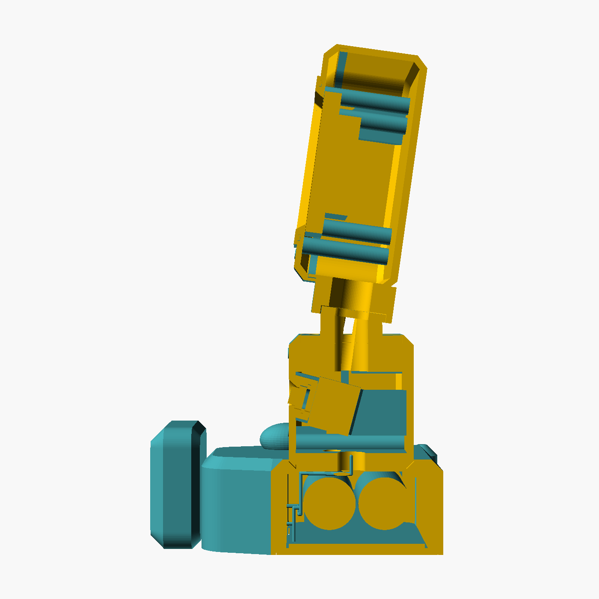
case/render/roboter_section.png
