M4dm0nky/cyd-buddy/case/render/roboter_seite.png

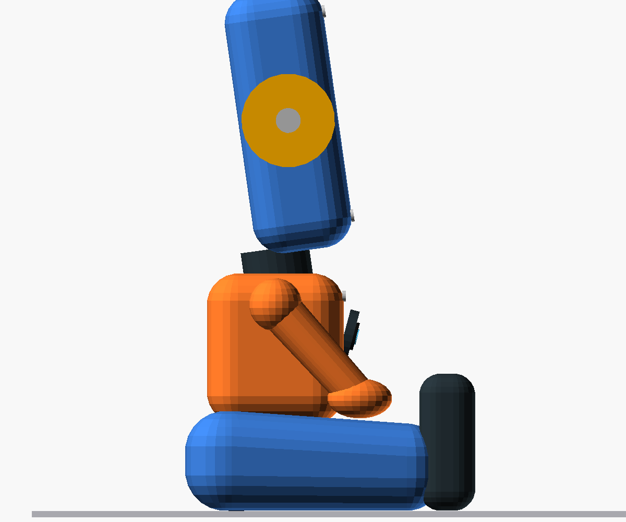
case/render/roboter_seite.png
