M4dm0nky/cyd-buddy/case/3mf/roboter_teile.3mf

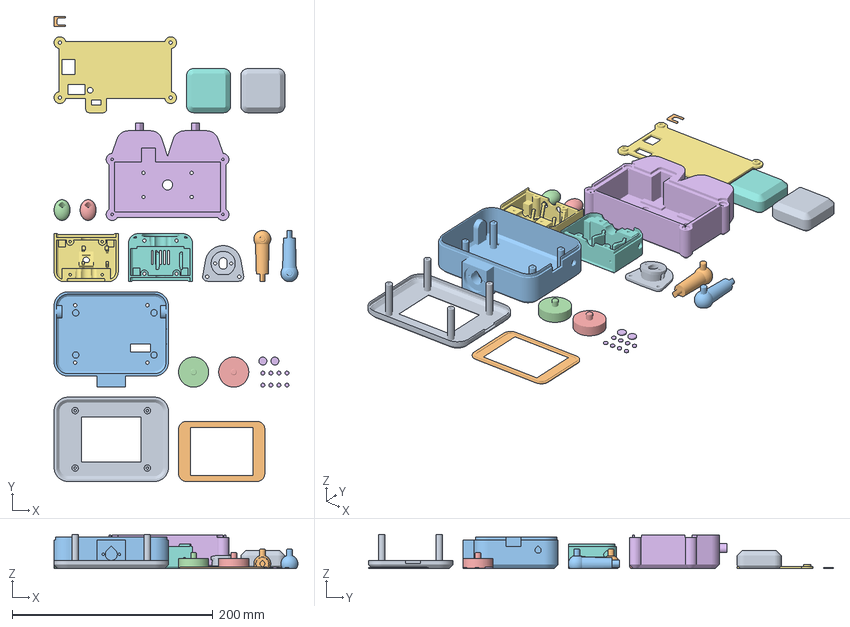
[picture p13: CAD file, 2026-10-28]
case/3mf/roboter_teile.3mf
243.0 x 463.2 x 34.3 mm
head_front
bezel
head_back
ear_r
ear_l
deco
torso_front
torso_back
neck
arm_r
arm_l
hand_r
hand_l
seat
bottom
foot_r
foot_l
cam_clip
