M4dm0nky/cyd-buddy/case/stl/roboter_torso_front.stl

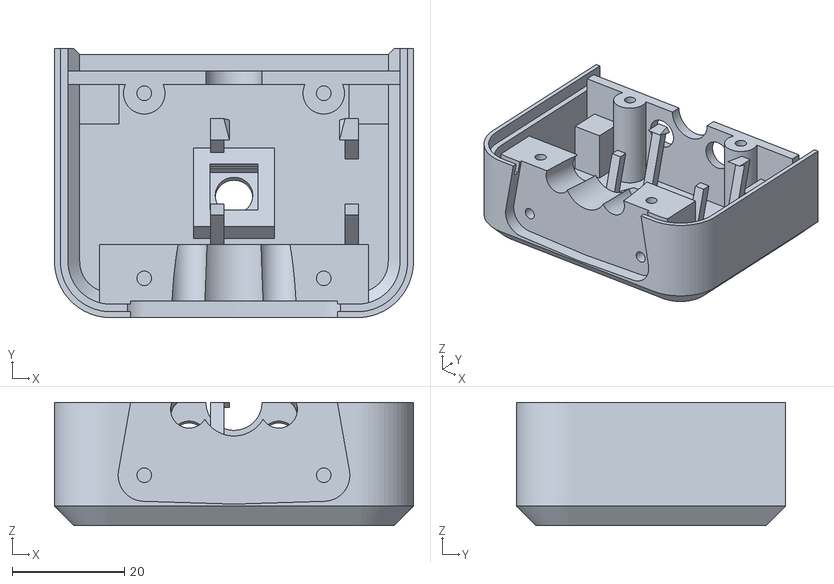
[picture p14: CAD file, 2026-10-28]
case/stl/roboter_torso_front.stl
64.0 x 48.0 x 22.0
