M4dm0nky/cyd-buddy/case/stl/roboter_torso_back.stl

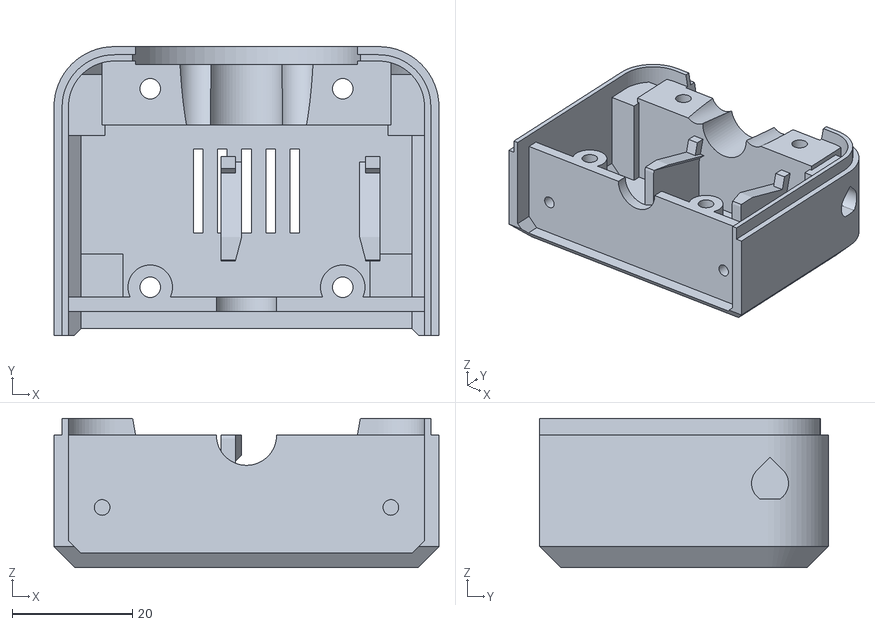
[picture p16: CAD file, 2026-10-28]
case/stl/roboter_torso_back.stl
64.0 x 48.0 x 24.8
