M4dm0nky/cyd-buddy/case/stl/madbuddy_front.stl

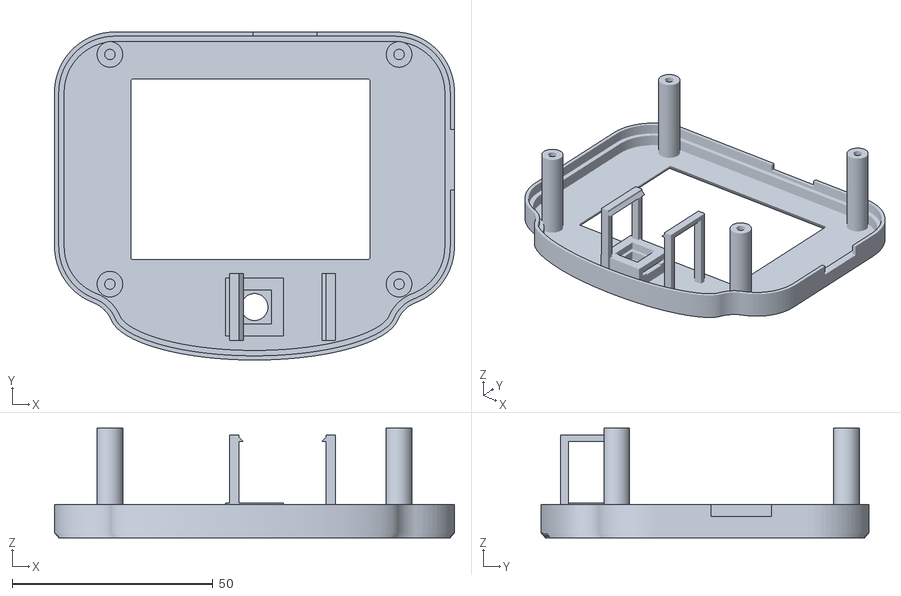
[picture p17: CAD file, 2026-10-28]
case/stl/madbuddy_front.stl
99.6 x 81.7 x 27.3
