M4dm0nky/cyd-buddy/case/stl/roboter_cam_clip.stl

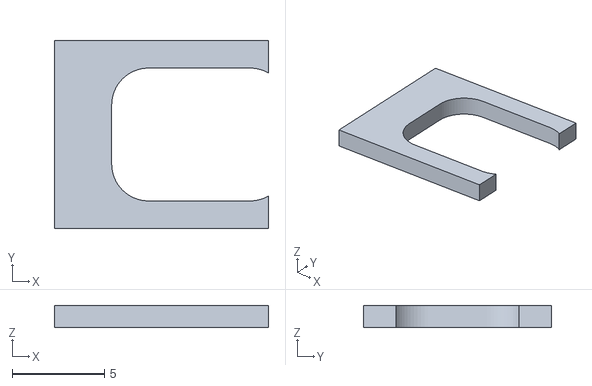
[picture p18: CAD file, 2026-10-28]
case/stl/roboter_cam_clip.stl
11.6 x 10.2 x 1.20
