M4dm0nky/cyd-buddy/case/stl/madbuddy_back.stl

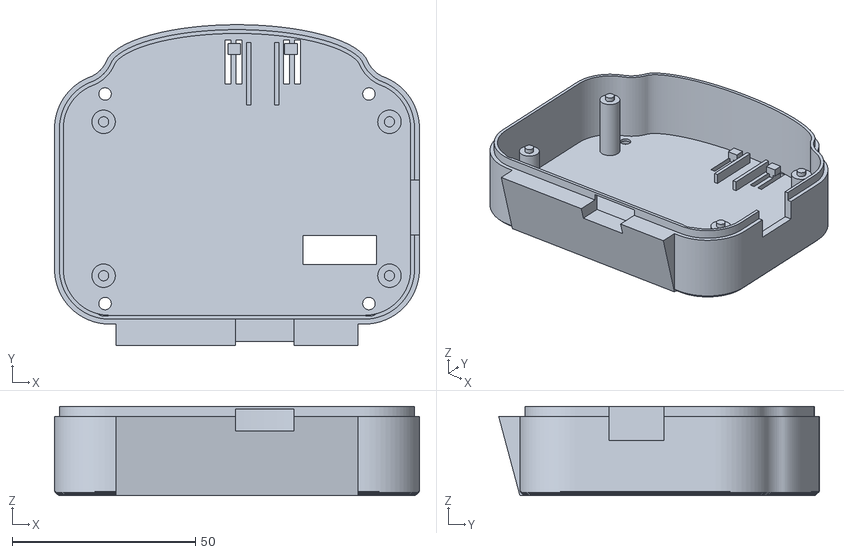
[picture p19: CAD file, 2026-10-28]
case/stl/madbuddy_back.stl
99.6 x 87.5 x 24.4
