M4dm0nky/cyd-buddy/case/stl/roboter_arm_l.stl

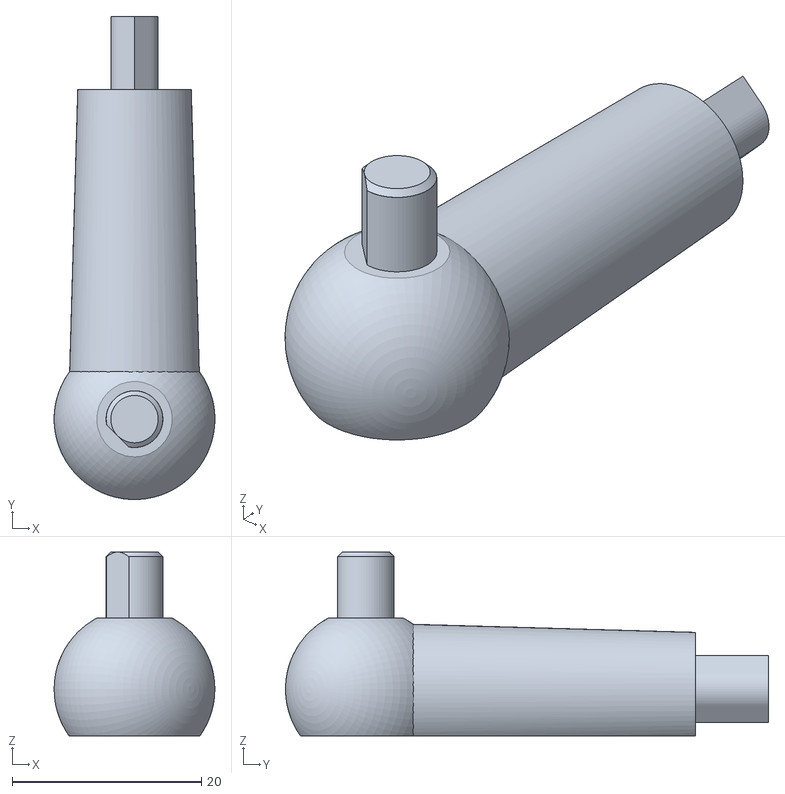
[picture p20: CAD file, 2026-10-28]
case/stl/roboter_arm_l.stl
17.0 x 51.0 x 19.4
