M4dm0nky/cyd-buddy/case/stl/roboter_bezel_inlay.stl

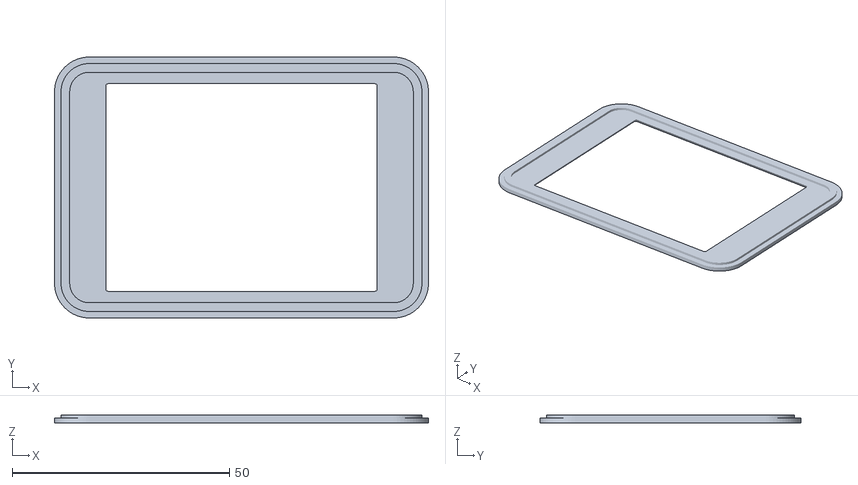
[picture p21: CAD file, 2026-10-28]
case/stl/roboter_bezel_inlay.stl
86.0 x 60.0 x 1.90
