M4dm0nky/cyd-buddy/case/stl/roboter_head_front_ams.stl

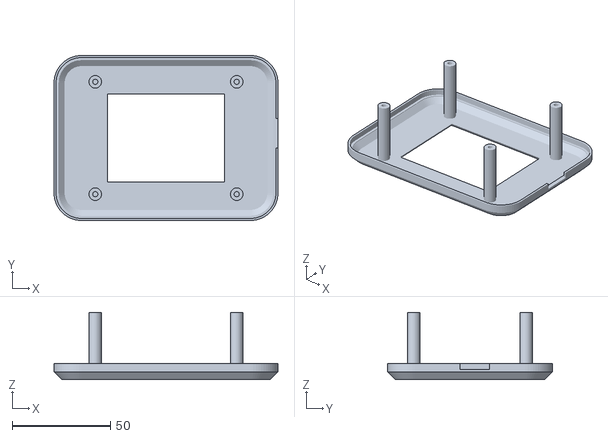
[picture p22: CAD file, 2026-10-28]
case/stl/roboter_head_front_ams.stl
114.0 x 84.0 x 34.3
