M4dm0nky/cyd-buddy/case/stl/roboter_deco.stl

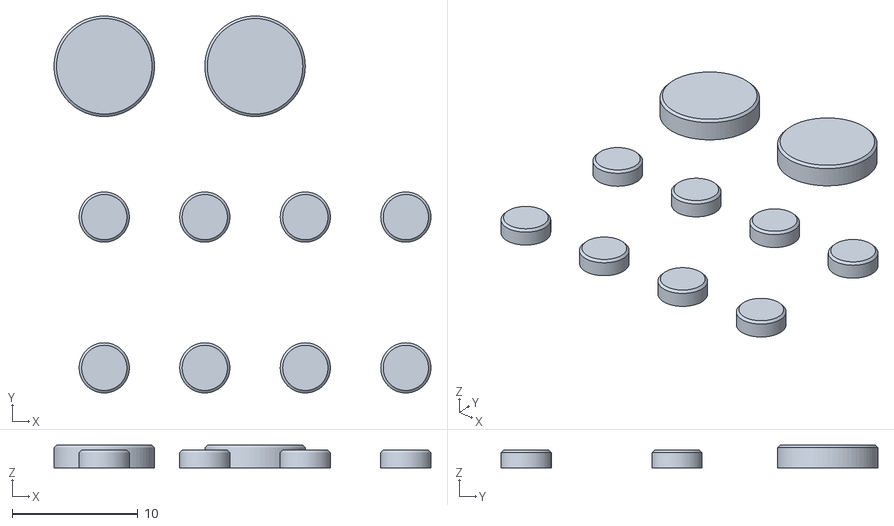
[picture p23: CAD file, 2026-10-28]
case/stl/roboter_deco.stl
30.0 x 30.0 x 1.80
