M4dm0nky/cyd-buddy/case/stl/roboter_ear.stl

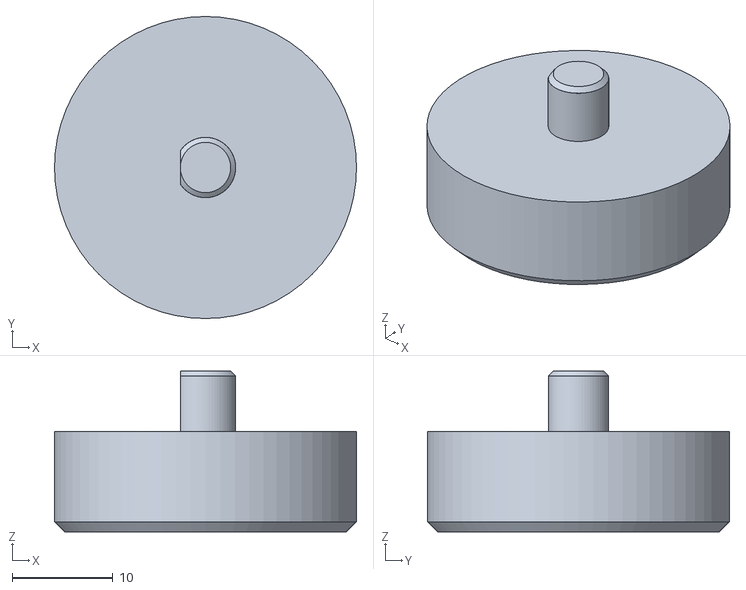
[picture p24: CAD file, 2026-10-28]
case/stl/roboter_ear.stl
30.0 x 30.0 x 16.0
