M4dm0nky/cyd-buddy/case/stl/roboter_hand.stl

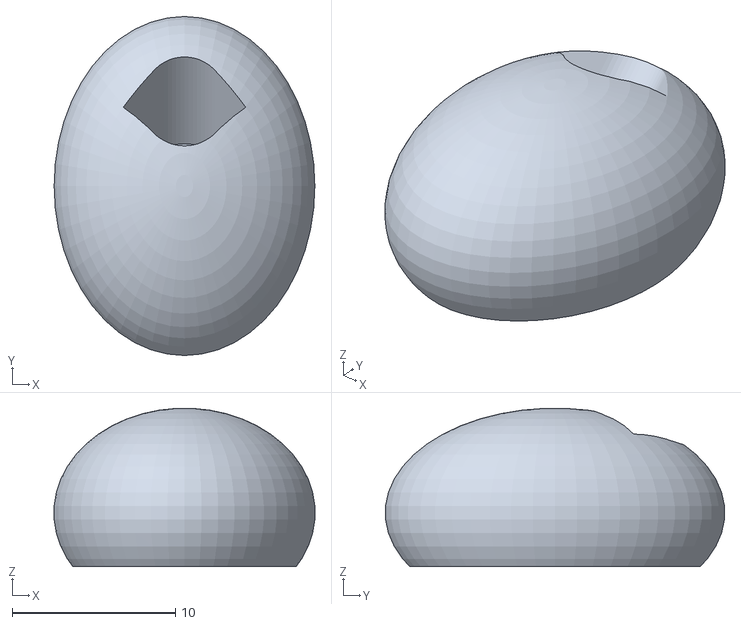
[picture p25: CAD file, 2026-10-28]
case/stl/roboter_hand.stl
16.0 x 20.8 x 9.69
