M4dm0nky/cyd-buddy/case/stl/roboter_foot.stl

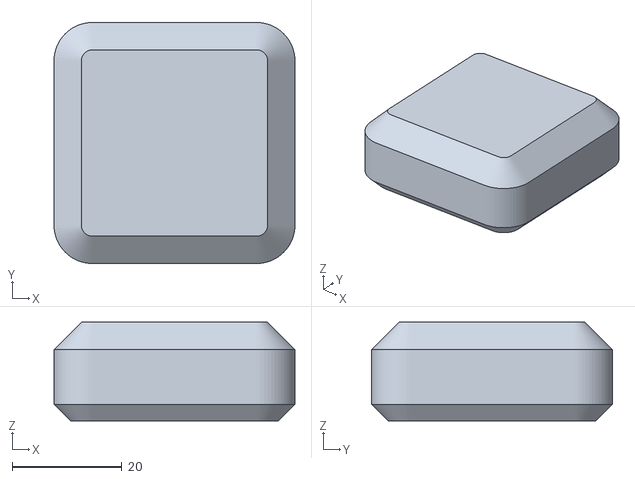
[picture p26: CAD file, 2026-10-28]
case/stl/roboter_foot.stl
44.0 x 44.0 x 18.0
