M4dm0nky/cyd-buddy/case/stl/roboter_neck.stl

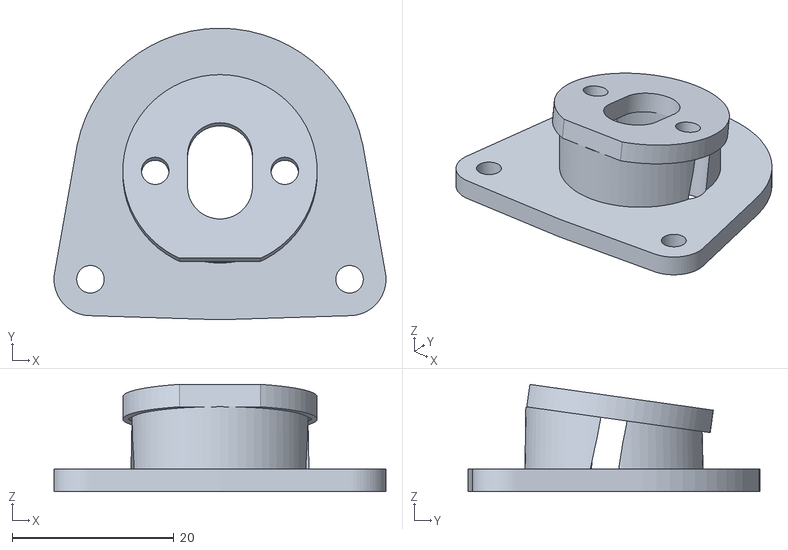
[picture p27: CAD file, 2026-10-28]
case/stl/roboter_neck.stl
41.0 x 36.0 x 13.2
