M4dm0nky/cyd-buddy/case/stl/roboter_head_back.stl

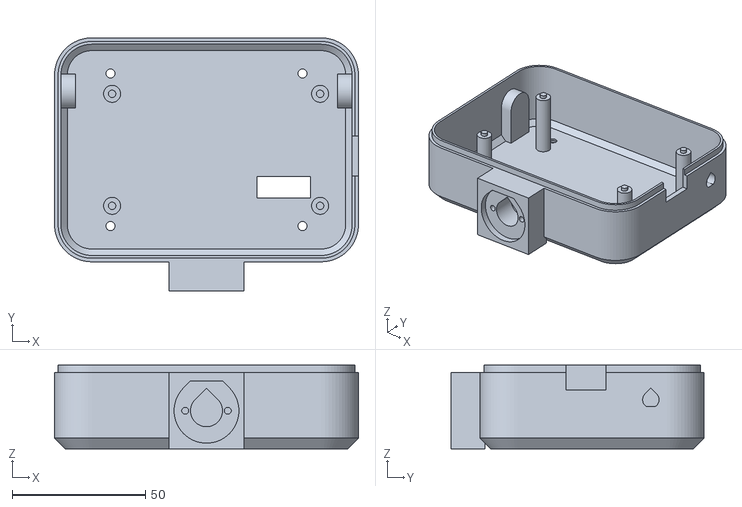
[picture p28: CAD file, 2026-10-28]
case/stl/roboter_head_back.stl
114.0 x 95.0 x 31.4
