M4dm0nky/cyd-buddy/case/stl/roboter_seat.stl

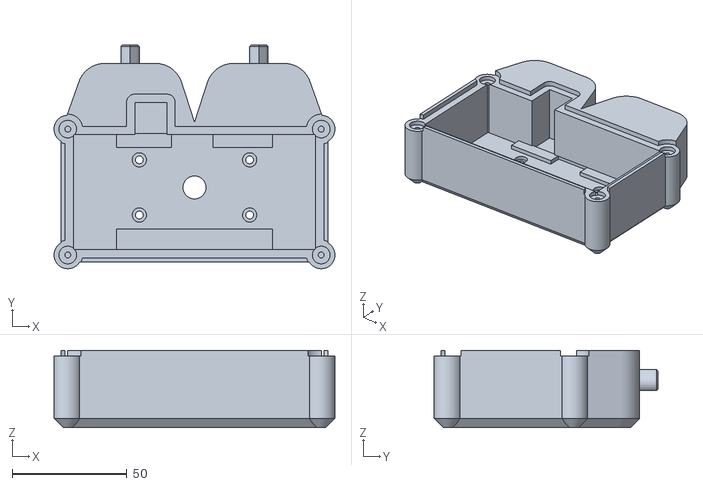
[picture p29: CAD file, 2026-10-28]
case/stl/roboter_seat.stl
122.3 x 97.3 x 33.6
