M4dm0nky/cyd-buddy/case/stl/roboter_bottom.stl

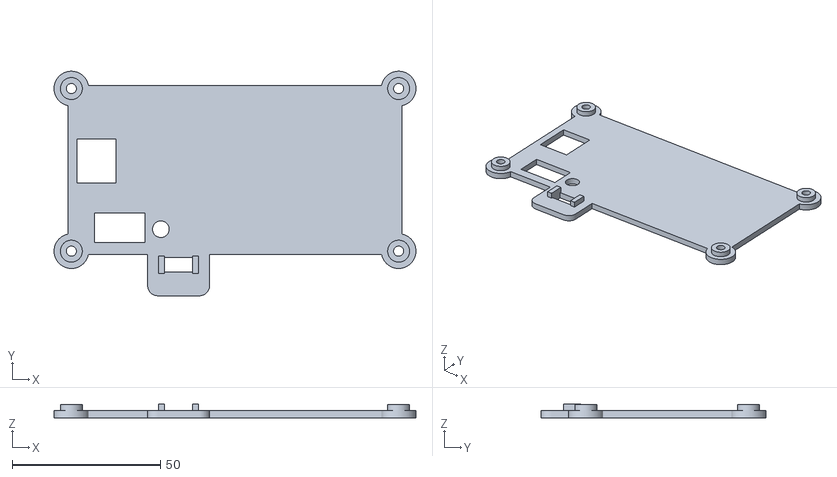
[picture p30: CAD file, 2026-10-28]
case/stl/roboter_bottom.stl
122.0 x 75.7 x 4.58
