M4dm0nky/cyd-buddy/case/stl/madbuddy_frame_test.stl

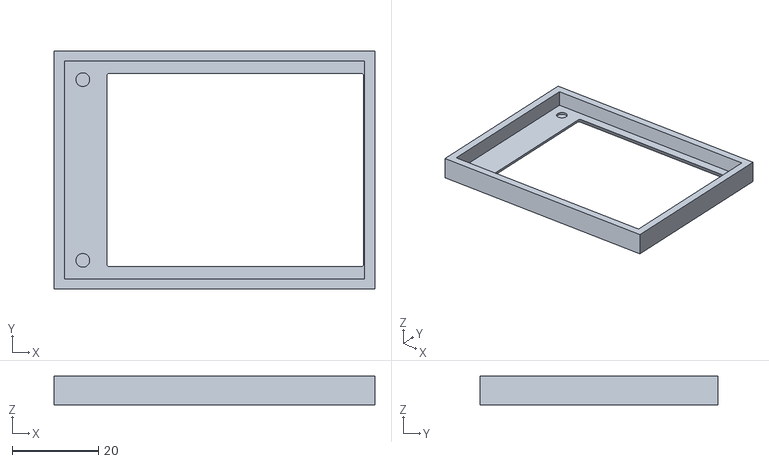
[picture p31: CAD file, 2026-10-27]
case/stl/madbuddy_frame_test.stl
74.6 x 55.4 x 6.70
