M4dm0nky/cyd-buddy/case/xiao_cam_common.scad

// MadBuddy: gemeinsame Kamera-/XIAO-Geometrie -- Kameratasche mit Riegel, XIAO-Wiege, Pruefkoerper
// Wird von den Gehaeuse-Dateien mit include <xiao_cam_common.scad> eingebunden (nach cyd_common.scad). OpenSCAD 2021.01.
// Alle Module arbeiten in EINEM lokalen System: Innenseite der Frontwand = Z 0, Blickrichtung (nach aussen) = +Z,
// Mitte der Linse = Ursprung (X/Y), Kamera-Horizontale (lange Bildseite) = X. Die einbindende Datei platziert/kippt das System.
// Die Aussenflaeche der Frontwand liegt bei Z = wall_t (jedes Modul nimmt wall_t, Vorgabe cam_wall_t).
// Erwartet aus der einbindenden Datei: nichts Pflichtiges. Optional darf sie VOR dem include cam_xiao_dx (X-Versatz des XIAO-Stapels) und cam_chamfer_ang (Fasenwinkel) setzen. Definiert hier (NICHT in der einbindenden Datei wiederholen, sonst WARNING):
//   cam_*, xiao_* (siehe unten).
// Quellen: .superpowers/sdd/2026-10-27-roboter-druckteile/kamera-recherche.md (Seeed-Zeichnungen), Spec docs/superpowers/specs/2026-10-27-kamera-halter-design.md

// ---------------------------------------------------------------- Auswahl
cam_type   = "OV3660";   // "OV3660" (laut Seeed-Bild im Lieferumfang) oder "OV5640"; Aufdruck am eigenen Teil pruefen
cam_wall_t = 2.0;        // Vorgabe fuer die Wandstaerke der Frontwand (die einbindende Datei uebergibt ihren Wert)

// ---------------------------------------------------------------- Kameramodul
cam_body     = cam_type == "OV3660" ? 8.0 : 8.5;   // QUELLE: Seeed-Zeichnung (OV3660 8,0 x 8,0; OV5640 8,5 x 8,5)
cam_depth    = cam_type == "OV3660" ? 5.3 : 5.5;   // QUELLE: Seeed-Zeichnung, Gesamttiefe inkl. Tubus (OV5640 ca., schlecht lesbar)
cam_tube_d   = 6.2;    // QUELLE: Seeed-Zeichnung OV3660 (Zeichnung, mittel); OV5640 VORLÄUFIG gleich
cam_tube_len = 2.7;    // VORLÄUFIG (Zeichnung 2,70, Zuordnung unsicher) Tubusueberstand ueber den Koerper -- mit Schieblehre nachmessen
cam_fpc_w    = 6.5;    // QUELLE: Seeed-Zeichnung OV3660 (OV5640 VORLÄUFIG gleich)
cam_fpc_len  = cam_type == "OV3660" ? 21.2 : 70.5; // QUELLE: Seeed-Zeichnung, ab Koerperkante bis Ende
cam_fpc_t    = 0.3;    // QUELLE: Seeed-Zeichnung (Zeichnung, mittel) FPC-Dicke
cam_fov_d    = cam_type == "OV3660" ? 102 : 69;    // QUELLE: Hersteller (diagonal, Grad)
cam_fov_h    = cam_type == "OV3660" ? 85 : 58;     // QUELLE: Hersteller OV3660 (horizontal); OV5640 VORLÄUFIG (aus 69 Grad diagonal, 4:3)
cam_bend_r   = 2.0;    // QUELLE: Recherche (FPC-Biegeradius mindestens 2 mm): rundet die Riegel-Aussparung, prueft den FPC-Weg
cam_dbg_nocradle = false; // nur Pruefhilfe (Gegenprobe): true = XIAO-Wiege entfaellt
cam_dbg_nogroove = false; // nur Pruefhilfe (Gegenprobe): true = Riegelnuten werden NICHT geschnitten

// ---------------------------------------------------------------- Tasche und Riegel
cam_play       = 0.25;  // Spiel je Seite um den Kamerakoerper (Vorgabe Spec: Koerper + 0,25 mm je Seite)
cam_hole_play  = 0.5;   // Linsenloch = Tubus + 0,5 (OV3660: 6,7) -- QUELLE: Recherche
cam_lens_rec   = 0.3;   // Linse endet 0,3 mm hinter der Aussenflaeche -- QUELLE: Spec
cam_chamfer    = 1.0;   // Fase aussen am Linsenloch: Aufweitung je Seite (Winkel siehe cam_cone_ang)
// Flankenwinkel der Fase zur Linsenachse: 45 Grad (Spec). Die einbindende Datei darf cam_chamfer_ang setzen; bisher setzt keine Datei es (Vorgabe 45 gilt fuer Stufe 2 und Roboter).
cam_cone_ang   = is_undef(cam_chamfer_ang) ? 45 : cam_chamfer_ang;
cam_cone_h     = cam_chamfer / tan(cam_cone_ang);   // Tiefe der Fase entlang der Achse
cam_frame_wall = 2.0;   // Wandstaerke des Rahmens um die Tasche (>= 2 mm)
cam_groove     = 1.0;   // Tiefe der seitlichen Riegelnuten ueber die Tasche hinaus
cam_clip_t     = 1.2;   // Dicke des Riegels (Ausnahme von der 2-mm-Regel) -- QUELLE: Spec
cam_clip_over  = 0.1;   // Uebermass (Klemmung): Nut ist um so viel niedriger als der Riegel -- QUELLE: Spec
cam_clip_fit   = 0.15;  // seitliches Spiel Riegel/Nut (= fit_peg der Roboter-Datei, als Presspassung)
cam_clip_press = 2.0;   // der Riegel liegt so weit (mm) auf dem Kamerakoerper auf (Quersteg)
cam_slot_extra = 0.7;   // FPC-Schlitz = FPC-Breite + 0,7 -- QUELLE: Spec

// ---------------------------------------------------------------- XIAO ESP32S3 Sense (Stapel) und Wiege
xiao_w       = 21.0;  // QUELLE: Seeed-Wiki (Platine, lange Seite) -- wird in X gelegt
xiao_l       = 17.8;  // QUELLE: Seeed-Wiki (Händler teils 17,5)
xiao_stack   = 15.0;  // VORLÄUFIG (Seeed-Wiki "mit Erweiterung", Kamera-Anteil unklar) Stapelhoehe -- nachmessen
xiao_pcb_t   = 1.2;   // VORLÄUFIG (typisch 1,0 bis 1,2) Platinendicke -- nachmessen
xiao_conn_in = 2.0;   // VORLÄUFIG (Schaetzung) Mitte des Kamerasteckers ab dem Platinenende, Ende gegenueber der USB-Buchse
xiao_conn_h  = 1.4;   // VORLÄUFIG (Schaetzung) Steckerhoehe ueber der Sense-Platine; die FPC-Ebene liegt in halber Hoehe
xiao_conn_w  = 12.5;  // QUELLE: Seeed-Zeichnung (Versteifung/Steckerbreite am FPC-Ende)
xiao_play    = 0.3;   // Spiel um den Stapel (= fit)
xiao_gap     = 0.2;   // Luft zwischen Rahmenunterseite und Stapelvorderseite
xiao_post_t  = 2.4;   // Dicke der Anschlag-Pfosten in X (>= 2 mm)
xiao_post_trim = 0.6; // Pfosten enden so weit vor der Stapelkante in Y (Kopfwand der Stirnwoelbung)
xiao_steg_t  = 1.6;   // Dicke des Klemmstegs hinter dem Stapel
xiao_lip     = 1.0;   // Lippe des Klemmstegs ueber der Stapelrueckseite (45 Grad Einfuehrschraege); Pfosten federn beim Einlegen um diesen Betrag minus Spiel
xiao_lip_gap = 0.1;   // Luft zwischen Stapelrueckseite und Lippe
xiao_fpc_end = 0.5;   // gerades Stueck des FPC vor dem Stecker (Biegeweg endet dort)
// Lage des Stapelmittelpunkts relativ zur Linse (X, Y): das Ende mit dem Kamerastecker zeigt nach +X zur Kamera.
// Der Stapel liegt parallel zur Frontwand hinter dem Kamera-Rahmen (Z-Abstand wegen der Rahmentiefe), nach +X versetzt.
// Die einbindende Datei darf den X-Versatz ueber cam_xiao_dx setzen (Roboter: Werkzeugkanal der Kopfschrauben); ohne Angabe gilt 7,0 (Stufe 2).
xiao_offset  = [is_undef(cam_xiao_dx) ? 7.0 : cam_xiao_dx, 0.0]; // VORLÄUFIG (Entwurf): Stecker <= 16 mm Luftlinie von der Koerperkante UND FPC-Bogenradius >= cam_bend_r (je weiter nach +X, desto sanfter; Grenze: Kopfwand der Stirn)
cam_fpc_air_max = 16.0;    // QUELLE: Spec (21,2 mm FPC, lockere Schleife) max. Luftlinie Koerperkante -> Stecker

// ================================================================= abgeleitete Werte
cam_half    = cam_body / 2 + cam_play;           // halbe Taschenweite
cam_outer_h = cam_half + cam_groove + cam_frame_wall; // halbe Rahmenweite
cam_hole_d  = cam_tube_d + cam_hole_play;        // Linsenloch
cam_tan_h   = tan(cam_fov_h / 2);
cam_tan_v   = sqrt(tan(cam_fov_d / 2) * tan(cam_fov_d / 2) - cam_tan_h * cam_tan_h);   // aus diagonal + horizontal
// Z-Lagen (lokal, Frontwand-Innenseite = 0, Aussenflaeche = w)
function cam_zbf(w = cam_wall_t) = min(0, w - cam_lens_rec - cam_tube_len);           // Vorderseite Kamerakoerper (Anschlag)
function cam_ztip(w = cam_wall_t) = cam_zbf(w) + cam_tube_len;                        // Linsenspitze
function cam_zbb(w = cam_wall_t) = cam_zbf(w) - (cam_depth - cam_tube_len);           // Rueckseite Kamerakoerper = FPC-Ebene
function cam_zg1(w = cam_wall_t) = cam_zbb(w) - (cam_clip_t - cam_clip_over);        // Nutboden (Oberseite der hinteren Lippe)
function cam_zrear(w = cam_wall_t) = cam_zg1(w) - cam_frame_wall;                     // Rahmen-Rueckseite
function xiao_z0(w = cam_wall_t) = cam_zrear(w) - xiao_gap;                           // Stapelvorderseite (Oberkante Stecker)
function xiao_zbot(w = cam_wall_t) = xiao_z0(w) - xiao_stack;                         // Stapelrueckseite
// Kamerastecker auf der Sense-Platine (FPC-Ebene) und Luftlinie ab der Koerperkante
function xiao_conn_pt(w = cam_wall_t) = [xiao_offset[0] + xiao_w / 2 - xiao_conn_in, xiao_offset[1], xiao_z0(w) - xiao_conn_h / 2];
function cam_fpc_x1() = cam_outer_h + 0.5;                                              // Beginn des Bogens (ausserhalb des Rahmens)
function cam_fpc_run(w = cam_wall_t) = xiao_conn_pt(w)[0] - xiao_fpc_end - cam_fpc_x1();  // waagerechte Laenge des Bogens
// Kosinus-S-Bogen z = dz (1 - cos(pi x / L)) / 2: groesste Kruemmung an den Enden = dz pi^2 / (2 L^2), Radius = Kehrwert
function cam_fpc_rmin(w = cam_wall_t) = 2 * pow(cam_fpc_run(w), 2) / ((cam_zbb(w) - xiao_conn_pt(w)[2]) * pow(3.14159265, 2));
function cam_fpc_air(w = cam_wall_t) = norm(xiao_conn_pt(w) - [cam_body / 2, 0, cam_zbb(w)]);

// ================================================================= Tasche (positiv + negativ)
module cam_pocket_add(wall_t = cam_wall_t) {
  // Rahmen um die Tasche: von der Wand (0,5 mm in die Wand hinein) bis zur Rahmen-Rueckseite
  zr = cam_zrear(wall_t);
  translate([-cam_outer_h, -cam_outer_h, zr]) cube([2 * cam_outer_h, 2 * cam_outer_h, 0.5 - zr]);
}

module cam_pocket_cut(wall_t = cam_wall_t) {
  zbf = cam_zbf(wall_t); zbb = cam_zbb(wall_t); zg1 = cam_zg1(wall_t); zr = cam_zrear(wall_t);
  gh = cam_half + cam_groove;
  sw = cam_fpc_w + cam_slot_extra;
  // Linsenloch durch Anschlagplatte und Wand, aussen 45 Grad gefast
  translate([0, 0, zbf - 0.01]) cylinder(d = cam_hole_d, h = wall_t - cam_cone_h - zbf + 0.02);
  translate([0, 0, wall_t - cam_cone_h]) cylinder(d1 = cam_hole_d, d2 = cam_hole_d + 2 * cam_chamfer, h = cam_cone_h + 0.01);
  translate([0, 0, wall_t]) cylinder(d = cam_hole_d + 2 * cam_chamfer, h = 1);
  // Koerpertasche: von der Anschlagflaeche nach hinten offen (Kamera wird von hinten eingesetzt)
  translate([-cam_half, -cam_half, zr - 1]) cube([2 * cam_half, 2 * cam_half, zbf - zr + 1]);
  // Riegelnuten: hinter dem Koerper, U-foermig, nach +X offen (Riegel wird von der FPC-Seite eingeschoben)
  if (!cam_dbg_nogroove) {   // cam_dbg_nogroove nur fuer die Gegenprobe der Riegel-Pruefung
    translate([-gh, -gh, zg1]) cube([2 * gh, 2 * gh, zbb - zg1]);
    translate([0, -gh, zg1]) cube([cam_outer_h + 1, 2 * gh, zbb - zg1]);
  }
  // FPC-Schlitz in der +X-Wand
  translate([0, -sw / 2, zg1]) cube([cam_outer_h + 1, sw, zbb + 0.5 - zg1]);
}

// ================================================================= Riegel (eigenes Druckteil, liegt flach: Z 0 ... cam_clip_t)
module cam_clip() {
  gh = cam_half + cam_groove - cam_clip_fit;      // halbe Riegelbreite (in der Nut)
  sw = cam_fpc_w + cam_slot_extra;
  x0 = -gh;                                       // Quersteg hinten (-X)
  x1 = -(cam_body / 2 - cam_clip_press);          // Steg liegt cam_clip_press mm auf dem Koerper auf
  xe = cam_outer_h - 0.75;                        // Armenden (greifbar, innerhalb des Rahmens)
  // Platte mit FPC-Aussparung nach +X; die inneren Ecken der Aussparung sind mit cam_bend_r gerundet (FPC-Biegeradius >= 2 mm)
  linear_extrude(cam_clip_t) difference() {
    translate([x0, -gh]) square([xe - x0, 2 * gh]);
    offset(r = cam_bend_r) offset(delta = -cam_bend_r) translate([x1, -sw / 2]) square([xe - x1 + 1, sw]);
  }
}
module cam_clip_place(wall_t = cam_wall_t) {    // Riegel in Einbaulage (direkt hinter der Koerperrueckseite)
  translate([0, 0, cam_zbb(wall_t) - cam_clip_t]) cam_clip();
}

// ================================================================= XIAO-Wiege (positiv + negativ)
// Je zwei schmale Pfosten an beiden Stirnenden (USB-Ende und Kameraende) von der Frontwand bis zur Stapelrueckseite.
// Die Laengsseiten und die Mitte am Kamerastecker (xiao_conn_w) bleiben frei: dort sitzen die angeloeteten Draehte und der FPC.
// Druck ohne Stuetzen: senkrechte Pfosten, dazu je ein Klemmsteg hinter dem Stapel mit 45-Grad-Lippe (xiao_lip, Schnappmass je Seite). Der Stapel wird von hinten
// eingeschoben (Frontteil liegt mit der Aussenseite unten, Einlegen von oben): die Pfosten federn nach aussen, die Lippen rasten ueber der Stapelrueckseite ein und halten ihn
// nach hinten. Zusaetzlich begrenzen in Stufe 2 die Anschlagpfosten der Rueckwand (0,1 mm unter der Stapelrueckseite) das Spiel; im Roboter schliesst torso_back mit Steg und Stuetzwand.
module xiao_cradle_add(wall_t = cam_wall_t) {
  zb = xiao_zbot(wall_t);
  bx = xiao_offset[0]; by = xiao_offset[1];
  gap_h = xiao_conn_w / 2 + 0.15;                           // freie Mitte
  yo = xiao_l / 2 - xiao_post_trim;                         // Pfosten enden kurz vor der Stapelkante (nicht weiter, sonst Kopfwand)
  yb = xiao_l / 2;                                          // Steg ueberspannt die ganze Stapelbreite
  if (!cam_dbg_nocradle) for (ex = [-1, 1]) {   // cam_dbg_nocradle nur fuer die Gegenprobe der Wiege-Pruefung
    xin = ex > 0 ? bx + xiao_w / 2 + xiao_play : bx - xiao_w / 2 - xiao_play;   // Innenflaeche des Stirnanschlags
    xp = ex > 0 ? xin : xin - xiao_post_t;
    for (sy = [-1, 1])
      translate([xp, sy > 0 ? by + gap_h : by - yo, zb - xiao_lip_gap]) cube([xiao_post_t, yo - gap_h, 0.5 - zb + xiao_lip_gap]);
    // Klemmsteg: liegt hinter dem Stapel, verbindet die beiden Pfosten (Bruecke yb*2 - 2*..., hier <= 15 mm) und greift mit einer
    // 45-Grad-Lippe xiao_lip ueber die Stapelrueckseite. Die Pfosten federn beim Einlegen nach aussen (Einlegen von hinten, Auflage an der Lippe).
    translate([xp, by - yo, zb - xiao_steg_t - xiao_lip_gap]) cube([xiao_post_t, 2 * yo, xiao_steg_t]);
    translate([0, by - yo, 0]) rotate([90, 0, 0]) mirror([0, 0, 1])
      linear_extrude(2 * yo)
        polygon(ex > 0 ? [[xin + 0.01, zb - xiao_lip_gap], [xin - xiao_lip, zb - xiao_lip_gap],
                          [xin + 0.01, zb - xiao_lip_gap - xiao_lip]]
                       : [[xin - 0.01, zb - xiao_lip_gap], [xin + xiao_lip, zb - xiao_lip_gap],
                          [xin - 0.01, zb - xiao_lip_gap - xiao_lip]]);
  }
}
module xiao_cradle_cut(wall_t = cam_wall_t) {               // Stapelraum + Spiel (haelt Rahmen/Wand frei)
  translate([xiao_offset[0] - xiao_w / 2 - xiao_play, xiao_offset[1] - xiao_l / 2 - xiao_play, xiao_zbot(wall_t)])
    cube([xiao_w + 2 * xiao_play, xiao_l + 2 * xiao_play, xiao_stack]);
}

// ================================================================= Pruefkoerper
module cam_seg(p, q) {                                       // dünnes Band zwischen zwei Punkten (FPC)
  hull() for (r = [p, q]) translate([r[0], r[1] - cam_fpc_w / 2, r[2] - cam_fpc_t]) cube([0.01, cam_fpc_w, cam_fpc_t]);
}
module cam_dummy(wall_t = cam_wall_t) {                     // Koerper, Tubus, FPC-Band bis zum Stecker
  zbf = cam_zbf(wall_t); zbb = cam_zbb(wall_t);
  c = xiao_conn_pt(wall_t);
  translate([-cam_body / 2, -cam_body / 2, zbb]) cube([cam_body, cam_body, zbf - zbb]);
  translate([0, 0, zbf - 0.01]) cylinder(d = cam_tube_d, h = cam_tube_len + 0.01);
  // FPC-Weg: gerade aus der Tasche, dann sanfter S-Bogen (Kosinus-Profil) auf die Steckerebene, dann gerade in den Stecker.
  // Der Mindest-Biegeradius des Bogens muss >= cam_bend_r sein (assert).
  assert(cam_fpc_rmin(wall_t) >= cam_bend_r, str("FPC-Biegeradius zu klein: ", cam_fpc_rmin(wall_t), " < ", cam_bend_r));
  n = 16; x1 = cam_fpc_x1(); L = cam_fpc_run(wall_t); dz = cam_zbb(wall_t) - c[2];
  cam_seg([0, 0, zbb], [x1, 0, zbb]);
  for (i = [0 : n - 1]) {
    t0 = i / n; t1 = (i + 1) / n;
    cam_seg([x1 + L * t0, c[1] * (1 - cos(180 * t0)) / 2, zbb - dz * (1 - cos(180 * t0)) / 2],
            [x1 + L * t1, c[1] * (1 - cos(180 * t1)) / 2, zbb - dz * (1 - cos(180 * t1)) / 2]);
  }
  cam_seg([x1 + L, c[1], c[2]], c);
}
module xiao_stack_dummy(wall_t = cam_wall_t) {
  translate([xiao_offset[0] - xiao_w / 2, xiao_offset[1] - xiao_l / 2, xiao_zbot(wall_t)])
    cube([xiao_w, xiao_l, xiao_stack]);
}
module cam_fov_cone(L = 30, wall_t = cam_wall_t) {          // Sichtpyramide ab der Linsenspitze (102 Grad diagonal / 85 Grad horizontal)
  zt = cam_ztip(wall_t);
  hull() {
    translate([0, 0, zt - 0.01]) cylinder(d = cam_tube_d, h = 0.01);
    translate([-(cam_tube_d / 2 + L * cam_tan_h), -(cam_tube_d / 2 + L * cam_tan_v), zt + L])
      cube([2 * (cam_tube_d / 2 + L * cam_tan_h), 2 * (cam_tube_d / 2 + L * cam_tan_v), 0.01]);
  }
}
