M4dm0nky/cyd-buddy/case/render/roboter_assembly.png

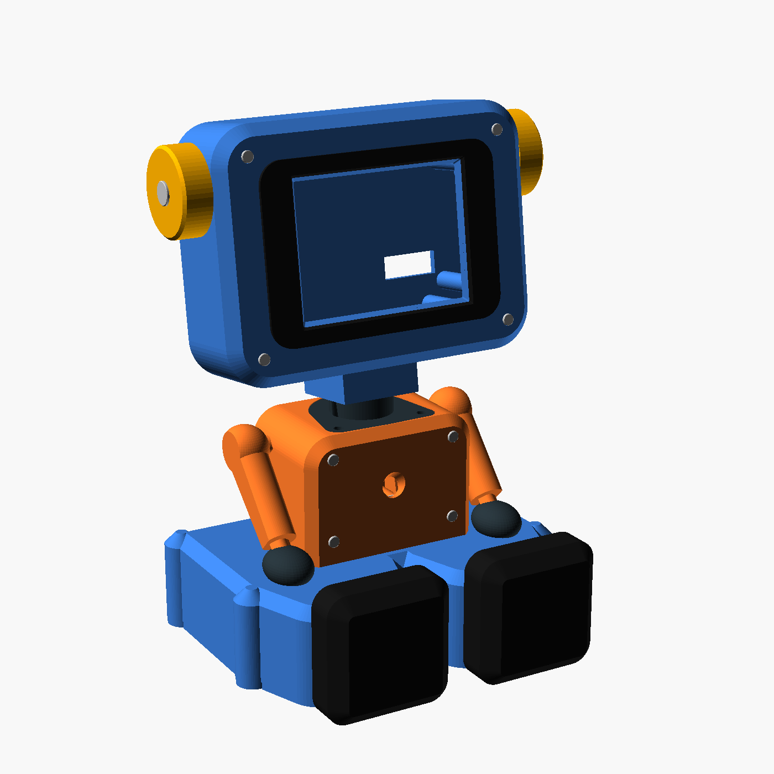
case/render/roboter_assembly.png
