M4dm0nky/cyd-buddy/(commit log)

2026-10-25 chore: Gerüst, Spec, Plan und Cloud-Anleitung für den CYD-Buddy
    PlatformIO (pioarduino 55.03.312-1, LovyanGFX 1.2.34) mit Testbild,
    Smoke-Test, OTA-Vorlagen aus dem HA-Buddy unter reference/.
    Build: Flash 494 783 B (25,2 %), native: 3/3 Tests.
2026-10-25 chore: Task 0 Werkzeuge in der Cloud eingerichtet
    Claude-Session: https://claude.ai/code/session_01PDBXtgBUtWJE5YwdVzTjwP
2026-10-25 feat: Task 4 Wetter-Laune und Overlays mit Tests
    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
2026-10-25 feat: Task 6 OTA-Regeln für ESP32 portiert, mit Tests
    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
2026-10-25 feat: Task 7 LED, Lichtsensor, NVS-Speicher
    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
2026-10-25 feat: Task 9 WLAN-Portal, NTP, Ort und Wetter
    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
2026-10-25 feat: Task 11 Spiele Fang mich und Simon
    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
2026-10-25 docs: Task 14 OTA-Doku und README
    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
2026-10-25 fix: Wetter und Geocoding mit HTTP/1.0 holen (Open-Meteo antwortet sonst chunked)
    getStream() liefert bei chunked die Chunk-Längen mit, ArduinoJson las
    nur die erste Zahl (Fehler Ok, aber kein current). Am Gerät gesehen:
    'net: Wetter-JSON unbrauchbar (Ok)'.
    [net.cpp]
2026-10-25 feat: manuelles Update in den Einstellungen startet die Update-Karte direkt
    Tipp auf 'Firmware' sucht sofort (hebt 'Später' auf); liegt ein Update
    bereit, erscheint die Karte gleich in den Einstellungen statt erst bei
    den Augen.
2026-10-25 fix: Touch-Kalibrierung am Gerät gemessen (x gespiegelt, unterer Rand verworfen)
    Bildschirm-x kommt aus Roh-y und war gespiegelt (oben links meldete
    x=316); Roh-y-Bereich umgedreht. Unten lag Roh-x unter 200 und wurde
    verworfen; X_MIN 0. Touch-Beginn und verworfene Rohpunkte gehen seriell
    aus, für die Kontrolle.
    [app.cpp, config.h]
2026-10-25 fix: Tipp nutzt die letzte gültige Touch-Position statt (0,0) beim Loslassen
    Ein Tipp wird beim Loslassen gemeldet; getTouch liefert dann keine
    Position mehr. Menü-Kacheln trafen nichts, 'Ja' auf der Update-Karte
    zählte als 'daneben' (= Später), Fang mich ebenso.
    [app.cpp]
2026-10-25 feat: Touch-Kalibrierung mit vier Eckpunkten beim ersten Start, im NVS gespeichert
    Die Eck-Messung ohne gezeichnete Ziele war unzuverlässig (Achsen
    vertauscht angenommen). LovyanGFX calibrateTouch ermittelt die Zuordnung
    selbst; Finger beim Einschalten = neu kalibrieren. Gesten gehen mit
    Position und Bildschirm seriell aus (Diagnose).
2026-10-25 docs: Stand nach WLAN, Wetter, Touch-Kalibrierung und erstem OTA am Gerät
2026-10-25 chore: Touch-Diagnose-Ausgaben hinter Build-Flag CYD_DIAG_TOUCH
    Die Ausgaben waren zum Einmessen der Touch-Kalibrierung eingebaut und
    sind jetzt standardmäßig aus; bei Bedarf per -DCYD_DIAG_TOUCH=1.
2026-10-25 docs: Spec, Plan und Mockup für das Gesicht mit 22 Ausdrücken
2026-10-25 feat: Auslöser und Eigenarten für neue Ausdrücke
2026-10-25 feat: Gesicht mit Brauen, Pupillen, Nase und Mund zeichnen
2026-10-25 fix: Sonnenbrille mittig auf die Augen statt zu hoch
2026-10-25 docs: Spec, Plan und Cloud-Anleitung für Interaktion F1-F4
2026-10-25 chore: Interaktion Task 0 Werkzeuge und Branch
    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
2026-10-25 feat: Interaktion Task 1 Blick folgt und High-Five (Logik)
    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
2026-10-25 feat: Interaktion Task 2 Blick folgt und High-Five (UI)
    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
2026-10-25 feat: Interaktion Task 5 Sprechblasen und Rückblick (UI)
    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
2026-10-25 feat: Interaktion Task 7 Füttern und Hatschi verdrahtet (Zwischenstand)
    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
2026-10-25 feat: Interaktion Task 7 Füttern und Charakter (UI)
    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
2026-10-25 feat: Interaktion Task 9 Timer-Bildschirm (Zwischenstand)
    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
2026-10-25 feat: Interaktion Task 9 Ring und Restzeit (Zwischenstand)
    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
2026-10-25 docs: Spec und Plan für den Claude-Modus
2026-10-25 fix: Firmware-Statuszeile nur mit Latin-1-Zeichen (... und - statt … und –)
    [ota_policy.h]
2026-10-25 feat: Claude-Modus HTTP-Empfaenger
    WebServer Port 80 + mDNS cyd-buddy, Schluessel im NVS (ckey), POST /claude und
    GET /claude/ping, Info-Zeile und serielle Ausgabe.
2026-10-25 docs: Plan für die Review-Fixes (Pakete A Logik, B Netz/OTA, C App/UI)
2026-10-25 fix: Nickerchen lässt sich durch Berührung beenden; Nacht einheitlich 22-7 Uhr
    mood_tick schaltete das Nickerchen bei Energie < 10 jedes Bild wieder ein,
    eine Berührung weckte nur für ein Bild. Jetzt nur bei der Flanke unter 10
    oder 10 min nach der letzten Berührung. mood_is_night() für Nachtschlaf und
    SLEEPY (SLEEPY bisher 22-6).
2026-10-25 fix: OTA-Umleitungsprüfung lehnt userinfo (@) ab, Port nur aus Ziffern
    https://github.com:@evil.com/ galt als github.com; HTTPClient hätte evil.com
    angesprochen.
    [ota_policy.h]
2026-10-25 fix: Claude-Modus: späte Ereignisse überschreiben Fertig und Ich-brauche-dich nicht mehr
2026-10-25 fix: Claude-Empfänger prüft Schlüssel und Länge vor dem Lesen des Körpers; Handler nur einmal
    Eigener RequestHandler (canRaw/raw): bei falschem Schlüssel oder > 256 B
    401/413 und Verbindung zu, ohne den Körper in den Heap zu lesen. Multipart-
    Grenzen per Build-Flag klein. Handler/collectHeaders nur beim ersten Start.
    [claude_api.cpp]
2026-10-25 fix: Rollback wirksam, Gesundheitsnachweis unabhängig vom WLAN, Stall-Prüfung, Start-Absicherung
    verifyRollbackLater()=true (der Core bestätigte jedes Image sofort);
    ota_pull::health_tick() aus der Hauptschleife. Download bricht auch ab,
    wenn available()>0 aber read()<=0 bleibt. Kalibrierung: 10-s-Grenze beim
    Warten, Plausibilitätsprüfung. Kommentare/Doku auf gemessenen Stand.
    [light.cpp, main.cpp, ota_pull.cpp, ota_pull.h]
2026-10-25 fix: Ablaufzeiten ohne 24,8-Tage-Fehler (Deadline mit Test)
    [app.cpp]
2026-10-25 fix: Animationen rechnen die Zeit erst ganzzahlig auf die Periode; ungenutztes kEyeY entfernt
2026-10-25 fix: App/UI: Stups als Tipp ausserhalb der Augen, Rueckblick ignoriert erste Sekunde, Sprite-Neuversuch, OTA-Karte nicht waehrend Arbeit, Speichern vor OTA-Neustart im Hauptthread, Aufraeumen (testsc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
    [app.cpp, ota_pull.cpp, ota_pull.h]
2026-10-25 docs: ota.md – Speichern vor dem Neustart läuft im Haupt-Task (kein on_restart mehr)
2026-10-25 fix: 24,8-Tage-Fehler in Logik-Zeitpunkten (Gefühle, Blick, Eigenarten, Niesen, Gedanken, Update-Schlummern)
    [ota_policy.h, ota_pull.cpp, ota_pull.h]
2026-10-25 docs: Fortschritt Lokal 4 – Code-Review und Fixes mit Gerätemessungen
2026-10-26 feat: Gehäuse 'Kopf mit Stirn' für CYD + XIAO ESP32S3 Sense (OpenSCAD, parametrisch, mit Prüfskript)
    [madbuddy_back.stl, madbuddy_case.scad, madbuddy_frame_test.stl, madbuddy_front.stl]
2026-10-26 docs: Kamera und Gehäuse – Spec, README, Fortschritt, Gehäuse-README
2026-10-26 docs: Spec Kamera-Firmware (XIAO-Erkennung, UART-Protokoll, Anwesenheit, Updates)
2026-10-26 docs: Gehäuse-Variante 2 'Roboter' mit Akku – Spec, Konzeptmodell, Bilder
    [roboter_konzept.scad]
2026-10-26 fix(gehaeuse): Display-Fenster nach Messung (AA 59 mm, 10 mm ab linker Platinenkante)
    Testdruck: Lochbild passt, Fenster lag falsch. Die Zeichnungs-AA (57,6 mittig im Glas)
    stimmt nicht. Neu: bespielte Flaeche gemessen 58,8 mm ab 10 mm, Fenster 59,6 x 44,9.
    Platine verschiebt sich hinter dem Gesicht, Kopf wird 99,6 statt ca. 114 mm breit.
    Hoehe 44,3 vorlaeufig (aus Breite hochgerechnet).
    [madbuddy_back.stl, madbuddy_case.scad, madbuddy_frame_test.stl, madbuddy_front.stl]
2026-10-27 fix(gehaeuse): Display im Gehaeuse 1 mm nach links (disp_x)
    Neuer Parameter disp_x verschiebt Platine, Glas, Fenster und Sichtkegel
    gegen die feste Aussenform. Gehaeusemass bleibt unveraendert (99,6 mm).
    STL und Renders neu erzeugt, check.ps1 alles gruen.
    [madbuddy_back.stl, madbuddy_case.scad, madbuddy_frame_test.stl, madbuddy_front.stl]
2026-10-27 docs: README neu – drei Ausbaustufen, Materiallisten mit Preisen, Aufbau je Stufe
    Stufe 1 Pur (CYD am USB), Stufe 2 Desktop-Kopf mit Kamera, Stufe 3 Roboter
    mit Akku (Konzept). Bedienung, Claude-Modus, Update und Entwicklung gestrafft.
2026-10-27 docs: Spec und Plan Roboter-Druckteile (steckbar, mehrfarbig)
2026-10-27 refactor(gehaeuse): CYD-Maße in cyd_common.scad (Stufe 2 unverändert)
    Platine, Display, Fenster, Rückseite, Buchsen, Taster, SD und die zugehörigen
    Prüfkörper liegen jetzt in case/cyd_common.scad. Fingerprint-Werkzeug
    case/tools/stl_fingerprint.ps1 belegt: Eckpunkte von front/back/frame_test
    sind vorher und nachher identisch.
    [cyd_common.scad, madbuddy_back.stl, madbuddy_case.scad, madbuddy_frame_test.stl, madbuddy_front.stl]
2026-10-27 feat(roboter): Kopf (Front, Blende, Rückwand, Ohren) + Prüfskript
    [madbuddy_roboter.scad, roboter_bezel.stl, roboter_deco.stl, roboter_ear.stl, roboter_head_back.stl, roboter_head_front.stl]
2026-10-27 fix(roboter): Halskernloecher im Material, Wandstaerken Ohrsteg/Halssockel, Pruefskript, Umbenennungen, Spec
    [madbuddy_roboter.scad, roboter_bezel.stl, roboter_deco.stl, roboter_ear.stl, roboter_head_back.stl, roboter_head_front.stl]
2026-10-27 feat(roboter): Oberkörper, Hals, Arme, Hände
    [madbuddy_roboter.scad, roboter_arm.stl, roboter_bezel.stl, roboter_deco.stl, roboter_ear.stl, roboter_hand.stl, roboter_head_back.stl, roboter_head_front.stl]
2026-10-27 fix(roboter): Halsflansch-Wand, Montagefolge mit Werkzeugnachweis, Selbsttests, Herkunftskommentare, Wandbilanz
    [madbuddy_roboter.scad, roboter_arm.stl, roboter_bezel.stl, roboter_deco.stl, roboter_ear.stl, roboter_hand.stl, roboter_head_back.stl, roboter_head_front.stl]
2026-10-27 feat(roboter): Po/Beine mit Akkufach, Boden, Füße, Standsicherheit
    [madbuddy_roboter.scad, roboter_arm.stl, roboter_bezel.stl, roboter_bottom.stl, roboter_deco.stl, roboter_ear.stl, roboter_foot.stl, roboter_hand.stl]
2026-10-27 docs: Spec und Plan Kamera-Halter (Tasche, Riegel, XIAO-Wiege) und Verkabelung
2026-10-27 fix(roboter): 2 mm Luft ueber den Zellen (leg_h 33,6), Bodenoeffnungen mit Zugabe, Domabstand, Sitzschrauben M3x10
    [madbuddy_roboter.scad, roboter_arm.stl, roboter_bezel.stl, roboter_bottom.stl, roboter_deco.stl, roboter_ear.stl, roboter_foot.stl, roboter_hand.stl]
2026-10-27 wip(roboter): Fix-Runde 2 Task 4 unvollstaendig (API-Limit), ungeprueft
    Punkte: t_seat_pilot 8,0 + Reserve-assert, ear_r >= 5,9, wire_dummy ableiten.
    check_roboter.ps1 noch nicht gelaufen.
    [madbuddy_roboter.scad, roboter_arm.stl, roboter_bezel.stl, roboter_bottom.stl, roboter_deco.stl, roboter_ear.stl, roboter_foot.stl, roboter_hand.stl]
2026-10-28 chore: STL/3MF/PNG nicht als Text diffen
2026-10-28 fix(roboter): Fix-Runde 2 geprueft (check_roboter gruen), STL/Renders neu erzeugt
    [roboter_arm.stl, roboter_bezel.stl, roboter_bottom.stl, roboter_deco.stl, roboter_ear.stl, roboter_foot.stl, roboter_hand.stl, roboter_head_back.stl]
2026-10-28 feat(roboter): 3MF (Einzelteile + AMS), Doku
    [madbuddy_roboter.scad, roboter_ams.3mf, roboter_arm_l.stl, roboter_bezel_inlay.stl, roboter_head_front_ams.stl, roboter_screws_inlay.stl, roboter_teile.3mf]
2026-10-28 feat(gehaeuse): Kamera-Tasche mit Riegel + XIAO-Wiege (Stufe 2), Linsenloch 6,7
    [madbuddy_back.stl, madbuddy_cam_clip.stl, madbuddy_case.scad, madbuddy_front.stl, xiao_cam_common.scad]
2026-10-28 fix(gehaeuse): Kamera-Halter: FPC-Biegeradius, Klemmsteg der XIAO-Wiege, Pruefungen mit Obergrenze und Kontrollen, Kabelweg
    [madbuddy_back.stl, madbuddy_cam_clip.stl, madbuddy_case.scad, madbuddy_front.stl, xiao_cam_common.scad]
2026-10-28 feat(roboter): Kamera-Tasche mit Riegel + XIAO-Wiege in der Brust
    [madbuddy_roboter.scad, roboter_ams.3mf, roboter_cam_clip.stl, roboter_teile.3mf, roboter_torso_back.stl, roboter_torso_front.stl, xiao_cam_common.scad]
2026-10-28 fix(roboter): Kamera-Halter Fix-Runde: Stuetzwand und Pfostenwurzeln, Fase 28 Grad, Ueberhang- und Montagewege-Pruefungen, Sichtkegel 26 mm dokumentiert
    [madbuddy_roboter.scad, roboter_ams.3mf, roboter_teile.3mf, roboter_torso_back.stl, roboter_torso_front.stl, xiao_cam_common.scad]
2026-10-28 fix(roboter): Linsenloch-Fase wieder 45 Grad, Ueberhang-Ausnahme nur fuer die Fase, check_roboter.ps1 -Only
    [madbuddy_roboter.scad, roboter_ams.3mf, roboter_teile.3mf, roboter_torso_front.stl, xiao_cam_common.scad]
2026-10-28 docs: Verkabelung CYD↔XIAO mit Grafik
2026-10-28 docs: Verkabelung nach Steckerposition, Diode nur im XIAO-Zweig
2026-10-28 docs: Verkabelung – Roboter-Hinweis bei Schritt 3, Schaltplan-Aussage vereinheitlicht
2026-10-28 fix(pruefung): Timeout/Absturz nie gruen, -Only prueft Namen, inv global, Eval-Empty auch in check.ps1
    Kommentare in scad-Dateien korrigiert (Wiege, Common-Header).
    [madbuddy_case.scad, madbuddy_roboter.scad, xiao_cam_common.scad]
2026-10-28 fix: Timeout beendet ganzen OpenSCAD-Prozessbaum, Pin-1-Hinweis im Messschritt korrigiert
2026-10-29 feat(cam): Spike XIAO – Kamera und Gesichtserkennung, Messung am Geraet
    [partitions.csv]
2026-10-29 fix(cam): Konsole und Serial auf USB, UART0 frei fuer den CYD
